AnnaHruskova/Hruskova_Portable_Audio_Player_with_USB_Audio_Interface/README.md

Prostudujte principy digitálního zpracování a reprodukce zvukových signálů v embedded systémech se zaměřením na běžné formáty digitálního audia, komprimované formáty, audio D/A převodníky a jejich rozhraní. Analyzujte možnosti realizace přenosného audio zařízení na platformě STM32 a navrhněte systémovou architekturu umožňující přehrávání zvukových souborů z paměťové karty a po připojení k počítači provoz zařízení jako USB zvukové karty a velkokapacitního úložiště. Zvolte vhodný mikrokontrolér, D/A převodník, paměťové médium, výstupní audio část, displej a systém napájení. Navrhněte elektrické a mechanické řešení zařízení, zpracujte schéma a desku plošných spojů zahrnující potřebné audio, USB, ovládací a napájecí obvody včetně bateriového napájení a nabíjení a připravte výrobní podklady prototypu. Realizujte a oživte zařízení a implementujte programové vybavení pro přehrávání zvukových souborů z paměťové karty, zejména ve formátech WAV a MP3, včetně základního uživatelského rozhraní. Implementujte USB rozhraní umožňující provoz zařízení jako USB zvuková karta a současně přístup k paměťovému médiu jako velkokapacitní úložiště a vyřešte přepínání jednotlivých provozních režimů. Experimentálně ověřte funkčnost zařízení, kvalitu reprodukce, USB komunikaci a uživatelské ovládání. Změřte spotřebu, stanovte předpokládanou dobu provozu na baterii a zhodnoťte možnosti dalšího rozšíření.

V rámci semestrální práce zpracujte teoretický rozbor problematiky, navrhněte systémovou architekturu a zpracujte elektrický a mechanický návrh zařízení včetně schématu, desky plošných spojů a výrobních podkladů.
