AnnaHruskova/Hruskova_Portable_Audio_Player_with_USB_Audio_Interface/latex_sablona/sablona-prace.pdf

## TITULNÍ LIST

Namísto této stránky vložte titulní list (s logem) vygenerovaný v IS VUT.

## ZADÁNÍ

Namísto této stránky vložte stránku zadání FEKT vygenerovanou v IS VUT.

ABSTRAKT

Abstrakt práce v originálním jazyce

KLÍČOVÁ SLOVA

Klíčová slova v originálním jazyce

ABSTRACT
Překlad abstraktu (v angličtině, pokud je originálním jazykem čeština či slovenština; v češtině či slovenštině, pokud je originálním jazykem angličtina)

KEYWORDS
Překlad klíčových slov (v angličtině, pokud je originálním jazykem čeština či slovenština; v češtině či slovenštině, pokud je originálním jazykem angličtina)

Vysázeno pomocí balíčku thesis verze 4.13; https://latex.fekt.vut.cz/

HRUŠKOVÁ, Anna. Přenosný audio přehrávač s USB zvukovým rozhraním. Semestrální

práce. Brno: Vysoké učení technické v Brně, Fakulta elektrotechniky a komunikačních technologií, Ústav telekomunikací, 2026. Vedoucí práce: Ing. Ondřej Krajsa, Ph.D.

## Prohlášení autora o původnosti díla

Jméno a příjmení autora: | Anna Hrušková
VUT ID autora: | 270800
Typ práce: | Semestrální práce
Akademický rok: | 2026/27
Téma závěrečné práce: | Přenosný audio přehrávač s USB zvuko- vým rozhraním

Prohlašuji, že svou závěrečnou práci jsem vypracoval samostatně pod vedením vedoucí/ho závěrečné práce a s použitím odborné literatury a dalších informačních zdrojů, které jsou všechny citovány v práci a uvedeny v seznamu literatury na konci práce. V souvislosti s vytvořením závěrečné práce jsem neporušil zásady a doporučení VUT k využívání generativní umělé inteligence.

Jako autor uvedené závěrečné práce dále prohlašuji, že v souvislosti s vytvořením této závěrečné práce jsem neporušil autorská práva třetích osob, zejména jsem nezasáhl nedovoleným způsobem do cizích autorských práv osobnostních a/nebo majetkových a jsem si plně vědom následků porušení ustanovení S 11 a následujících autorského zákona č. 121/2000 Sb., o právu autorském, o právech souvisejících s právem autorským a o změně některých zákonů (autorský zákon), ve znění pozdějších předpisů, včetně možných trestněprávních důsledků vyplývajících z ustanovení části druhé, hlavy VI. díl 4 Trestního zákoníku č. 40/2009 Sb.

Brno | | | | podpis autora∗

∗Autor podepisuje pouze v tištěné verzi.

PODĚKOVÁNÍ

Rád bych poděkoval vedoucímu bakalářské/diplomové/disertační práce panu Ing. XXX YYY, Ph.D. za odborné vedení, konzultace, trpělivost a podnětné návrhy k práci.

## Obsah

Úvod | 23
1 Digitální zpracování a reprodukce zvuku v embedded systémech | 25
2 Řešení návrhu desky plošných spojů | 31
2.1.1 | Lineární nabíječ akumulátoru s řízením napájecí cesty | . . . . 31
3 Výsledky studentské práce | 39
Závěr | 41
Literatura | 43
Seznam symbolů a zkratek | 45
Seznam příloh | 47
A Obsah elektronické přílohy | 49

## Seznam obrázků

2.1 Typický nabíjecí cyklus Li-Ion baterie | 32
2.2 Typické zapojení PCM510x | 34

## Seznam tabulek

1.1 Struktura hlavičky RIFF souboru WAV | 27
1.2 Struktura bloku fmt pro PCM WAV | 28
1.3 Struktura bloku data | 28

## Seznam algoritmů

## Seznam výpisů

## Úvod

Přenosný Přehrávač Médií – Portable Media Player (PMP) či Digitální Audio Přehrávač – Digital Audio Player (DAP) jsou přenosná zařízení určená pro uložení a přehrávání médií, jako je audio, video apod. Jedná se o zařízení kapesní velikosti, napájeného akumulátorem. Rovněž zvukové karty jsou dnes povětšině prodávány samostatně jako drahá zařízení, ačkoliv jejich hlavním úkolem je převádět digitální signál na analogový.
Cílem semestrální práce je navrhnout a realizovat rozměrem malé, kapesní zařízení, jenž bude pomocí procesoru STM32U575VIT6Q schopno z SD karty přehrávat audio soubory uložené na microSD kartě, a zároveň bude po připojení jako externí zařízení k počítači schopno reprodukovat a směřovat audio signál z počítače do sluchátek uživatele.

23

## 1 Digitální zpracování a reprodukce zvuku v

## embedded systémech

## 1.1 A/D a D/A převodníky

Jakmile je docíleno převodu zvukové energie na energii elektrickou, dalším krokem může být konverze z analogové roviny do digitální. Pro opačný přechod se využívá Digitálně analogový převodník – Digital to analog coverter (DAC). Audio Codec je poté označení pro ADC a DAC hardwarové komponenty dostupné v jednom pouzdře. Při rekonstrukci signálu z digitální do analogové podoby je důležité, aby signál splňoval Nyquistovu-Shannonovu vzorkovací podmínku. Ta hovoří o tom, že nejvyšší obsažená frekvence v původním pásmově omezeném signálu vynásobená dvěma by měla být menší než vzorkovací frekvence, protože ve spektru navzorkovaného signálu se kromě původního spektra nacházejí i jeho kopie posunuté o celočíselné násobky vzorkovací frekvence. Lze vyjádřit vztahem

fs > 2fmax, | (1.1)

kde fs je vzorkovací frekvence a fmax je nejvyšší frekvence původního signálu. Při dodržení Nyquist-Shannonova teorému se kopie nepřekrývají, lze tak spektrum oddělit rekonstrukčním filtrem dolní propust a ze vzorků původní signál obnovit. Při nedodržení vzniká aliasing, jenž ani D/A převod ani rekonstrukční filtr nemohou odstranit [2, s. 96–99]. Filtry dolní propusti nejsou ideální a takřka žádné praktické využití nebude vzorkovat přesně na dvojnásobku, proto je jedna z často využívaných vzorkovacích frekvencí pro reprodukci hudby 44,1 kHz a ne 40 kHz [1].

## 1.2 Delta-sigma D/A převodníky

DAC převodníky lze rozdělit na dvě kategorie: ty pracující na Nyquistově vzorkovací frekvenci a převodníky s převzorkováním. Převodníky z první kategorie pracují s poměrem 1:1 vstupní ku výstupním vzorkům a každý vzorek je samostatně zpracován, bez ohledu na předchozí vzorky; jsou bezpamětné. Přivedením vstupního digitálního slova s bity b1 až bN vede tedy na výstup

Uout = Uref (︁
b12

−1 + b22

−2 + · · · + bN 2

−N ,

)︁
| (1.2)

kde Uref je referenční napětí nezávislé na předchozím slově. Pro tento typ převodníků může být vzorkovací frekvence fvz až na spodní hranici splnění Nyquistova kritéria. Technologický rozptyl parametrů (souběh, anglicky component matching, matching accuracy, vyjadřující jak přesně jsou si podobné součástky stejného typu a jmenovité

25 hodnoty) je v praxi omezen asi na cca 0,02 %. Tím pádem je ovlivněn i Efektivní počet bitů – Effective Number of Bits (ENOB) na přibližně 12, ale mnoho audio zařízení vyžadují až 18 či 20 bitů. Takové Nyquistovy převodníky vyžadují více času, jsou pro zpracování audio signálu příliš pomalé.
Převzorkovací převodníky jsou schopny dosáhnout až 20 ENOB při vyšších rychlostech, využívají vzorkovací frekvenci 8krát až 512krát vyšší než je Nyquistova frekvence a výstup generují na základě předchozích hodnot (obsahují paměťové prvky).

## 1.3 PCM

Nejjednodušší digitální reprezentací signálu je Pulzně kódová modulace – Pulse-code modulation (PCM); pro každou periodu vzorkování je okamžitá hodnota analogového signálu (amplituda) zakódována s příslušnou digitální úrovní. Parametry PCM jsou vzorkovací frekvence, například 44,1 kHz, používaná nejčastěji u CD, až po hodnoty 192 kHz, a rozlišení hodnot digitálních úrovní (bitové hloubky vzorku). Každé kvantování přináší do nového signálu kvantizační šum, nikdy nelze okamžité hodnoty analogového signálu interpolovat s dokonalo přesností, jde to pouze limitně. Při vstupním rozsahu o dané velikosti vede nižší bitová hloubka k větší kvantizační chybě.
Datový tok závisí i na počtu kanálů. Pokud je vzorkovacá frekvence 44,1 kHz a bitová hloubka je 16 bitů, na jeden kanál připadá 705,6 kbit/s. Stereofonní signál obsahuje kanály dva, proto daotvý tok jeho vzorků je 1411,2 kbit/s (tedy 176,4 kB/s) [1, s. 181].
Stereofonní zvukový záznam o vzorkovací frekvenci 44,1 kHz, bitové hloubce 16 bit o délce tří minut bude tedy vyžadovat velikost úložiště 31,752 MB, podle výpočtu

Velikost =

44100 · 16 · 2 · 180
8
= 31752000B = 31, 752MB | (1.3)

## 1.4 Formáty audio souborů

Jesliže jsou zvukové soubory již k dispozici, je potřeba zajistit jejich správné načtení a interpretaci. Existují nekomprimované a komprimované zvukové soubory. U nekomprimovaného PCM jsou uloženy hodnoty jednotlivých vzorků bez jakékoliv komprese. Při jejich zpracování a následném přehrávání je zapotřebí získat informace o jejich formátu, vyhledat zvuková data a následně je zpracovat podle zjištěných parametrů. Komprimované audio záznamy vyžadují navíc dekódování, kdy se z komprimované reprezentace dat získá posloupnost jednotlivých zvukových vzorků. Komprese může být bezztrátová nebo ztrátová.

26

### 1.4.1 Formát souboru WAV

Zvukový formát WAV běžně obsahuje nekomrpimované PCM, může obsahovat ale i
jiné způsoby kódování. Popis zvukového formátu používaný ve struktuře WAVEFORMATEX zahrnuje identifikaci kódování (wFormatTag), počet kanálů (nChannels), vzorkovací frekvenci jednotlivých kanálů (nSamplesPerSec), průměrný bajtový tok (nAvgBytesPerSec), blokové zarovnání (nBlockAlign) a počet bitů na vzorek (wBitsPerSample). Pro celočíselné PCM označuje kódování konstanta WAVE_FORMAT_PCM s hodnotou 0x0001; blokové zarovnání pak odpovídá velikosti vzorkovacího rámce [3].
Formát WAV (Waveform Audio File Format) je založen na kontejnerovém formátu RIFF (Resource Interchange File Format). Soubor ve formátu RIFF se skládá z jednotlivých bloků označovaných jako chunks. Každý blok je identifikován čtyřznakovým identifikátorem FOURCC (Four-Character Code).
V případě běžného nekomprimovaného PCM WAV souboru se struktura skládá z hlavičky RIFF a následných bloků fmt a data. Následující tabulky popisují základní variantu nekomprimovaného PCM WAV souboru s 16bajtovou datovou částí bloku fmt a bez dalších vložených bloků. Offsety jsou uváděny od začátku souboru. V této variantě začínají vlastní zvuková data na offsetu 44 B. Základní struktura hlavičky RIFF je uvedena v tabulce 1.1.

Tab. 1.1: Struktura hlavičky RIFF souboru WAV

Pole | Offset [B] Velikost [B] | Význam
ChunkID | 0 | 4 | ASCII řetězec RIFF
ChunkSize | 4 | 4 | Velikost souboru bez prvních 8 bajtů
Format | 8 | 4 | ASCII řetězec WAVE

Pole ChunkID obsahuje posloupnost znaků RIFF, odpovídající bajtům 52 49 46
46. Pole ChunkSize udává velikost zbývající části RIFF bloku, tedy v případě základního WAV souboru velikost celého souboru zmenšenou o 8 bajtů. Pole Format obsahuje identifikátor WAVE.
Za hlavičkou RIFF následuje blok fmt, popisující formát uložených zvukových dat. Jeho struktura pro nekomprimovaný PCM signál je uvedena v tabulce 1.2. Hodnota pole ByteRate je určena vztahem

ByteRate = SampleRate · NumChannels ·

BitsPerSample
8
. | (1.4)

Podobně lze velikost jednoho vzorkovacího rámce vyjádřit jako

BlockAlign = NumChannels ·

BitsPerSample
8
. | (1.5)

27

Tab. 1.2: Struktura bloku fmt pro PCM WAV

Pole | Offset [B] Velikost [B] Význam
Subchunk1ID | 12 | 4 | ASCII řetězec fmt
Subchunk1Size | 16 | 4 | Velikost datové části bloku; v popiso-
| | | vané základní variantě 16 B
AudioFormat | 20 | 2 | Formát zvukových dat; hodnota 1
| | | označuje PCM
NumChannels | 22 | 2 | Počet zvukových kanálů; 1 pro mono, 2
| | | pro stereo
SampleRate | 24 | 4 | Vzorkovací frekvence v Hz, například
| | | 48 000 Hz
ByteRate | 28 | 4 | Počet bajtů za sekundu
BlockAlign | 32 | 2 | Počet bajtů jednoho vzorkovacího
| | | rámce
BitsPerSample | 34 | 2 | Bitová hloubka jednoho vzorku

Vzorkovací rámec zde představuje vzorky všech kanálů náležející ke stejnému okamžiku vzorkování. Například u 16bitového stereofonního signálu má jeden rámec velikost 4 B.
Za blokem fmt se v základní podobě PCM WAV souboru nachází blok data, který obsahuje vlastní zvuková data.

Tab. 1.3: Struktura bloku data

Pole | Offset [B] Velikost [B] Význam
Subchunk2ID | 36 | 4 | ASCII řetězec data
Subchunk2Size | 40 | 4 | Počet bajtů zvukových dat
Data | 44 | proměnná | Jednotlivé vzorky zvukového signálu

Velikost datové části lze pro PCM signál vyjádřit jako

Subchunk2Size = Nsamples · NumChannels ·

| | | BitsPerSample
| | | 8
, | (1.6)

kde Nsamples představuje počet vzorků jednoho kanálu.
Vícebajtové číselné hodnoty jsou ve standardním WAV souboru ukládány v pořadí little-endian. Například 32bitová hodnota 0x12345678 je tedy v souboru uložena jako posloupnost bajtů 78 56 34 12. Čtyřznakové identifikátory, například RIFF, WAVE, fmt nebo data, jsou naproti tomu ukládány přímo jako posloupnost ASCII znaků[?].

28

Načítání WAV do STM32

https://www.phippselectronics.com/how-to-play-a-wav-file-on-stm32/

29

## 2 Řešení návrhu desky plošných spojů

## 2.1 Napájecí část

### 2.1.1 Lineární nabíječ akumulátoru s řízením napájecí cesty

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

ICHG =

KISET
R5

=

890AΩ
3160Ω
≈ 282mA. | (2.1)
- dva režimy napájení pomocí pinů EN2 (stáhnutý ke GND, vždy tedy logická 0) a pin EN1 řízený MCU STM32 a současně připojen na R2 = 100 kOhm k VBUS. Pokud je VBUS přítomný, ale je neaktivní řízení z MCU, výchozí stav je USB500, pokud EN2 = 0 (default) a EN1 = 1. POkud EN1 je stařen do logické nuly, nastaví se stav USB100. Vstupní limit je společný pro napájení přehrávače i nabíjení baterie. Po připojení USB se automaticky měnič zapne
- pin OUT: při dostatečném vstupním napájení je OUT regulovaný na cca 4,4V, baterie se mezitím nabíjí na 4,2V. síť ;"sys_power"neposkytuje stabilizovaných 3,3V, bez vstupního napětí je tato větev napájena z baterie přes vnitřní tranzistor. Napětí 3,3V vytváří až navazující měnič.
- konfigurace kondenzátorů kolem C4 na vstupu IN C2 na výstupu OUT, oba kapacitu 4,7uF. Kondenzátor C3 mezi BAT a GND má 10 uF.
- tepelné ztráty lineárního nabíjení jsou podle P = (Uin - Ubat) Icharge, při 5V pro Uin, 3,7V Ubat a Icharge 282 mA vychází P = 0,37 W. tepelná regulace může

31 snížit nabíjecí proud, podle datasheetu 9.3.5.8 je již zabudovaná v BQ24074, obvod sám sleduje svou vnitřní teplotu a reguluje nabíjecí proud. Hondota P = 0,37 W představuje pouze ztráty spojené s nabíjecím proudem,
- odvod tepla z BQ24074 zajištěn propojením zemní mědí (GND) a exponované tepelné plošky pouzdra, podle doporučení návrhu DPS.
- zapojení je připraveno pro sledování teplopty akumulátoruy pomocí NTC termistoru připojeného třetím vývodem J2 na vstup TS
- z datasheetu byl vzán tento průběh nabíjení baterie LiIon pro ilustraci


Obr. 2.1: Typický nabíjecí cyklus Li-Ion baterie

Zelená přerušovaná křivka v grafu 2.1 představuje napětí na svorkách baterie UBat, červená křivka pak představuje proud jdoucí do baterie IBat. Osa X představující časovou osu, je schematická, nelze určit jednotlivou délku, skutečné hodnoty jednotlivých fází by mohly být doplněny měřením audio zařízení. Jde pouze o principiální ilustrativní průběh, ne o skutečnou měřenou charakteristiku. VBat(reg) zde představuje regulované koncové nabíjecí napětí, pro návrh přenosného audio přehrávače jde o 4,2 V. VLow je práh přechodu z přednabíjení do hlavního nabíjení, hodnota pro návrh typicky 3,0V, s mezemi 2,9 V-3,1V. Io(chg) je nastavený proud nabíjecí fáze, nastavený podle schématu na 282 mA. IPrechg je proud přednabíjení, nastavený na 28 mA (0.1xIo) Iterm je proudový práh ukončení nabíjení, pro režim USB100 je to 9,3 mA, pro režim USB500. Pin ITERM je ponechán nezapojený, typický ukončovací proud činí proto přibližně 28,2 mA v režimu USB500 a 9,3 mA v režimu USB100.

32

Precharge

Jestliže má baterie před zahájením nabíjení napětí nižší než Vlowv, nabíječ nejprve použije malý proud IPrechg, proto je červená křivka průběhu nabíjení zde konstantní na jedné nízké úrovni. Náboj dodávaný nabíječem BQ24074 postupně zvyšuje napětí baterie (zelená postupně rostoucí křivka). Tento proces je zapotřebí, jestliže se baterie nachází v silně vybitém stavu, dodávání proudu IPrechg nemusí tedy být při každém nabíjení. Pokud je prah Vlowv překročen, poté nabíječ může zvýšit proud, začíná pak hlavní nabíjecí fáze. Vlow řídí pouze přechod z přednabíjecí řásti do plně nabíjecí (do fáze nabíjení konstantním proudem).

Fast Charge CC

CC = constant current, nabíječ udržuje nabíjecí proud přibližně na hodnotě Io(chg), napětí na baterii postupně roste. Proud nastavuje rezistor R5 ze schématu zapojení, podle rovnice (2.1). Jakmile je dosaženo napětí na betrii 4,2V, přejde se na další část nabíjení.

CV Taper, nabíjení konstantním napětím

CV = constant voltage, nabíječ v této fázi udržuje napětí baterie okolo Vbat(reg) (vodorovná zelená křivka). Velikost dodávaného proudu klesá. Taper = postupné snižování proudu. Proud nemusí klesat lineárně, závisí na velikosti samotné baterie (kapacitě a vlastnostech akumulátoru), teplotě nebo i na stavu opotřebení akumulátoru. Nabíječ dále sleduje dosažení ITerm, poté může být nabíjení ukončeno.

done, ukončení nabíjení

Při této fázi nabíječ přestane dodávat proud do baterie,na grafu se jedná o pokles z Iterm na 0. Pin CHG je typu open drain, tedy výstup s otevřeným odtokem tranzistoru MOSFET. ve stavu vysoké impedance přestává stahovat signál k zemi, rezisotr R8 ze schématu přitáhne CHG_status k 3,3V. Tento stav nastává i při nepřítomném vstupním napětí VBUS z UBSC. (po odpojení usbc neprobíhá nabíjení, výstup CHG přejde do stavu vysoké impedance, pokud přehrávač dále beží z baterie, R8 přitáhne chg_status na 3,3V). Výstup CHG současně ovládá LED D2 napájenou z VBUS přes rezistor R36 = 1,5 kOhm. Úroveň je stejná při dokončeném nabíjení i při odpojení

usb-c, proto je důležité i sledovat CHG_PGOOD signalizující přítomost platného vstupního napájení. (Vysoká úroveň CHG_STATUS sama nepotvrzuje úplné nabití. Stav je nutné vyhodnocovat spolu se signálem CHG_PGOOD, který při platném vstupním napájení přechází do logické nuly.“))

33

## 2.2 TPS63070

## 2.3 Audio řetězec

### 2.3.1 D/A převodník PCM5102A

typické zapojení podle datasheetu


Obr. 2.2: Typické zapojení PCM510x

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

34

- C26 - nízká parazitní indukčnost, odvádí ryché proudové špičky - doporučeno TI
- C27 - dobrý na pomalejší změny odběru proudu - doporučeno TI
- C28 (100 nF, potlačuje rychlé rušení vznikající při spínání nábojové pumpy) a C29 (10 uF, stabilizuje 3,3 V napájení) - protože pin CPVDD odebírá proud v pulzech, pulzy mohou vytvoři rušení - hodnoty převzaté z doporučení Texas Instruments.
- C30 a C 31 - stejně jako u C26 a C27.
- C32 - filtrace a stabilizace interního LDO (interního napěťového regulátoru, vytářející cca 1,8 V z 3,3 V pro )
- C33 - filtrace vf

Výstupní analogový filtr RC

- kondenzátory C24, C25 filtrují vf složky pro každý kanál do země -> filtr dolní propust - aby filtr neovlivnil amplitudu/fázi slyšitelných vyšších tónů, volí se mezní frekvence 7 krát až 10 krát vyšší než 20 kHz. Hlavně je zapotřebí vyfiltrovat frekvence v MHz - hodnoty rezistory C22 a C23 jsou natolik nízké, že neovlivní úbytek sigálu na vstupní impedanci běžného koncového zesilovače.
fc =

1
2πRC =

1
2π·470·2,2·10⁻⁹ ≈ 154kHz

Sluchátkový zesilovač TPA6111A2D

Zesílení analogového stereofonního signálu z D/A převodníku PCM5102A je docíleno pomocí integrovaného sluchátkového zesilovače TPA6111A2D od Texas Instruments. Obvod obsahuje dva nezávislé zesilovací kanály v invertujícím zapojení, umožňuje provoz při 3,3 V.
Zesílení jednotlivých kanálů je určeno poměrem zpětnovazebního rezistoru RF a vstupního rezistoru RI , platí vztah Av = −

RF
RI

, kde pro RF i RI jsou zvoleny hodnoty 20 kohm, tedy Av = −

20komℎ
20koℎm = −1. Napěťové zesílení se tedy rovná jedné, rovno zesílení 0 dB, nedochází k změně amplitudy. Záporné znaménko zde vyjadřuje fázovou inverzi o 180 stupňů. Zvolená konfigurace odpovídá doporučenému zapojení uvedené v technické dokumentaci dané součástky.
Ekvivalentní odpor působící na invertující vstup zesilovače je dán paralelní kombinací RF a RI , Req =

RF RI
RF +RI

= 10, kΩ, tato hodnota je v rámci doporučení výrobcem, tedy od 5 kOhm do 20 kOhm.
Při návrhu bylo zohledněno rozdílné napěťové rozmezí výstupních signálů D/A převodníku a sluchátkového zesilovače. Převodník PCM5102A při plném vybuzení

35 dosahuje výstupní úrovně 2,1 V RMS (5,94 V špička špička, mnohem více, než zesilovač dokáže reprodukovat bez zkreslení). Regulace hlasitosti bude proto řícena digitálním útlumem PCM vzorků v mikrokontroléru STM32. Maximální úroveň bude stanovena s ohledem na výstupní napěťový rozkmit zesilovače, s ohledem na impedanci připojených sluchátek. . .
Ostatní komponenty ve schématu okolo TPA6111A2D
Vstupní vazební kondenzátory C38 a C39 (1 µF), sériově zapojeny mezi výstupy D/A převodníku a vstupy zesilovače, oddělující stejnosměrné složky signálu. Společně se vstupními rezistory R24 a R26 vytváření RC filtr horní propusti, určující dolní mezní kmitočet přenosové charakteristiky = 8 Hz.

fc =

1
2πRICI

=

1
2π · 20 × 10³
- 1 × 10⁻⁶
≈ 7,96 Hz | (2.2)

Kondenzátor C34 o kapacitě 1 uF, ovlivňuje časový průběh náběhu interního předpětí, čímž omezuje vznik nechtěných impulzů při zapnutí zesilovače. Blokovací kondenzátory C37 (potlačující vysokofrekvenční rušení a rychlé napěťové přechody), C40, zlepšují stabilitu napájení a omezují nežádoucí vlivy napájecího rušení na výstupní audio signál.

XC =

1
2πfC | (2.3)

S rostoucí frekvencí klesá kapacitní reaktance, kondenzátor představuje pro vf složky nízkoimpedanční cestu ke GND.
Výstupní vazební kondenzátory C17, C18 polarizované elektrolytické, zabraňují průchodu stejnosměrné složky do připojených sluchátek. Zvolená kapacita 470 µF pro sluchátka o impedanci 32 Ohm odpovídá dolní mezní frekvenci 10,58 Hz, podle

fc =

1
2πRLCout

=

1
2π · 32 · 470 × 10⁻⁶
≈ 10,58 Hz | (2.4)

### 2.3.2 Periferie

SD karta
displej

### 2.3.3 Napájení

Lithium-polymerový akumulátor (Li-Po) - vybíjecí charakteristiky? Power Path

36

## 2.4 Realizace Hardware části práce

### 2.4.1 Schéma zapojení napíjecí části

### 2.4.2 Schéma zapojení analogové audio části

Výpočet součástek kolem čipu PCM5102A
Výpočet součástek kolem čipu TPA6111A2D
- zpětnovazební rezistory pro zisk
- výpočet dolního mezního kmitočtu vstupních a výstupních kondenzátorů

### 2.4.3 Návrh PCB desky

Rozmístění součástek po desce

37

## 3 Výsledky studentské práce

Praktická část a výsledky studentské práce vhodně rozdělené do částí.

## 3.1 Programové řešení

Lorem [?].

## 3.2 Výsledky měření

Fusce

39

## Závěr

Není automatické hlídání teploty akumulátoru, R11 nahrazen NTC...

41

## Literatura

[1] KATZ, David J. a GENTILE, Rick. Embedded Media Processing. Burlington, MA: Newnes (Elsevier), 2005. ISBN 978-0-7506-7912-1.
[2] SMÉKAL, Zdeněk a SKLENÁŘ, Jaroslav. 1D and 2D Analog, Discrete, and

Digital Signal Processing. Brno: VUTIUM, 2023. ISBN 978-80-214-6143-7.

[3] MICROSOFT. WAVEFORMATEX structure (mmeapi.h) [online]. Microsoft Learn. Aktualizováno 2021-04-02 [cit. 2026-11-08]. Dostupné z:

https://learn.microsoft.com/en-us/windows/win32/api/mmeapi/ns-mmeapi-waveformatex. (https://learn.microsoft.com/en-us/windows/win32/api/mmeapi/ns-mmeapi-waveformatex)

43

## Seznam symbolů a zkratek

Li-Po | Lithium-polymerový akumulátor
PMP | Přenosný Přehrávač Médií – Portable Media Player
DAP | Digitální Audio Přehrávač – Digital Audio Player
DAC | Digitálně analogový převodník – Digital to analog coverter
PCM | Pulzně kódová modulace – Pulse-code modulation
ENOB | Efektivní počet bitů – Effective Number of Bits
SNR | Odstup signálu od šumu – Signal-to-Noise Ratio

45

## Seznam příloh

A Obsah elektronické přílohy | 49

47

## A Obsah elektronické přílohy

Elektronická příloha je často nedílnou součástí semestrální nebo závěrečné práce. Vkládá se do informačního systému VUT v Brně ve vhodném formátu (ZIP, PDF . . . ). Nezapomeňte uvést, co čtenář v této příloze najde. Je vhodné okomentovat obsah každého adresáře, specifikovat, který soubor obsahuje důležitá nastavení, který soubor je určen ke spuštění, uvést nastavení kompilátoru atd. Také je dobře napsat, v jaké verzi software byl kód testován (např. Matlab 2018b). Pokud bylo cílem práce vytvořit hardwarové zařízení, musí elektronická příloha obsahovat veškeré podklady pro výrobu (např. soubory s návrhem DPS v Eagle).
Pokud je souborů hodně a jsou organizovány ve více složkách, je možné pro výpis adresářové struktury použít balíček dirtree. (https://www.ctan.org/pkg/dirtree)
/ | kořenový adresář přiloženého archivu
logo | loga školy a fakulty
BUT_abbreviation_color_PANTONE_EN.pdf
BUT_color_PANTONE_EN.pdf
FEEC_abbreviation_color_PANTONE_EN.pdf FEKT_zkratka_barevne_PANTONE_CZ.pdf UTKO_color_PANTONE_CZ.pdf
UTKO_color_PANTONE_EN.pdf
VUT_barevne_PANTONE_CZ.pdf
VUT_symbol_barevne_PANTONE_CZ.pdf VUT_zkratka_barevne_PANTONE_CZ.pdf
obrazky | ostatní obrázky
soucastky.png
spoje.png
ZlepseneWilsonovoZrcadloNPN.png
ZlepseneWilsonovoZrcadloPNP.png
pdf | pdf stránky generované informačním systémem
student-desky.pdf
student-titulka.pdf
student-zadani.pdf
text | zdrojové textové soubory
literatura.tex
prilohy.tex
reseni.tex
uvod.tex
vysledky.tex
zaver.tex
zkratky.tex
sablona-obhaj.tex | hlavní soubor pro sazbu prezentace k obhajobě
sablona-prace.tex | hlavní soubor pro sazbu kvalifikační práce
thesis.sty | balíček pro sazbu kvalifikačních prací

49
