AnnaHruskova/Hruskova_Portable_Audio_Player_with_USB_Audio_Interface/latex/bc_in_progress.pdf

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

1.4.1 TVS ochrana SD karty

ESD/TVS obvody vhodné pro 3,32bitová

- rychlá doba sepnutí - rychlé zachycení tranzient·
- SDMMC komunikace probíhá na vysokých kmito£tech CITACE (20 aº 50 MHz),

je pot°eba aby TVS IP m¥l velmi nízkou parazitní kapacitu, jinak by CLK signál m¥l

zaoblené hrany

- TPD6E05U06RVZR, kapacita 0,47pF
- USBLC6-4SC6, kapacita 0,97pF, ale je nutné pouºít dva, uº mají footprint v

KiCADU

### 1.5. PCM5102A

typické zapojení podle datasheetu

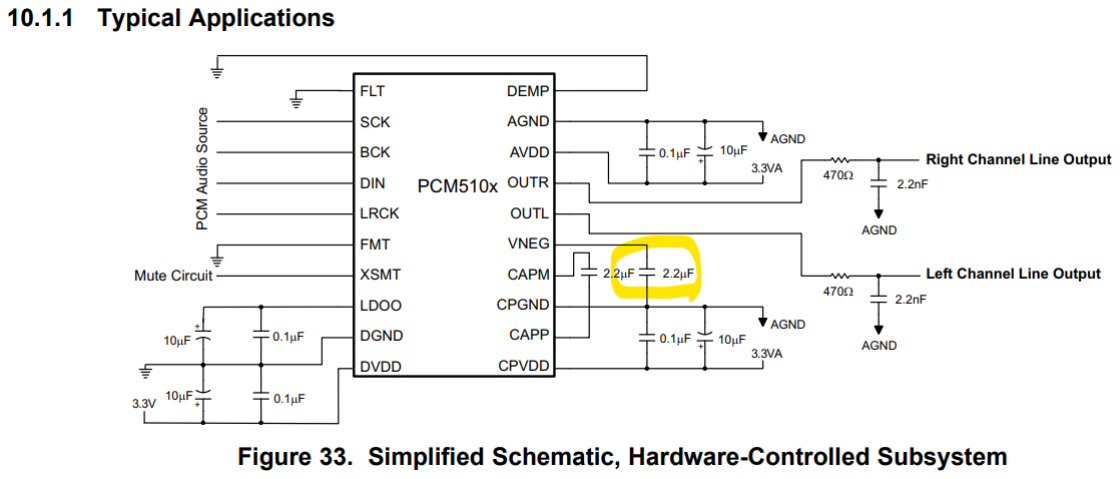
[picture p3: figure]

Obrázek 1: Typické zapojení PCM510x

Obsahuje integrovanou nábojovou pumpu - vytvá°í záporné napájecí nap¥tí p°estoºe

je £ip krmen 3,3 V. DAC má pak soust°ed¥ný výstup kolem 0V. Ale je zapot°ebí p°idat

dva kondenzátory mezi CAPP a CAPM piny (2 a 4, pouºívá se pro p°enos náboje), a

potom je²t¥ jeden mezi VNEG a CPGND piny (5 a , ltruje vztvo°ené záporné nap¥tí).

PIN 10 DEMP na GND, vypne se tam de-emphasis.

PIN 11 FLT na GND, takºe je pouºít normální FIR ltr.

PIN 12 SCK na GND, takºe je pouºít interní PLL bez externího MCLK

PIN 16 FMT na GND, jde o standardní I2S formát.

PIN 17 XSMT, p°ipojen na 3,3V.
- ip vyuºívá Direct Path, nepot°ebuje na audio výstupu odd¥lovací kondenzátory,

4

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

Pro zesílení st°ídavého nap¥tí platí

AV = −

RF

RIN

= −

10 kΩ
20 kΩ

= −0,5 V/V

fc,OUT =

1
2π · RL · COUT

fc,OUT =

1
2π · 32 Ω · 470 · 10⁻⁶ F

≈ 10,58 Hz

Podle doporu£ení TI by m¥l být efektivní odpor na invertujícím vsutpu být p°ibliºn¥

od 5K do 20K, p°i paralelním zapojneí 2 rezistor· o hodnot¥ 10K tedy

Re =

RfRi
Rf + Ri

=

10000 · 10000
10000 + 10000

= 5 kΩ

- C35 C36 blokují stejnosm¥rnou sloºku (nap¥tí kolem 1,65 V). Pouºít spí²e pola-

rizované kondenzátory.

- C34 potla£ení lupnutí p°i zapnutí

6

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
