AnnaHruskova/Hruskova_Portable_Audio_Player_with_USB_Audio_Interface/blok_schema.png

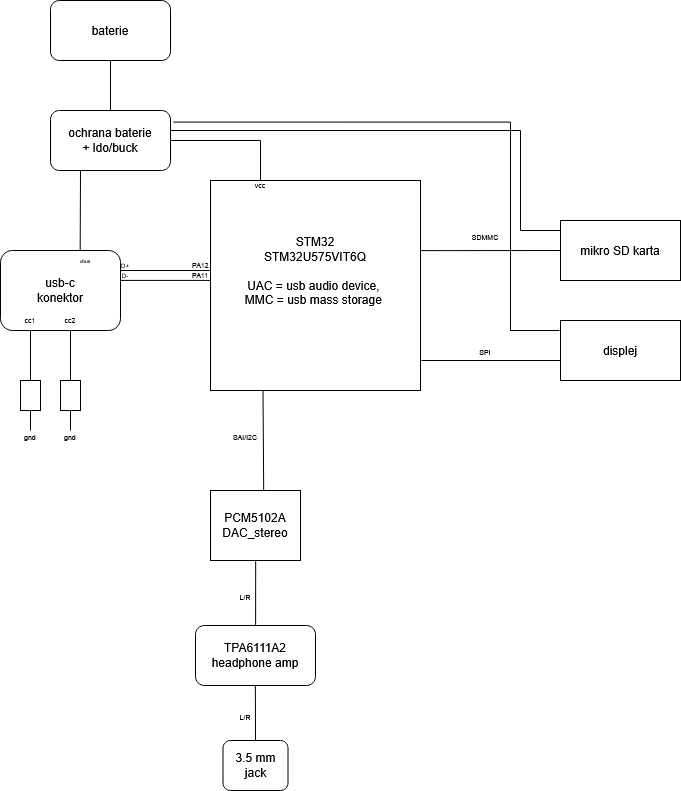
blok_schema.png
