AnnaHruskova/Hruskova_Portable_Audio_Player_with_USB_Audio_Interface/latex/LP5907_LDO_kondenzatory.png

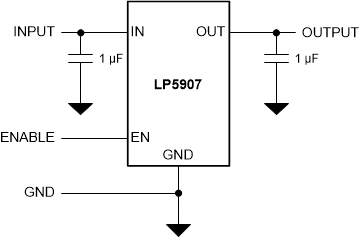
latex/LP5907_LDO_kondenzatory.png
