AnnaHruskova/Hruskova_Portable_Audio_Player_with_USB_Audio_Interface/latex/photos/battery_protection_circuit.png

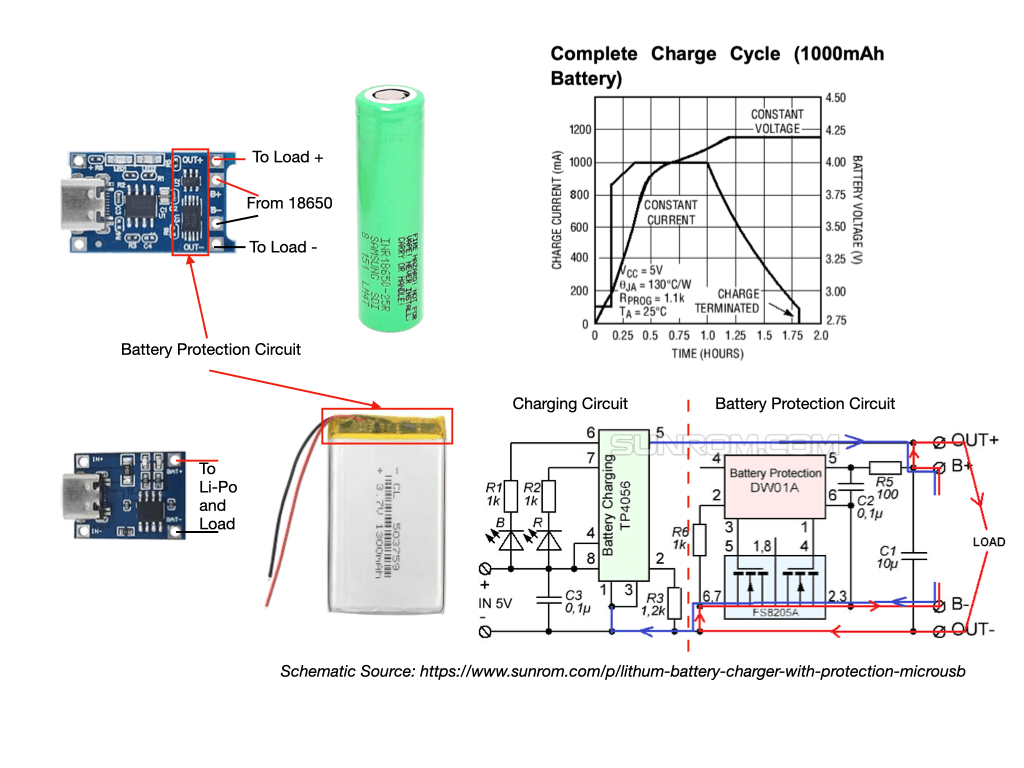
latex/photos/battery_protection_circuit.png
