AnnaHruskova/Hruskova_Portable_Audio_Player_with_USB_Audio_Interface/latex/photos/design-review-power-circuitry-for-lipo-powered-board-v0-ilq4whvbs4sa1.webp

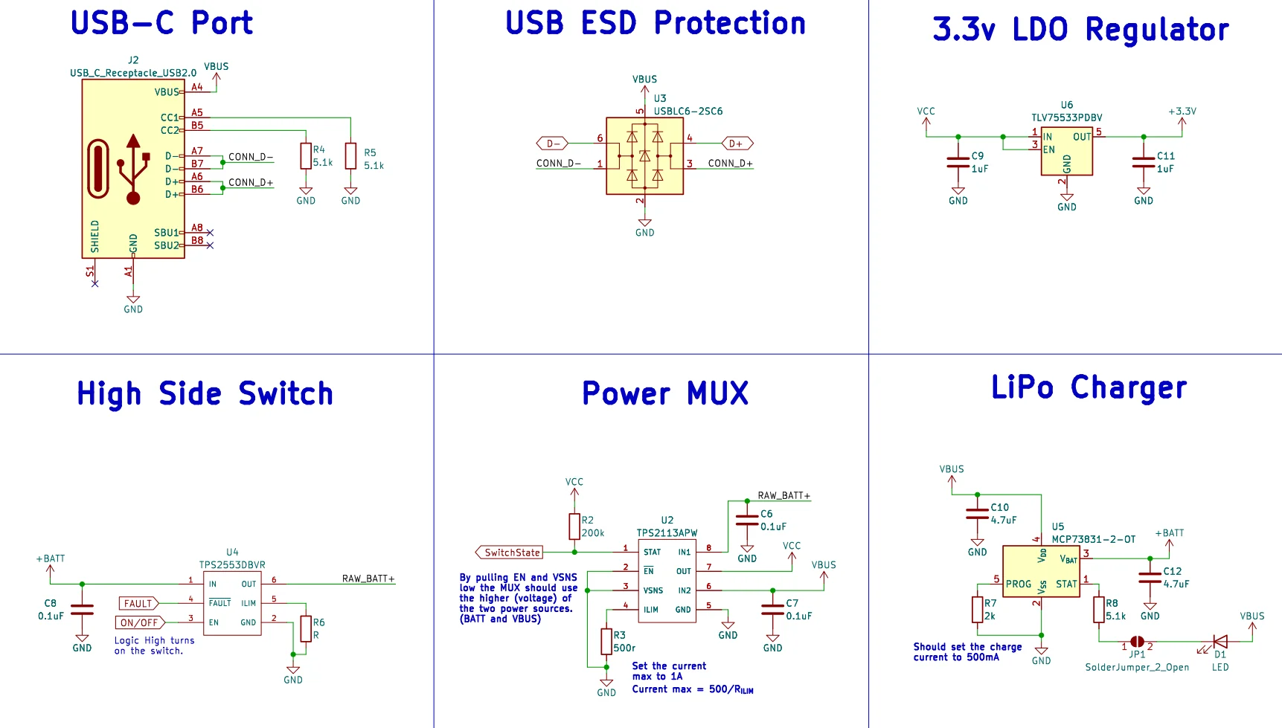
latex/photos/design-review-power-circuitry-for-lipo-powered-board-v0-ilq4whvbs4sa1.webp
