AnnaHruskova/Hruskova_Portable_Audio_Player_with_USB_Audio_Interface/latex/photos/esd_optimised_layout.png

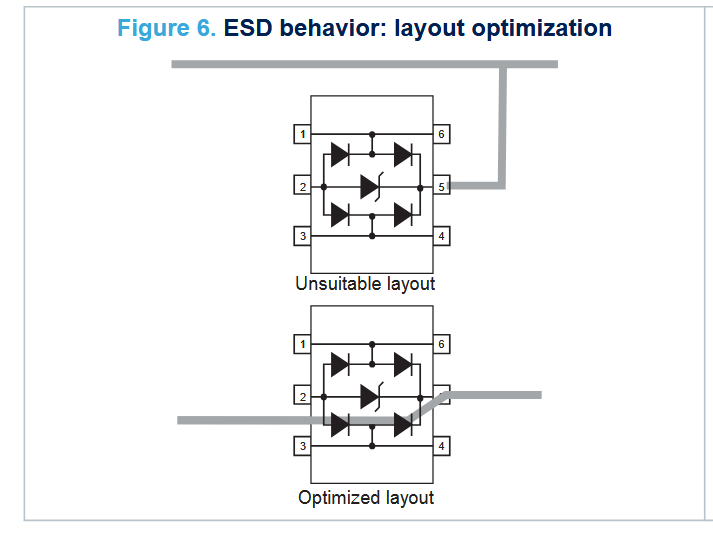
latex/photos/esd_optimised_layout.png
