AnnaHruskova/Hruskova_Portable_Audio_Player_with_USB_Audio_Interface/pcb_edit.png

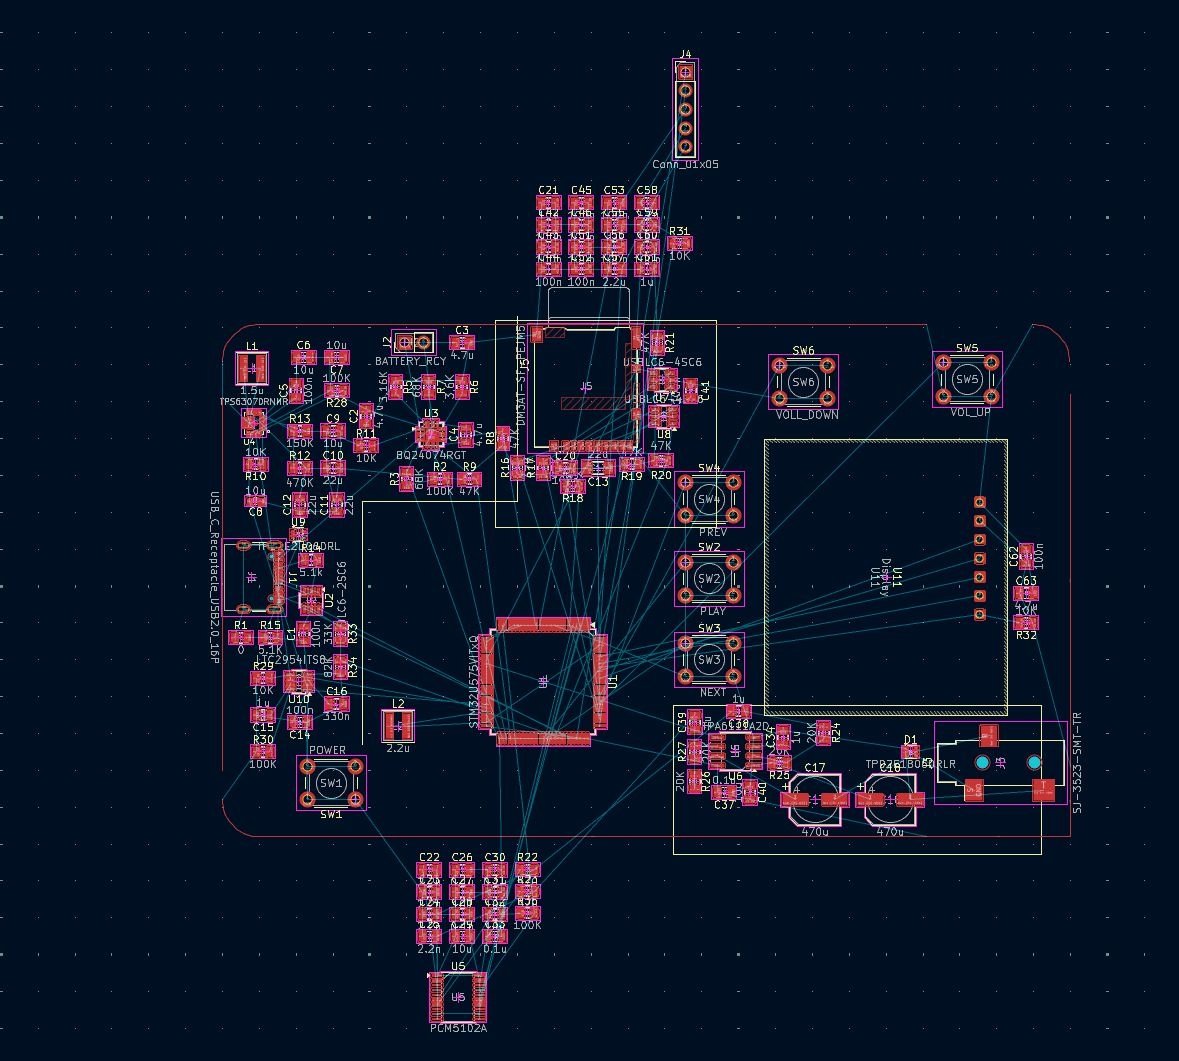
pcb_edit.png
