AnnaHruskova/Hruskova_Portable_Audio_Player_with_USB_Audio_Interface/components.xlsx

PCM5102A sheet
 |  | value | footprint | komponent | dostupnost JCSC | pozn
C22 | mezi CAPP, CAPM, nábojová pumpa | 2.2u | Capacitor_SMD:C_0805_2012Metric. | CL21B225KOFNNNE | 26K skladem | 2,2uF, 16 , X7R, +-10% | blízko pinům | https://product.samsungsem.com/mlcc/CL21B225KOFNNN.do
C23 | nábojová pumpa u VNEG | 2.2u | Capacitor_SMD:C_0805_2012Metric. | CL21B225KOFNNNE |  | stejny | blízko pinům | https://product.samsungsem.com/mlcc/CL21B225KOFNNN.do
C24 | L výstup RC filtr | 2,2 nF | Capacitor_SMD:C_0805_2012Metric. | Samsung CL21C222JBFNNNE |  | C0G/NP0 +- 5% --> níké zkreslení a stabilní fc
C25 | R výstup RC filtr | 2,2 nF | Capacitor_SMD:C_0805_2012Metric. | Samsung CL21C222JBFNNNE |  | stene jako C25
C26 | vf filtr, avdd | 0.1u | Capacitor_SMD:C_0805_2012Metric. | Yageo CC0805KRX7R9BB104 |  | 100n, 50V, X7R, | co nejblíže pinu AVDD, krátce do gnd
C27 | avdd zásobní c | 10u | Capacitor_SMD:C_1206_3216Metric | Murata GCJ31CR71C106KA15L |  | 16Vm X7R, 1206 - lepší rezerva vůči poklesu c | co nejblíže DAC
C28 | CPVDD - vf blok | 0,1u | Capacitor_SMD:C_0805_2012Metric. | Yageo CC0805KRX7R9BB104 |  | 100 nF, 50V, X7R
C29 | CPVDD - zásobní c | 10u | Capacitor_SMD:C_1206_3216Metric | Murata GCJ31CR71C106KA15L |  | 10 µF, 16 V, X7R, ±10 %, 1206.
C30 | DVDD - vf blok | 0,1u | Capacitor_SMD:C_0805_2012Metric. | Yageo CC0805KRX7R9BB104 |  | 100 nF, 50V, X7R | co nejblíže DAC
C31 | DVDD - zásobní c | 10u | Capacitor_SMD:C_1206_3216Metric | Murata GCJ31CR71C106KA15L |  | 10 µF, 16 V, X7R, ±10 %, 1206.
C32 | LDOO zásobní c | 10u | Capacitor_SMD:C_1206_3216Metric | Murata GCJ31CR71C106KA15L |  | 10 µF, 16 V, X7R, ±10 %, 1206. | ověřit C_eff při ~1,8V, požadavky LDO
C33 | LDOO - vf blok | 0,1u | Capacitor_SMD:C_0805_2012Metric. | Yageo CC0805KRX7R9BB104 |  | 100 nF, 50V, X7R | blízko LDOO
R22 | výstupní RC filtr | 470R | Resistor_SMD:R_0805_2012Metric | UNI-ROYAL 0805W8F4700T5E |  | 470 Ohm +-1%, 0805 výkonově stačí | S C24 tvoří LPF 1. řádu
R23 | výstupní RC filtr | 470R | Resistor_SMD:R_0805_2012Metric | UNI-ROYAL 0805W8F4700T5E |  | 470 Ohm +-1%, 0805 výkonově stačí | S C25 tvoří LPF 1. řádu
R35 |  | 100k | Resistor_SMD:R_0805_2012Metric | Yageo RC0805FR-07100KL |  | 100 kΩ, ±1 %, 0,125 W
U5 | D/A převodník | PCM5102A |  | TI PCM5102APWR |  | TSSOP-20, pitch 0,65mm, pouzdro APWR |  | https://www.ti.com/lit/gpn/PCM5102A
Headphone Amp sheet
 |  | value | footprint | komponent | dostupnost JCSC | pozn
C17 | polarizovaný, výstupní vazební R | 470u | Capacitor_SMD:CP_Elec_6.3x7.7 | Chemi-Con EMZR100ARA471MF80G |  | 470 µF, 10 V, ±20 %, hliníkový elektrolyt, Ø6,3 × 7,7 mm. ESR nejvýše 0,16 Ω při 100 kHz.
C18 | polarizovaný, výstupní vazební L | 470u | Capacitor_SMD:CP_Elec_6.3x7.7 | Chemi-Con EMZR100ARA471MF80G |  | 470 µF, 10 V, ±20 %, hliníkový elektrolyt, Ø6,3 × 7,7 mm. ESR nejvýše 0,16 Ω při 100 kHz.
C34 | bypass, stabilizace interního VDD/2 | 1u | Capacitor_SMD:C_0805_2012Metric. | Murata GRM21BR71C105KA01L |  |  | blízko pinu bypass
C37 | vcc pin U6, blokování napájení | 100n | Capacitor_SMD:C_0805_2012Metric | Murata GRM21BR71H104KA01L |  | 100 nF, 50 V, X7R, ±10 %, 0805. | C37 blízko pinu u U6
C38 | vstupní vazební kondenzátor | 2,2u | Capacitor_SMD:C_0805_2012Metric | Murata GRM21BR71C225KA12L
C39 | vstupní vazební | 2,2u | Capacitor_SMD:C_0805_2012Metric | Murata GRM21BR71C225KA12L
C40 | X5R | 10u | Capacitor_SMD:C_0805_2012Metric | Murata GRM21BR61C106KE15L |  | 10 µF, 16 V, X5R, ±10 %, 0805.
R24 |  | 20k | Resistor_SMD:R_0805_2012Metric | Yageo RT0805BRD0720KL |  | 20 kΩ, ±0,1 %, 0,125 W
R25 |  | 20k | Resistor_SMD:R_0805_2012Metric | Yageo RT0805BRD0720KL |  | 20 kΩ, ±0,1 %, 0,125 W
R26 |  | 20k | Resistor_SMD:R_0805_2012Metric | Yageo RT0805BRD0720KL |  | 20 kΩ, ±0,1 %, 0,125 W
R27 |  | 20k | Resistor_SMD:R_0805_2012Metric | Yageo RT0805BRD0720KL |  | 20 kΩ, ±0,1 %, 0,125 W
U6 | TPA6111A2DR, varianta SOIC-8, podpora napájení 3,3V |  | Package_SO:SOIC-8_3.9x4.9mm_P1.27mm
D1 | double channel ESD ochrana, obousměrná |  | Package_TO_SOT_SMD:SOT-563 | TI TPD2E1B06DRLR |  |  | blízko na zem, blízko na jack
J3 | 3,5mm stereo jack TRS |  | Connector_Audio:Jack_3.5mm_CUI_SJ-3523-SMT_Horizontal | Same Sky SJ-3523-SMT-TR
User interface sheet
 |  | value | footprint | komponent | dostupnost JCSC | pozn |  | datahseet, JCSC
C62 | omezuje rychlé napájecí špičky, filtrace vf rušení | 100n | Capacitor_SMD:C_0805_2012Metric | Murata GRM21BR71H104KA01L | j |  |  | https://www.lcsc.com/product-detail/C77082.html?s_z=n_q_Murata%2520GRM21BR71H104KA01L
C63 | omezení kolísání napájení při změnách odběru | 4,7u | Capacitor_SMD:C_0805_2012Metric | Murata GRM21BR71C475KE51L | j |  |  | https://www.lcsc.com/product-detail/C408144.html?s_z=n_q_Murata%2520GRM21BR71C475KE51L
R32 | drží signál CS neaktivní při rozběhu procesoru |  | Resistor_SMD:R_0805_2012Metric | Yageo RC0805FR-0710KL | j |  |  | https://www.lcsc.com/product-detail/C84376.html?s_z=n_q_Yageo%2520RC0805FR-0710KL
U11 | vlastní zakoupený |  |  |  | vlastní zakoupený
SW2 | Button_Switch_THT:SW_PUSH_6mm | tht |  | Omron B3F-1000 | j |  |  | https://www.lcsc.com/product-detail/C93157.html?s_z=n_q_Omron%2520B3F-1000
SW3 | Button_Switch_THT:SW_PUSH_6mm | tht |  | Omron B3F-1000 | j |  |  | https://www.lcsc.com/product-detail/C93157.html?s_z=n_q_Omron%2520B3F-1000
SW4 | Button_Switch_THT:SW_PUSH_6mm | tht |  | Omron B3F-1000 | j |  |  | https://www.lcsc.com/product-detail/C93157.html?s_z=n_q_Omron%2520B3F-1000
SW5 | Button_Switch_THT:SW_PUSH_6mm | tht |  | Omron B3F-1000 | j |  |  | https://www.lcsc.com/product-detail/C93157.html?s_z=n_q_Omron%2520B3F-1000
SW6 | Button_Switch_THT:SW_PUSH_6mm | tht |  | Omron B3F-1000 | j |  |  | https://www.lcsc.com/product-detail/C93157.html?s_z=n_q_Omron%2520B3F-1000
SD_card sheet
 |  | value | footprint | komponent | dostupnost JCSC | pozn |  | datasheet, web
C13 | zásoba pro napájení sd karty | 22u | Capacitor_SMD:C_1206_3216Metric | Samsung CL31A226KAHNNNE | j | 22 µF, 25 V, X5R, ±10 % |  | https://www.digikey.com/en/products/detail/samsung-electro-mechanics/CL31A226KAHNNNE/3888705
C20 | blokování napájení, blízko konektoru | 100n | Capacitor_SMD:C_0805_2012Metric | Yageo CC0805KRX7R9BB104 | j | 100 nF, 50 V, X7R, ±10 % |  | https://www.digikey.com/en/products/detail/yageo/CC0805KRX7R9BB104/302874
C41 | blokování napájecí větve ESD ochrany | 100n | Capacitor_SMD:C_0805_2012Metric | Yageo CC0805KRX7R9BB104 | j | 100 nF, 50 V, X7R, ±10 % |  | https://www.digikey.com/en/products/detail/yageo/CC0805KRX7R9BB104/302874
R16 | pull up datových, příkazových linek | 47k | Resistor_SMD:R_0805_2012Metric | Yageo RC0805FR-0747KL | j | 47 kΩ, ±1 %, 0,125 W |  | https://www.digikey.com/en/products/detail/yageo/RC0805FR-0747KL/727973
R17 | pull up datových, příkazových linek | 47k | Resistor_SMD:R_0805_2012Metric | Yageo RC0805FR-0747KL | j | 47 kΩ, ±1 %, 0,125 W |  | https://www.digikey.com/en/products/detail/yageo/RC0805FR-0747KL/727973
R18 | pull up datových, příkazových linek | 47k | Resistor_SMD:R_0805_2012Metric | Yageo RC0805FR-0747KL | j | 47 kΩ, ±1 %, 0,125 W |  | https://www.digikey.com/en/products/detail/yageo/RC0805FR-0747KL/727973
R19 | pull up datových, příkazových linek | 47k | Resistor_SMD:R_0805_2012Metric | Yageo RC0805FR-0747KL | j | 47 kΩ, ±1 %, 0,125 W |  | https://www.digikey.com/en/products/detail/yageo/RC0805FR-0747KL/727973
R20 | pull up datových, příkazových linek | 47k | Resistor_SMD:R_0805_2012Metric | Yageo RC0805FR-0747KL | j | 47 kΩ, ±1 %, 0,125 W |  | https://www.digikey.com/en/products/detail/yageo/RC0805FR-0747KL/727973
R21 | detekce vložené karty | 47k | Resistor_SMD:R_0805_2012Metric | Yageo RC0805FR-0747KL | j | 47 kΩ, ±1 %, 0,125 W |  | https://www.digikey.com/en/products/detail/yageo/RC0805FR-0747KL/727973
U7 | bez pinu 6, ESD ochrana | USBLC6-4SC6 | Package_TO_SOT_SMD:SOT-23-6 | STMicroelectronics USBLC6-4SC6 | j |  |  | https://www.digikey.com/en/products/detail/stmicroelectronics/USBLC6-4SC6/725216
U8 | všechny piny připojney, ESD ochrana | USBLC6-4SC6 | Package_TO_SOT_SMD:SOT-23-6 | STMicroelectronics USBLC6-4SC6 | j |  |  | https://www.digikey.com/en/products/detail/stmicroelectronics/USBLC6-4SC6/725216
J5 | push push slot pro sd kartu |  | Connector_Card:microSD_HC_Hirose_DM3AT-SF-PEJM5 | Hirose DM3AT-SF-PEJM5 | 20 ks :// |  |  | https://www.digikey.com/en/products/detail/hirose-electric-co-ltd/DM3AT-SF-PEJM5/2533565
MCU sheet
 |  | value | footprint | komponent | dostupnost JCSC | pozn |  | datasheet
C21 |  | 10u | Capacitor_SMD:C_1206_3216Metric | TDK C3216X7R1C106K160AC |  | 10 µF, 16 V, X7R, ±10 %
C42 |  | 100n | Capacitor_SMD:C_0805_2012Metric | Yageo CC0805KRX7R9BB104 |  | 100 nF, 50 V, X7R, ±10 %
C43 |  | 100n | Capacitor_SMD:C_0805_2012Metric | Yageo CC0805KRX7R9BB104 |  | 100 nF, 50 V, X7R, ±10 %
C44 |  | 100n | Capacitor_SMD:C_0805_2012Metric | Yageo CC0805KRX7R9BB104 |  | 100 nF, 50 V, X7R, ±10 %
C45 |  | 100n | Capacitor_SMD:C_0805_2012Metric | Yageo CC0805KRX7R9BB104 |  | 100 nF, 50 V, X7R, ±10 %
C46 |  | 100n | Capacitor_SMD:C_0805_2012Metric | Yageo CC0805KRX7R9BB104 |  | 100 nF, 50 V, X7R, ±10 %
C51 | VBAT | 100n | Capacitor_SMD:C_0805_2012Metric | Yageo CC0805KRX7R9BB104 |  | 100 nF, 50 V, X7R, ±10 %
C52 | na GND z VDDUSB | 100n | Capacitor_SMD:C_0805_2012Metric | Yageo CC0805KRX7R9BB104 |  | 100 nF, 50 V, X7R, ±10 %
C53 | J4 konektor, filtrace resetu, NRST-GND | 100n | Capacitor_SMD:C_0805_2012Metric | Yageo CC0805KRX7R9BB104 |  | 100 nF, 50 V, X7R, ±10 %
C55 | VDDA | 1u | Capacitor_SMD:C_0805_2012Metric | Samsung CL21B105KBFNNNE |  | 1 µF, 50 V, X7R, ±10 %
C56 | VDDA | 100n | Capacitor_SMD:C_0805_2012Metric | Yageo CC0805KRX7R9BB104 |  | 100 nF, 50 V, X7R, ±10 %
C57 | 20% požadavky stm32 | 2,2u | Capacitor_SMD:C_0805_2012Metric | TDK C2012X7R1C225K125AB |  | 2,2 µF ±20 %, jmenovité napětí alespoň 10 V, ESR < 20 mΩ při 3 MHz
C58 | 20% požadavky stm32 | 2,2u | Capacitor_SMD:C_0805_2012Metric | TDK C2012X7R1C225K125AB |  | 2,2 µF ±20 %, jmenovité napětí alespoň 10 V, ESR < 20 mΩ při 3 MHz
C59 |  | 10u | Capacitor_SMD:C_1206_3216Metric | TDK C3216X7R1C106K160AC |  | 10 µF ±20 %, jmenovité napětí alespoň 10 V, ESR < 10 mΩ při 3 MHz
C60 |  | 100n | Capacitor_SMD:C_0805_2012Metric | Yageo CC0805KRX7R9BB104 |  | 100 nF, 50 V, X7R, ±10 %
C61 |  | 1u | Capacitor_SMD:C_0805_2012Metric | Samsung CL21B105KBFNNNE |  | 1 µF, 50 V, X7R, ±10 %
R31 |  | 10k | Resistor_SMD:R_0805_2012Metric | Yageo RC0805FR-0710KL |  | 10 kΩ, ±1 %, 0805. Drží BOOT0 v logické nule
L2 | omezení rychlosti změny proudu, předepsáno výrobcem | 2,2uH | Inductor_SMD:L_Coilcraft_XxL4020 | Coilcraft XFL4020-222MEC |  | 2,2 µH ±20 %, saturační proud > 0,5 A, stejnosměrný odpor vinutí < 200 mΩ
power sheet
 |  | value | footprint | komponent | dostupnost JCSC | pozn |  | datasheet
C1 | blokace VBUS u USB ochrany | 100n | Capacitor_SMD:C_0805_2012Metric | Yageo CC0805KRX7R9BB104
C2 | výstyupní C na sys_power, omezení změn napětí při změnách odběru | 4,7u | Capacitor_SMD:C_0805_2012Metric | Samsung CL21B475KOFNNWE
C3 | blokace bater. Vývodu BAT | 4,7u | Capacitor_SMD:C_0805_2012Metric | Samsung CL21B475KOFNNWE
C4 | vstupní blok mezi VBUS a GND | 4,7u | Capacitor_SMD:C_0805_2012Metric | Samsung CL21B475KOFNNWE
C5 | podle požadavků | 100n | Capacitor_SMD:C_0603_1608Metric | TDK C1608X7R1H104K080AA
C6 | výstupní kapacita na sys_power | 10u | Capacitor_SMD:C_1206_3216Metric | Samsung CL10A106KP8NNNC
C7 | výstupní kapacita na sys_power | 10u | Capacitor_SMD:C_1206_3216Metric | Samsung CL10A106KP8NNNC
C8 | malý C | 10u | Capacitor_SMD:C_0603_1608Metric | Samsung CL10A106KP8NNNC
C9 | malý C | 10u | Capacitor_SMD:C_0603_1608Metric | Samsung CL10A106KP8NNNC
C10 | omezení zvlění a pokledy při proudových špičkách, výstupní C 3,3V | 22u | Capacitor_SMD:C_0603_1608Metric | Samsung CL10A226MP8NUNE
C11 | omezení zvlění a pokledy při proudových špičkách, výstupní C 3,3V | 22u | Capacitor_SMD:C_0603_1608Metric | Samsung CL10A226MP8NUNE
C12 | omezení zvlění a pokledy při proudových špičkách, výstupní C 3,3V | 22u | Capacitor_SMD:C_0603_1608Metric | Samsung CL10A226MP8NUNE
C14 | blokování napájení | 100n | Capacitor_SMD:C_0805_2012Metric | Yageo CC0805KRX7R9BB104
C15 | časování nuceného vypnutí při stlačení tlačítka | 1u | Capacitor_SMD:C_0805_2012Metric | Samsung CL21B105KBFNNNE
C16 | časování délky stisku pro zapnutí | 330n | Capacitor_SMD:C_0805_2012Metric | Samsung CL21B334KBFNNNE
R1 | možnost upravit stínění s GND | 0R | Resistor_SMD:R_0805_2012Metric | RC0805JR-070RL
R2 | pull down EN1, výběr základního režismu USB | 100K | Resistor_SMD:R_0805_2012Metric | RC0805FR-07100KL
R3 | Pull down CE, výchozí stav povoluje nabíjení | 68K | Resistor_SMD:R_0805_2012Metric | RC0805FR-0768KL
R5 | nastavení požadovaného 282 mA | 3,16K | Resistor_SMD:R_0805_2012Metric | RC0805FR-073K16L
R6 |  | 3,6K | Resistor_SMD:R_0805_2012Metric | RC0805FR-073K6L
R7 | nastavení časovače nabíjení | 68K | Resistor_SMD:R_0805_2012Metric | RC0805FR-0768KL
R8 |  | 47k | Resistor_SMD:R_0805_2012Metric | RC0805FR-0747KL
R9 |  | 47k | Resistor_SMD:R_0805_2012Metric | RC0805FR-0747KL
R10 |  | 10k | Resistor_SMD:R_0805_2012Metric | RC0805FR-0710KL
R11 |  | 10k | Resistor_SMD:R_0805_2012Metric | RC0805FR-0710KL
R12 |  | 470k | Resistor_SMD:R_0805_2012Metric | RC0805FR-07470KL
R13 |  | 150k | Resistor_SMD:R_0805_2012Metric | RC0805FR-07150KL
R14 |  | 5,1k | Resistor_SMD:R_0805_2012Metric | RC0805FR-075K1L
R15 |  | 5,1k | Resistor_SMD:R_0805_2012Metric | RC0805FR-075K1L
R28 |  | 100k | Resistor_SMD:R_0805_2012Metric | RC0805FR-07100KL
R29 |  | 10k | Resistor_SMD:R_0805_2012Metric | RC0805FR-0710KL
R30 | Pullup kill, drží systém zapnutý, dokud MCU nepřitáhne KILL k zemi | 100k | Resistor_SMD:R_0805_2012Metric | RC0805FR-07100KL
R33 | horní odpor pro detekci přítomnosti USB napájení | 33k | Resistor_SMD:R_0805_2012Metric | RC0805FR-0733KL
R34 | dolní odpor pro detekci USB napájení | 82k | Resistor_SMD:R_0805_2012Metric
L1 |  |  | Inductor_SMD:L_Coilcraft_XxL4020 | Coilcraft XFL4020-152MEC
J1 | USB-C, USB 2.0 |  | Connector_USB:USB_C_Receptacle_GCT_USB4105-xx-A_16P_TopMnt_Horizontal | GCT USB4105-GF-A
J2 | bat konektor |  | Connector_PinHeader_2.54mm:PinHeader_1x02_P2.54mm_Vertical
SW1 |  |  | Button_Switch_THT:SW_PUSH_6mm | Omron B3F-1000
U2 | ESD ochrana D+ D- |  | Package_TO_SOT_SMD:SOT-23-6 | ST USBLC6-2SC6
U3 |  |  | Package_DFN_QFN:VQFN-16-1EP_3x3mm_P0.5mm_EP1.6x1.6mm | TI BQ24074RGTR
U4 |  |  | TPS6307RNMR:VREG_TPS63070RNMR | TI TPS63070RNMR
U9 | ESD ochrana CC1 CC2 |  | Package_TO_SOT_SMD:SOT-553 | TI TPD2E2U06DRLR
U10 |  |  | Package_TO_SOT_SMD:TSOT-23-8 | LTC2954ITS8-1#TRMPBF
