AnnaHruskova/Hruskova_Portable_Audio_Player_with_USB_Audio_Interface/latex/photos/TPA6111A2_operating_characteristics.png

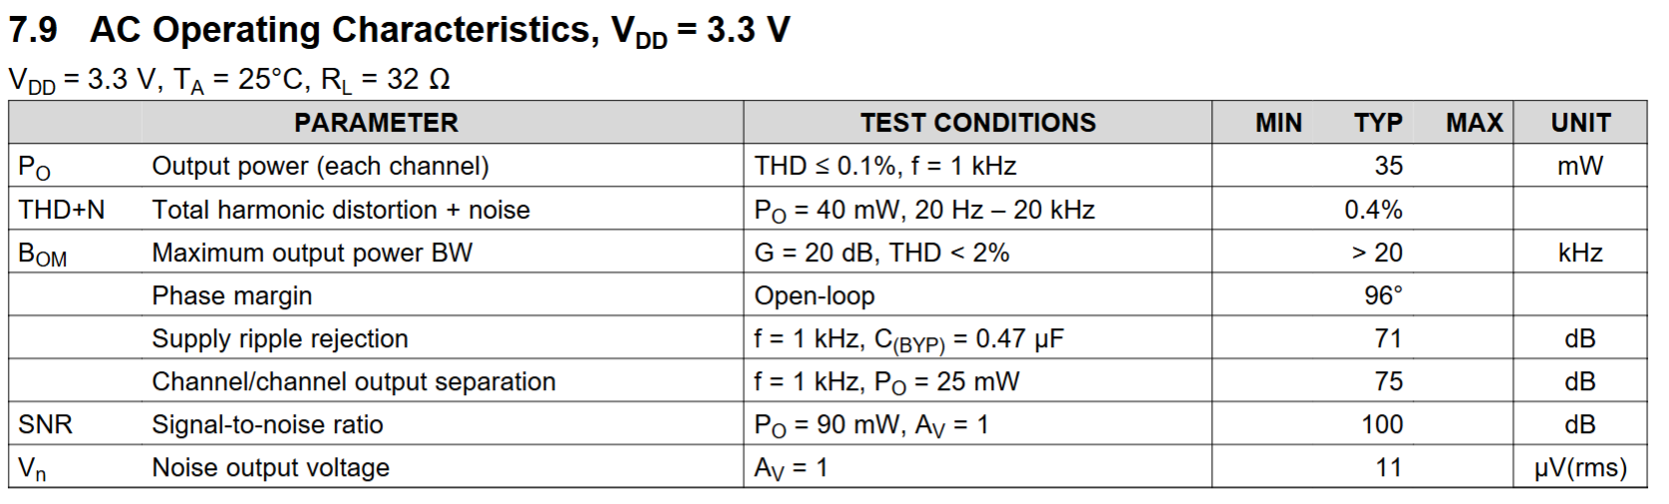
latex/photos/TPA6111A2_operating_characteristics.png
