AnnaHruskova/Hruskova_Portable_Audio_Player_with_USB_Audio_Interface/bc_prace.pdf

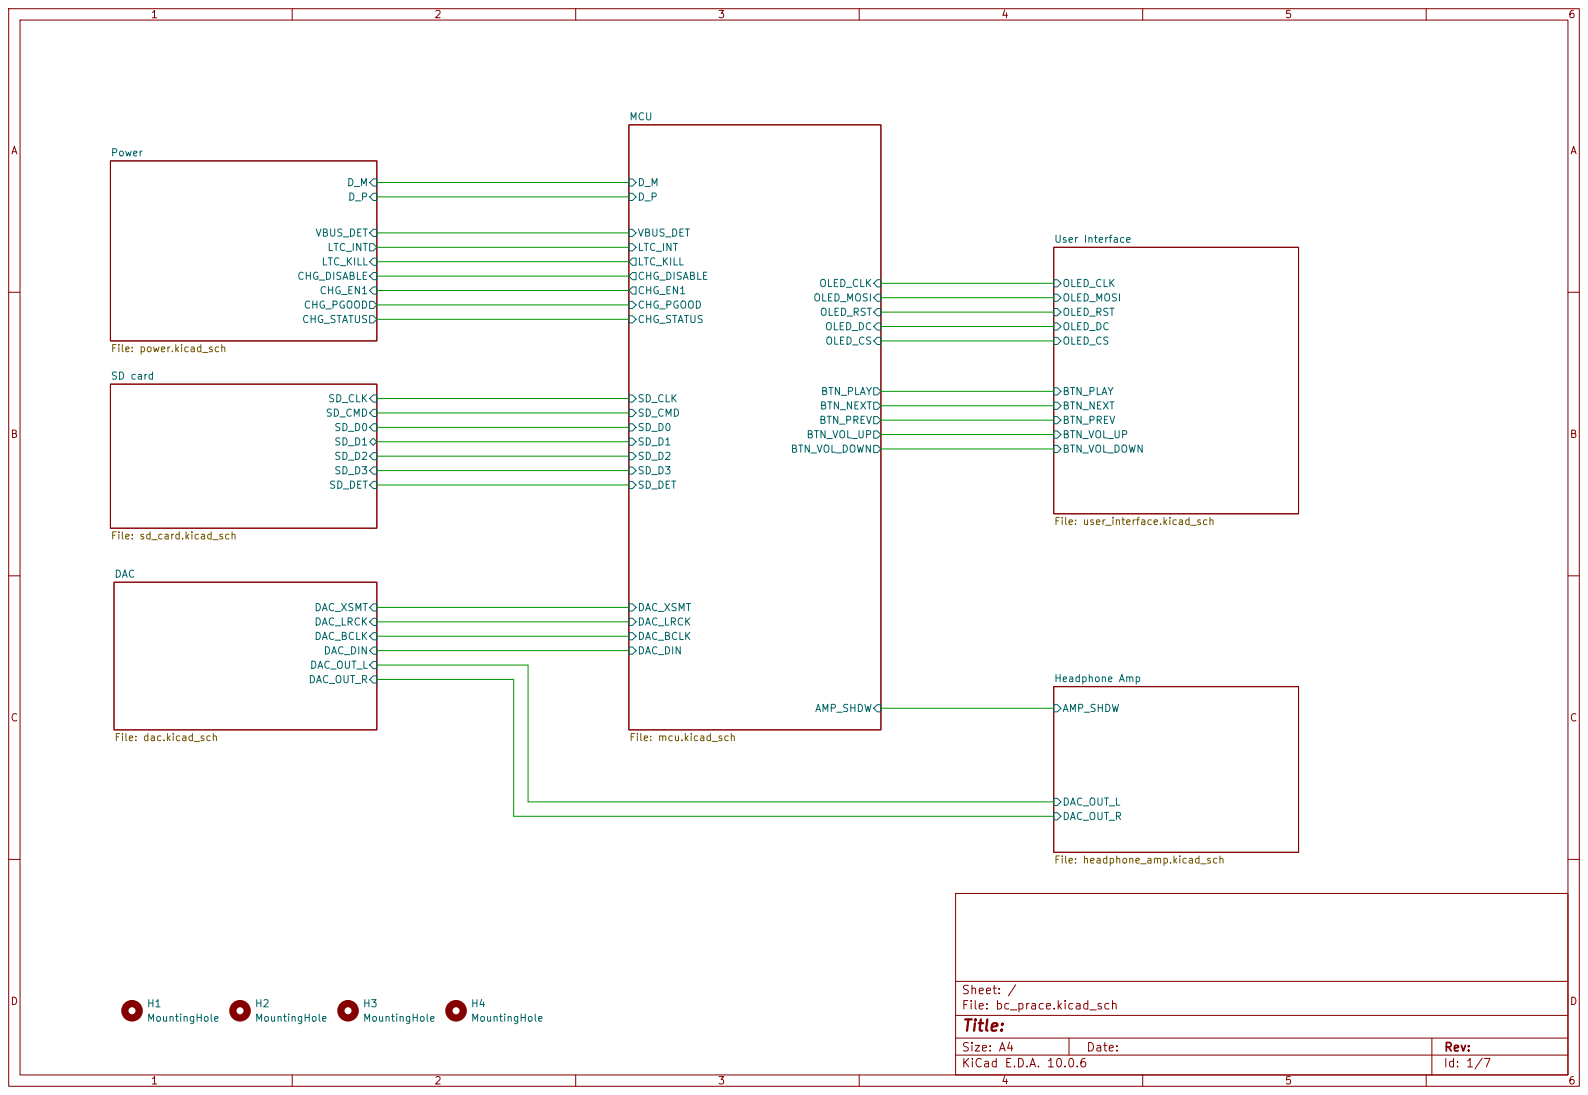
[picture p12: page 1]

Size: A4 | Rev:
KiCad E.D.A. 10.0.6 | Id: 1/7

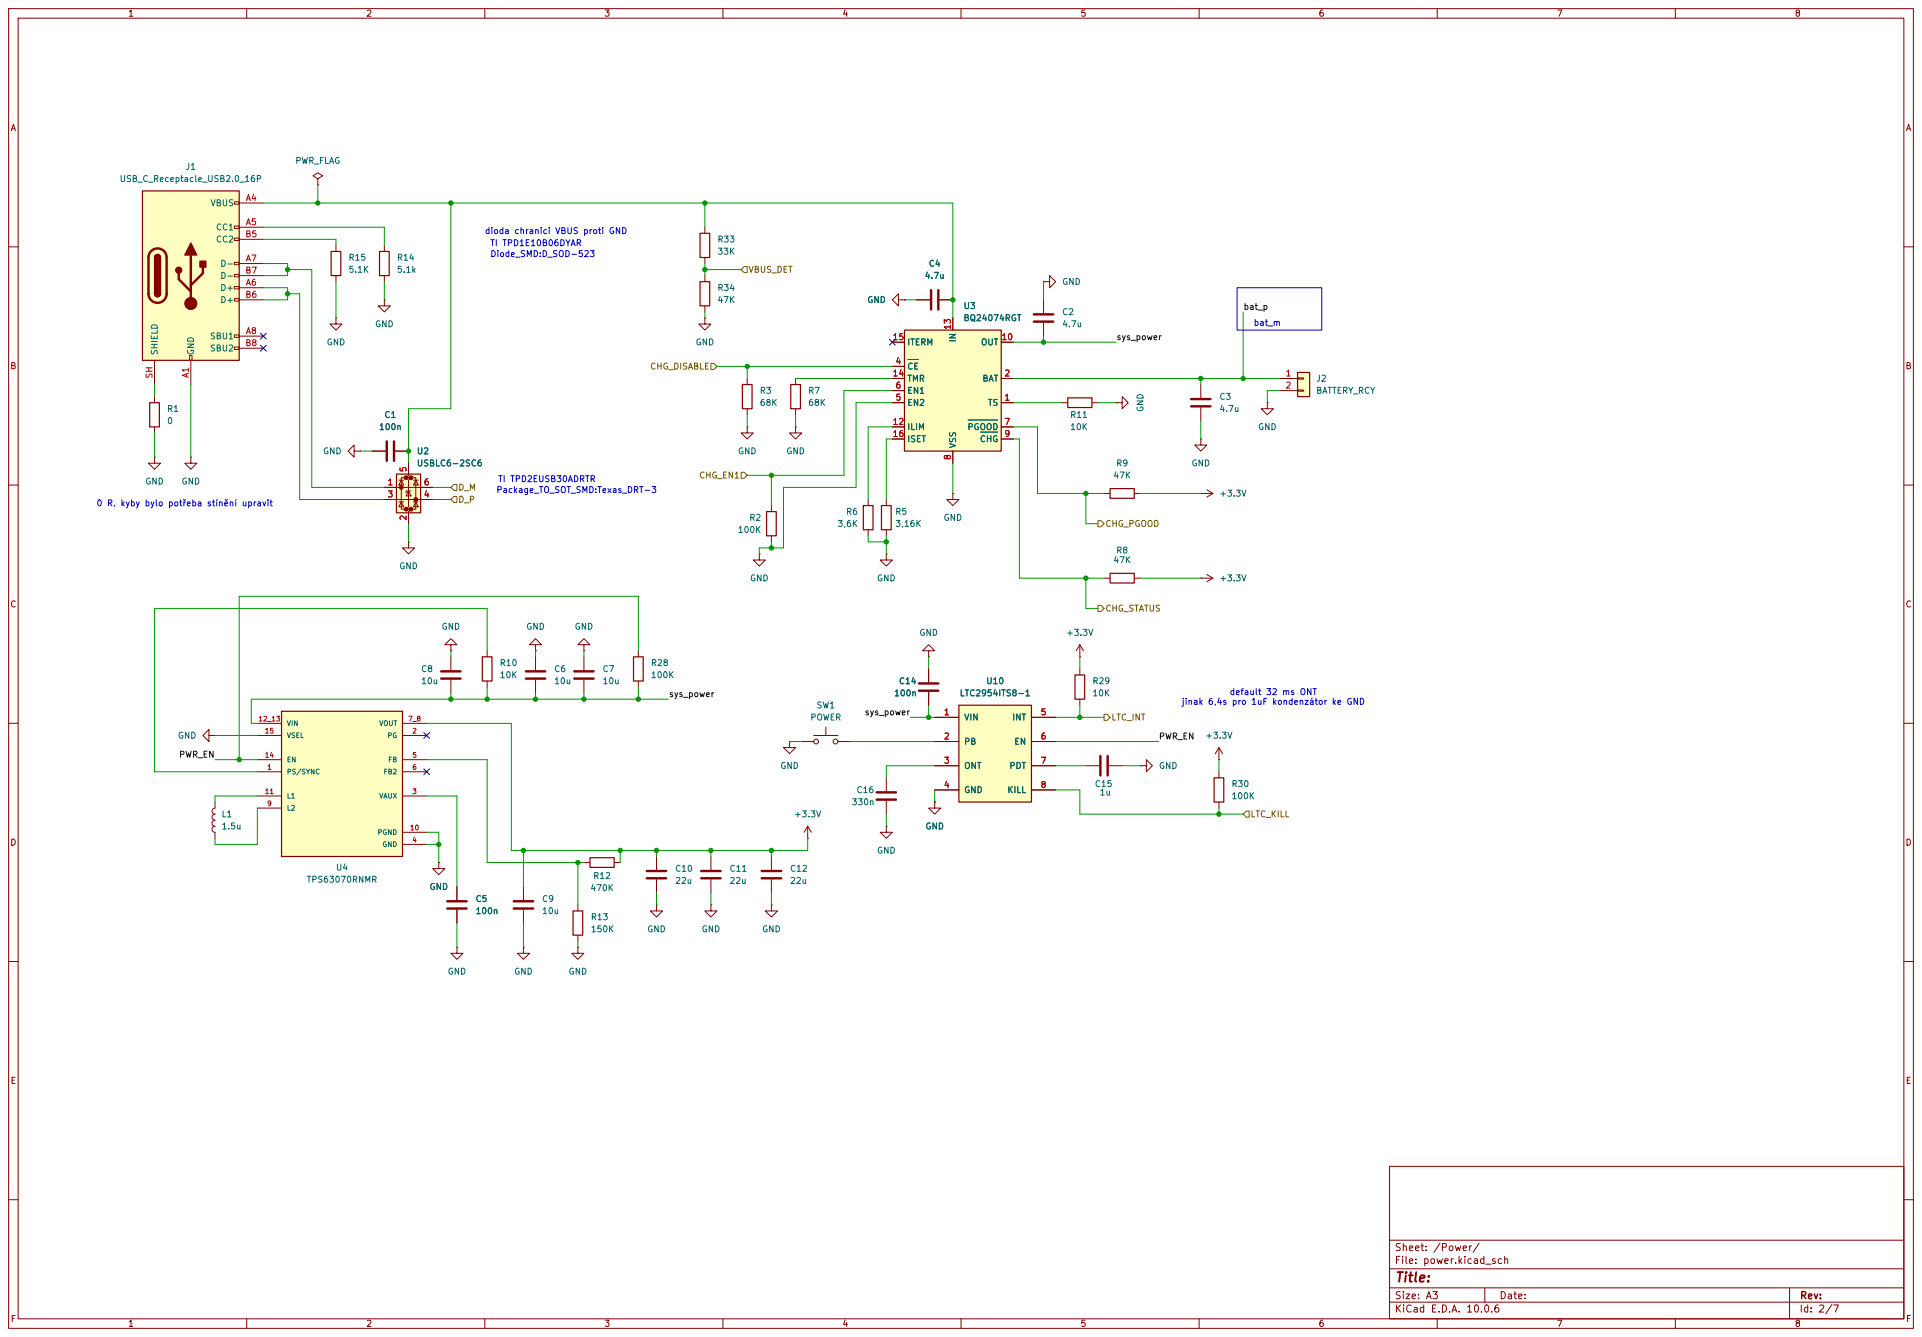
[picture p13: page 2]

dioda chranici VBUS proti GND
TI TPD1E10B06DYAR
ITERM 15

jinak 6,4s pro 1uF kondenzátor ke GND

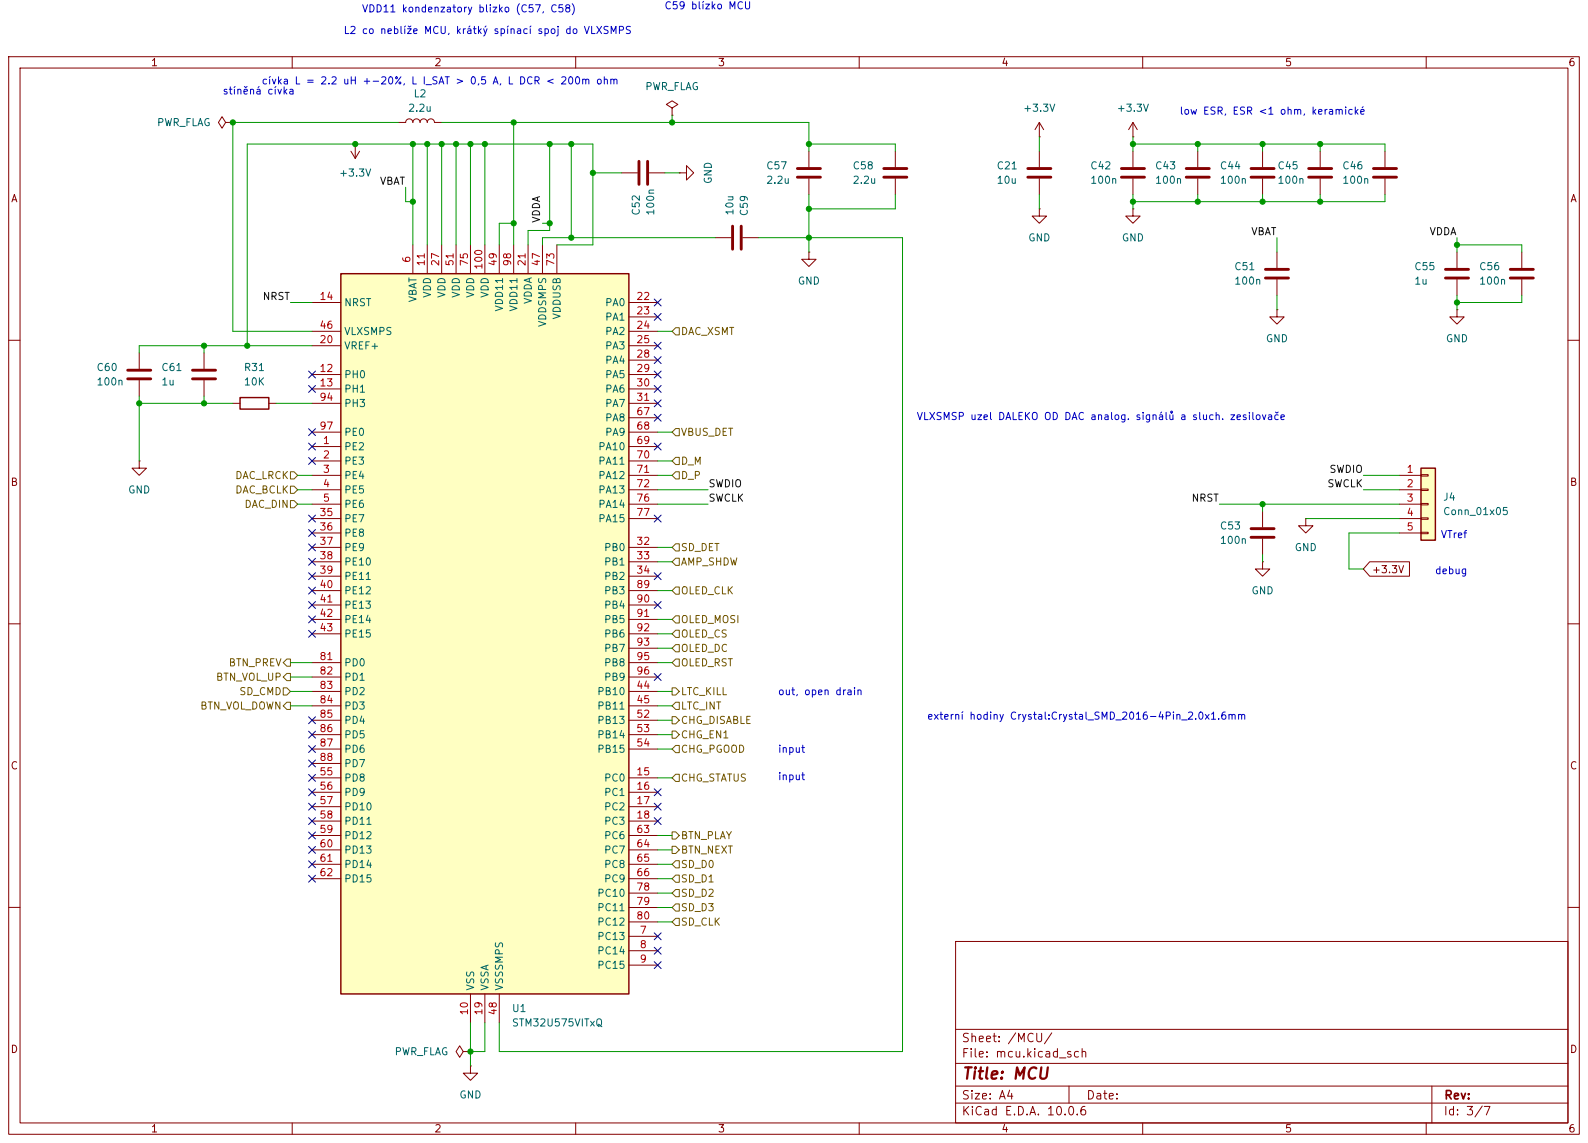
[picture p14: page 3]

stíněná cívka cívka L = 2.2 uH +-20%, L I_SAT > 0,5 A, L DCR < 200m ohm

low ESR, ESR <1 ohm, keramické
100n GND

VLXSMSP uzel DALEKO OD DAC analog. signálů a sluch. zesilovače out, open drain

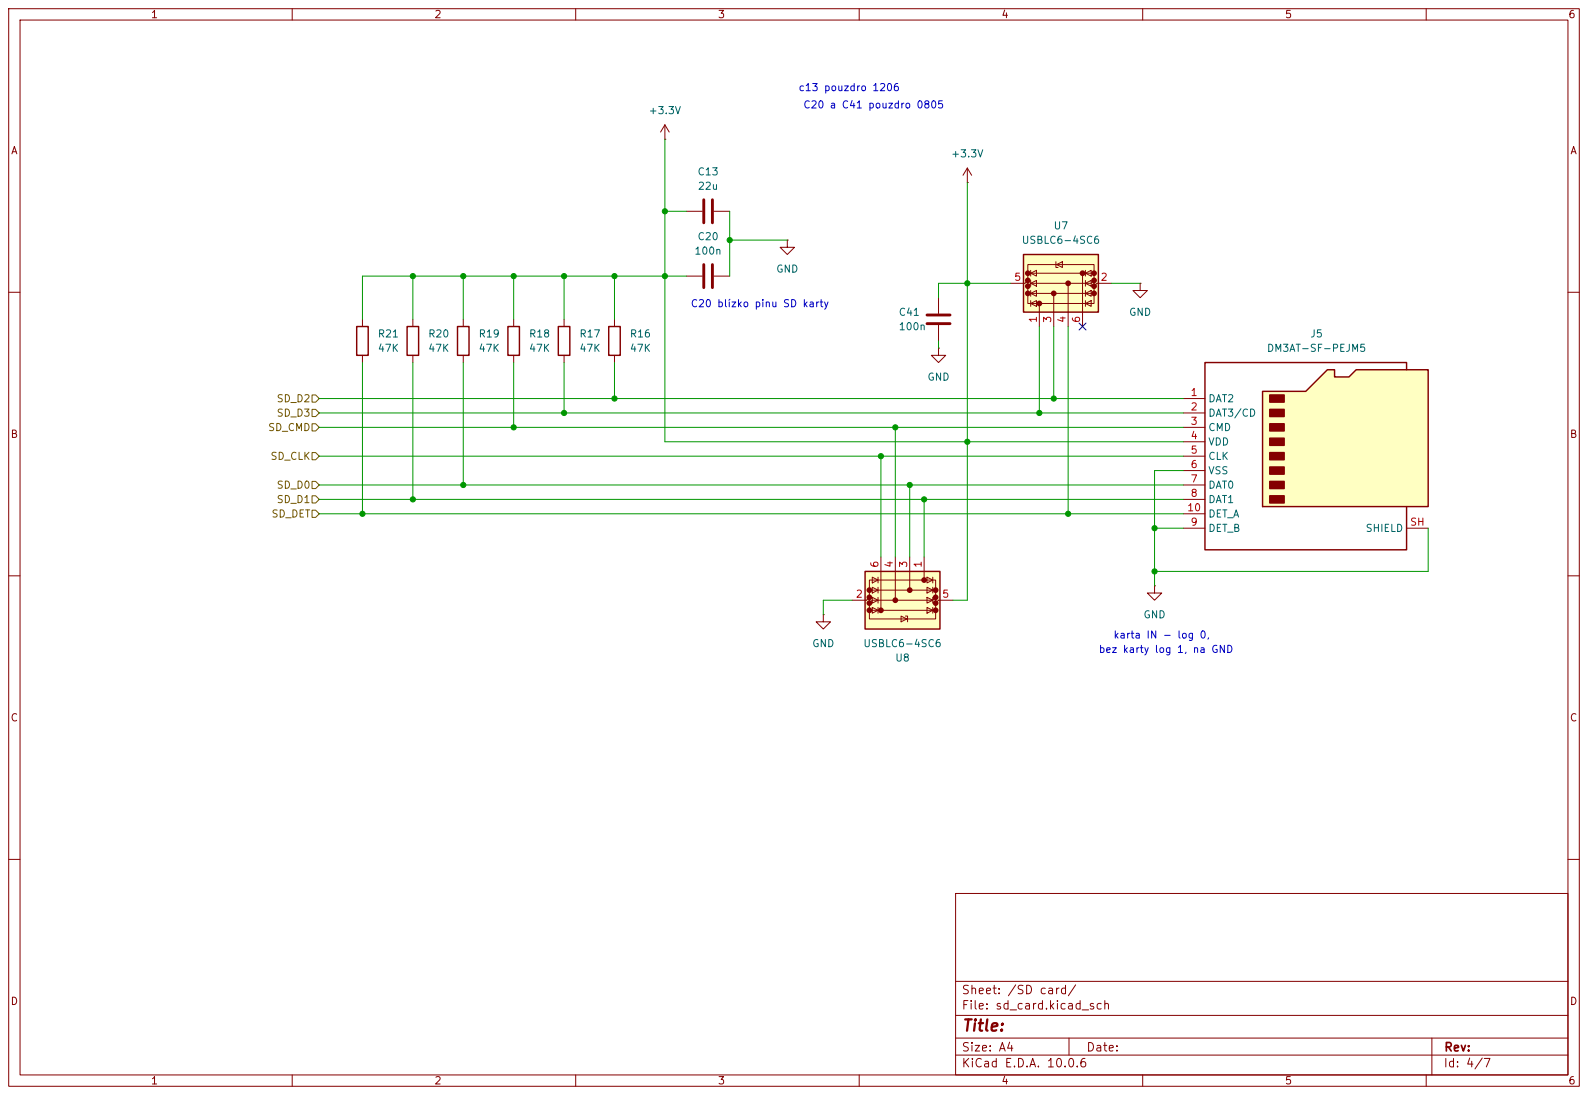
[picture p15: page 4]

karta IN - log 0, C20 blízko pinu SD karty C20 a C41 pouzdro 0805

bez karty log 1, na GND

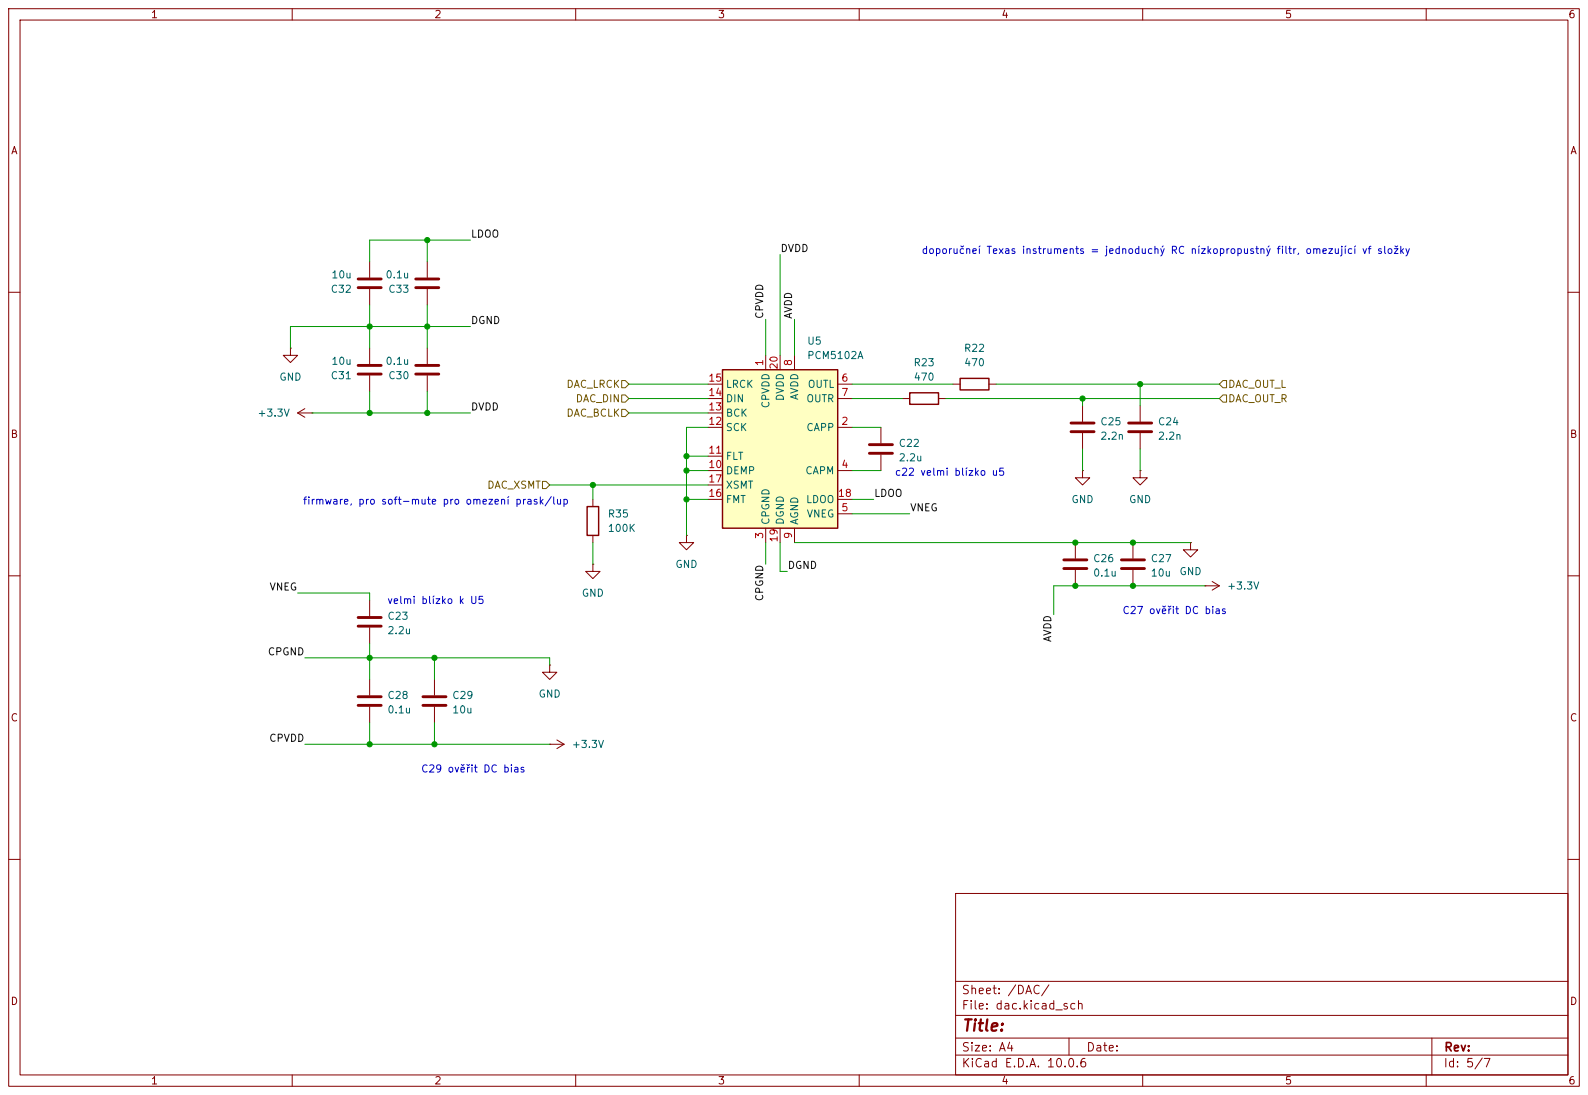
[picture p16: page 5]

doporučneí Texas instruments = jednoduchý RC nízkopropustný filtr, omezující vf složky c22 velmi blízko u5

SCK 12 BCK 13 DIN 14 LRCK 15

firmware, pro soft-mute pro omezení prask/lup

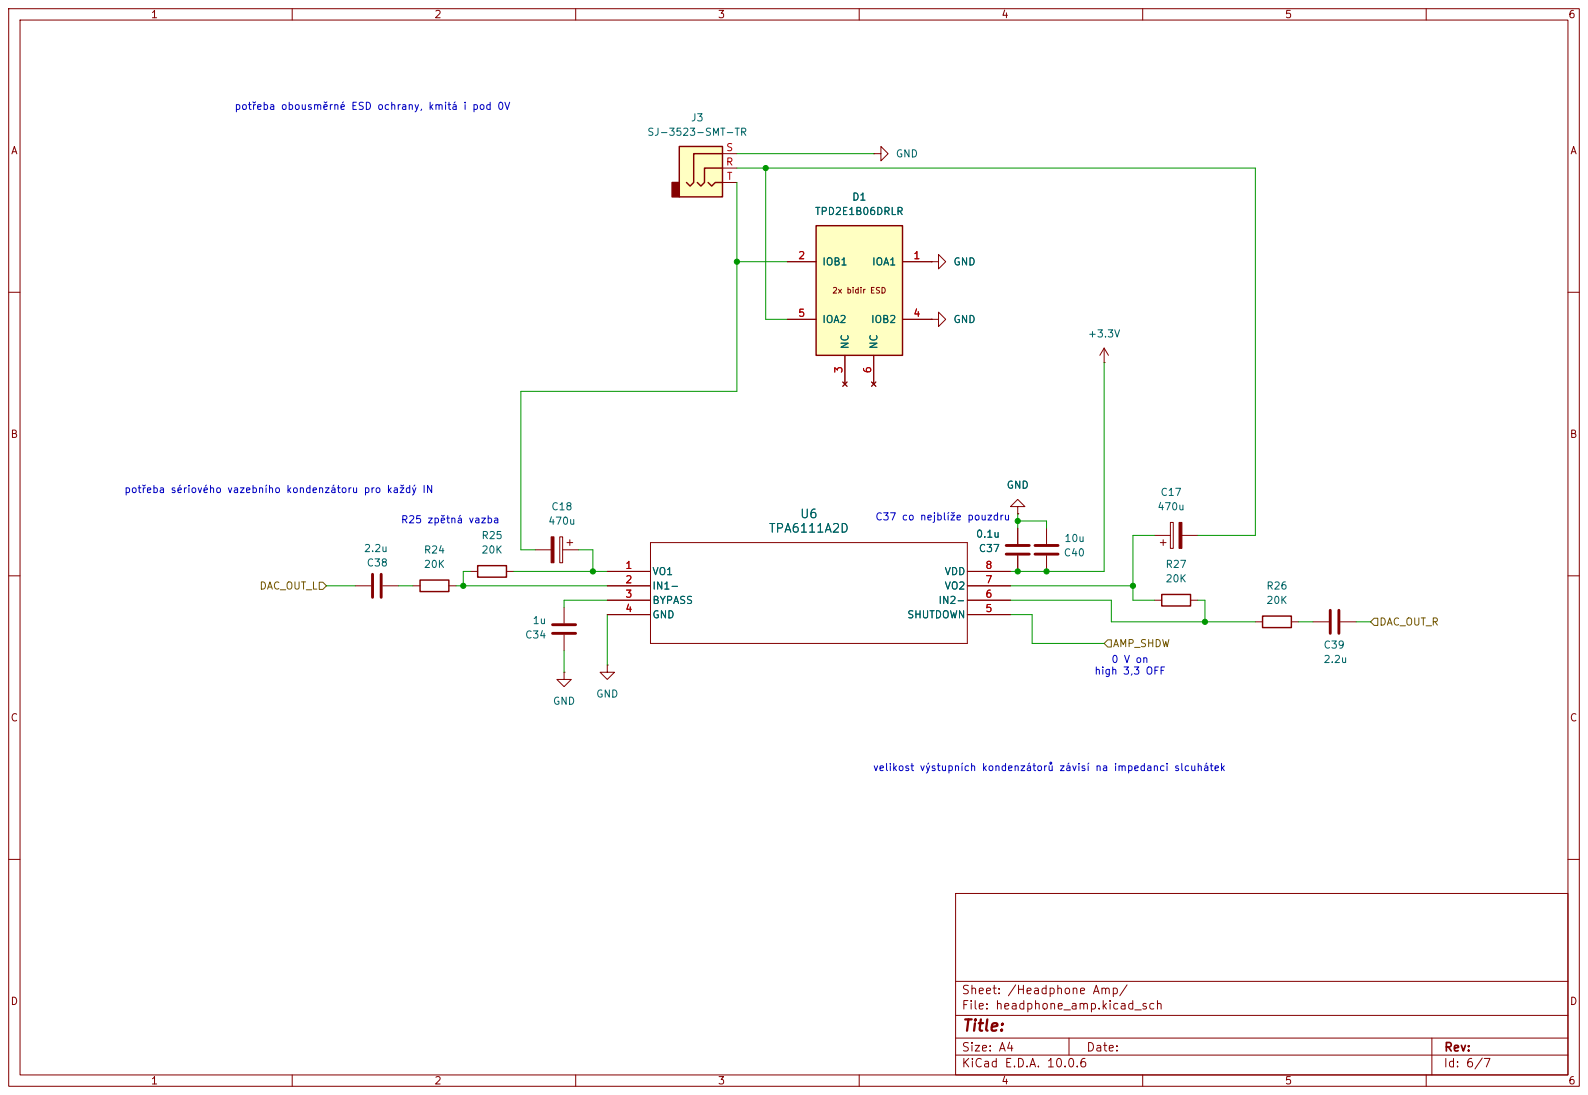
[picture p17: page 6]

potřeba sériového vazebního kondenzátoru pro každý IN

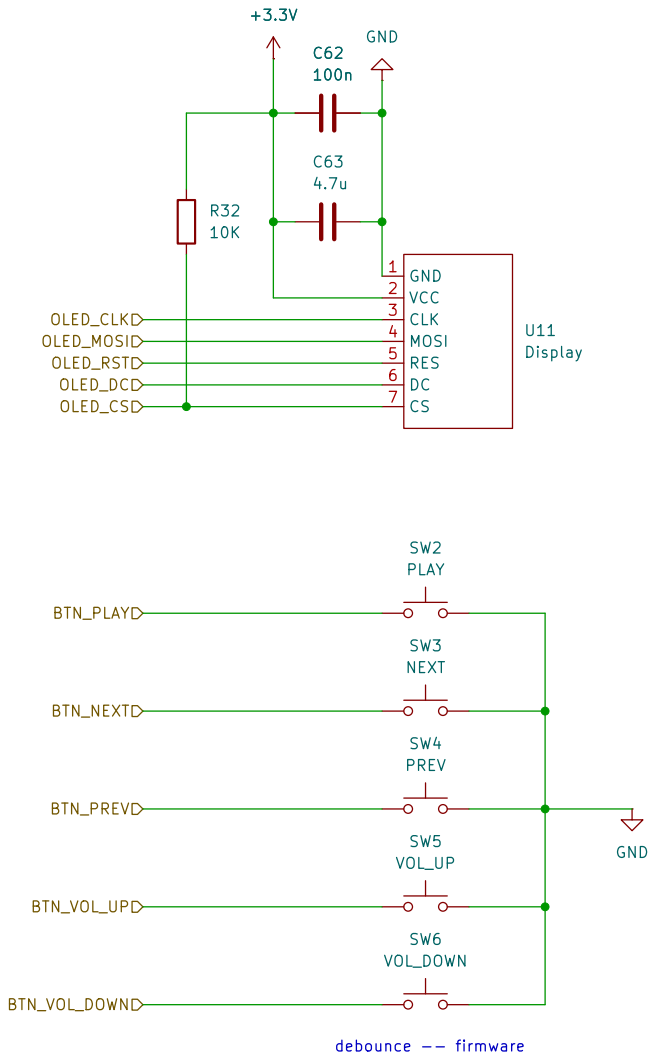
[picture p18: page 7]
