AnnaHruskova/Hruskova_Portable_Audio_Player_with_USB_Audio_Interface/plot.pdf

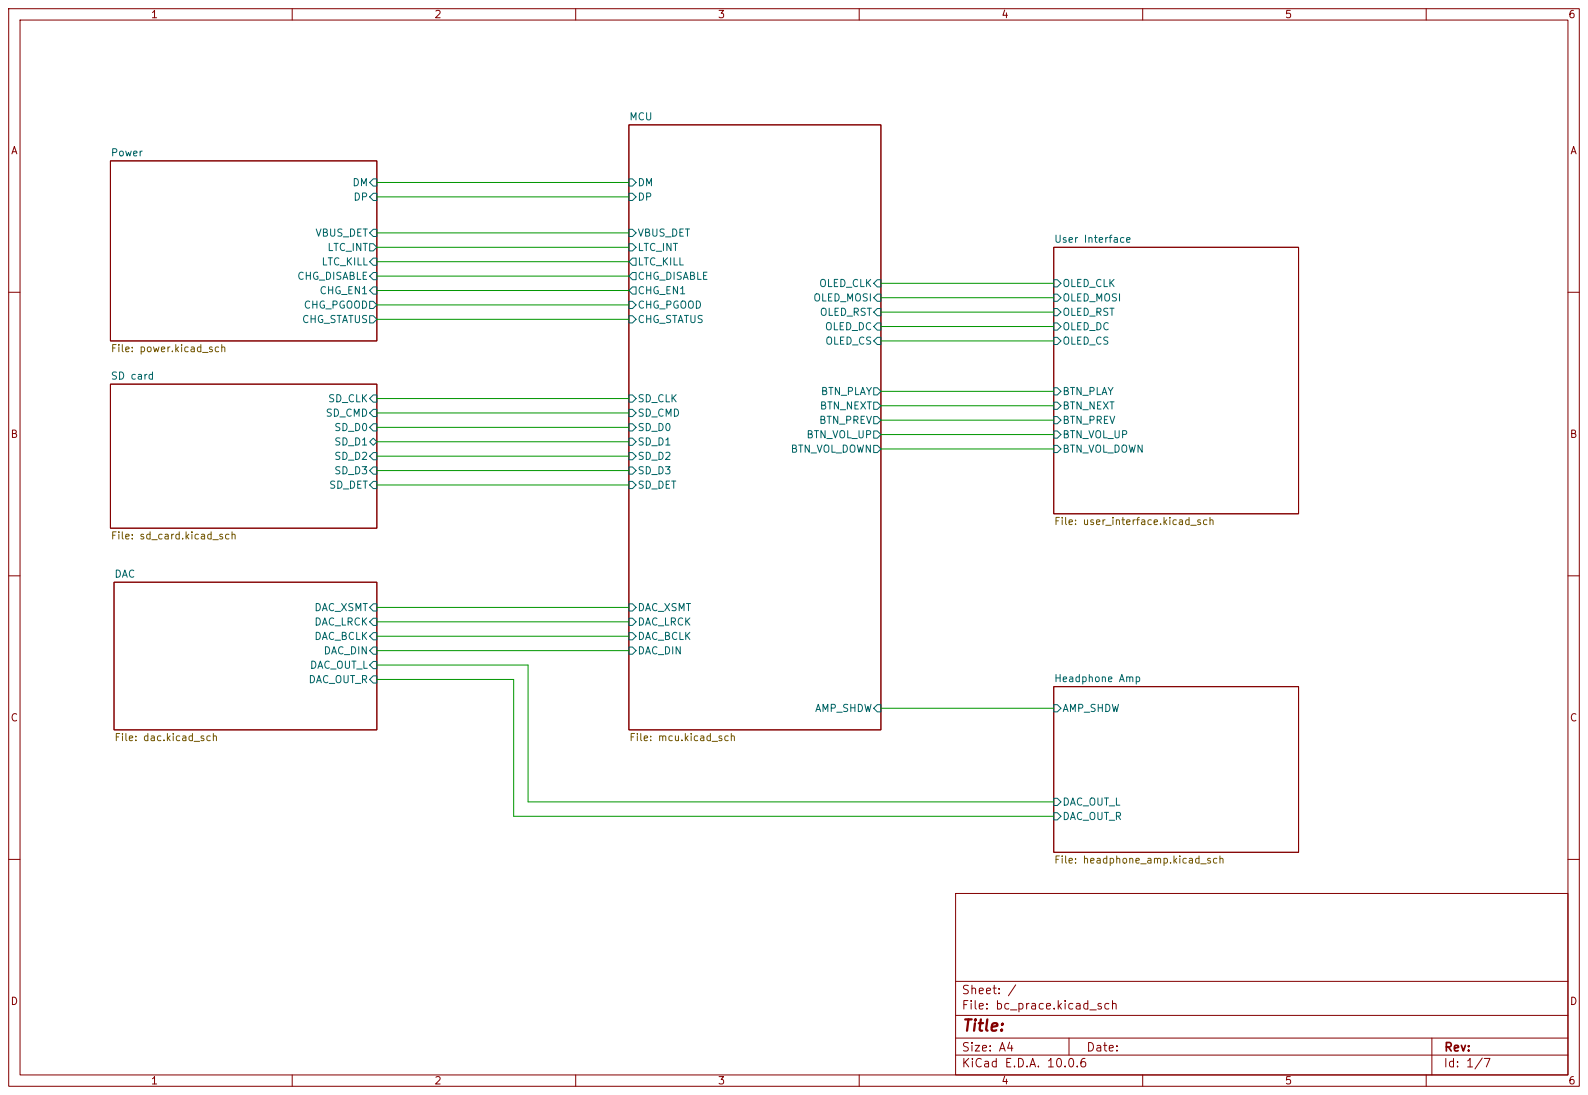
[picture p19: page 1]

Size: A4 | Rev:
KiCad E.D.A. 10.0.6 | Id: 1/7

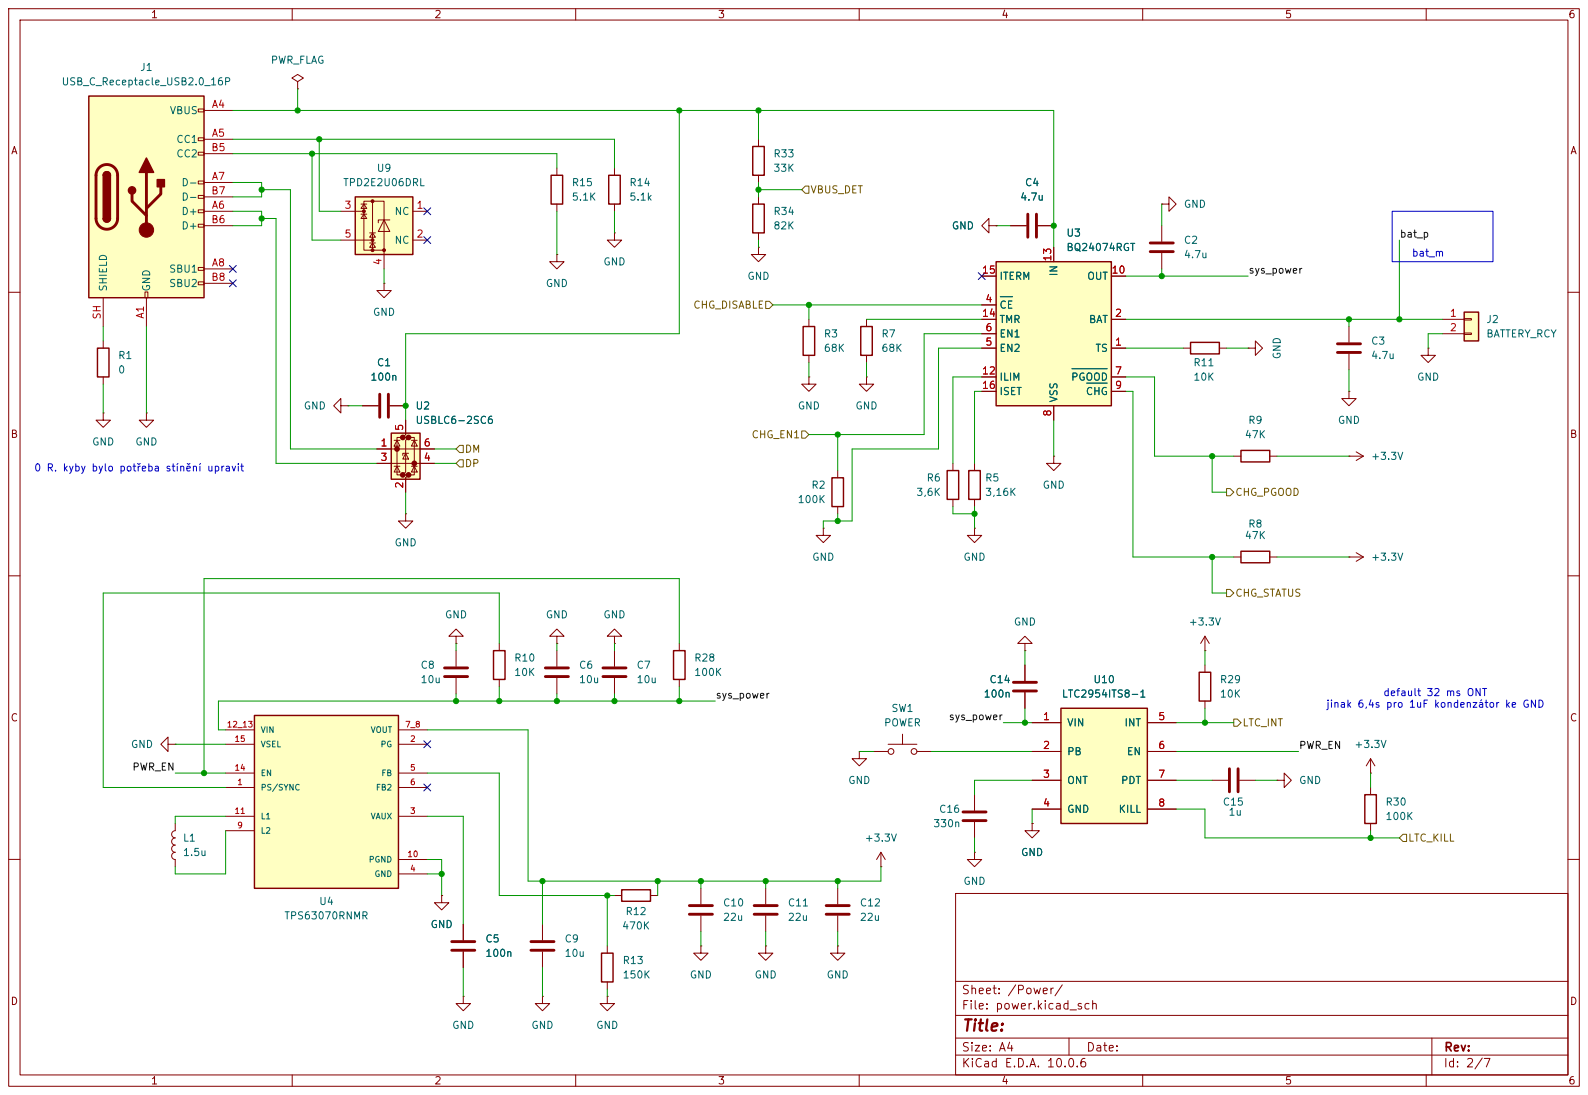
[picture p20: page 2]

jinak 6,4s pro 1uF kondenzátor ke GND

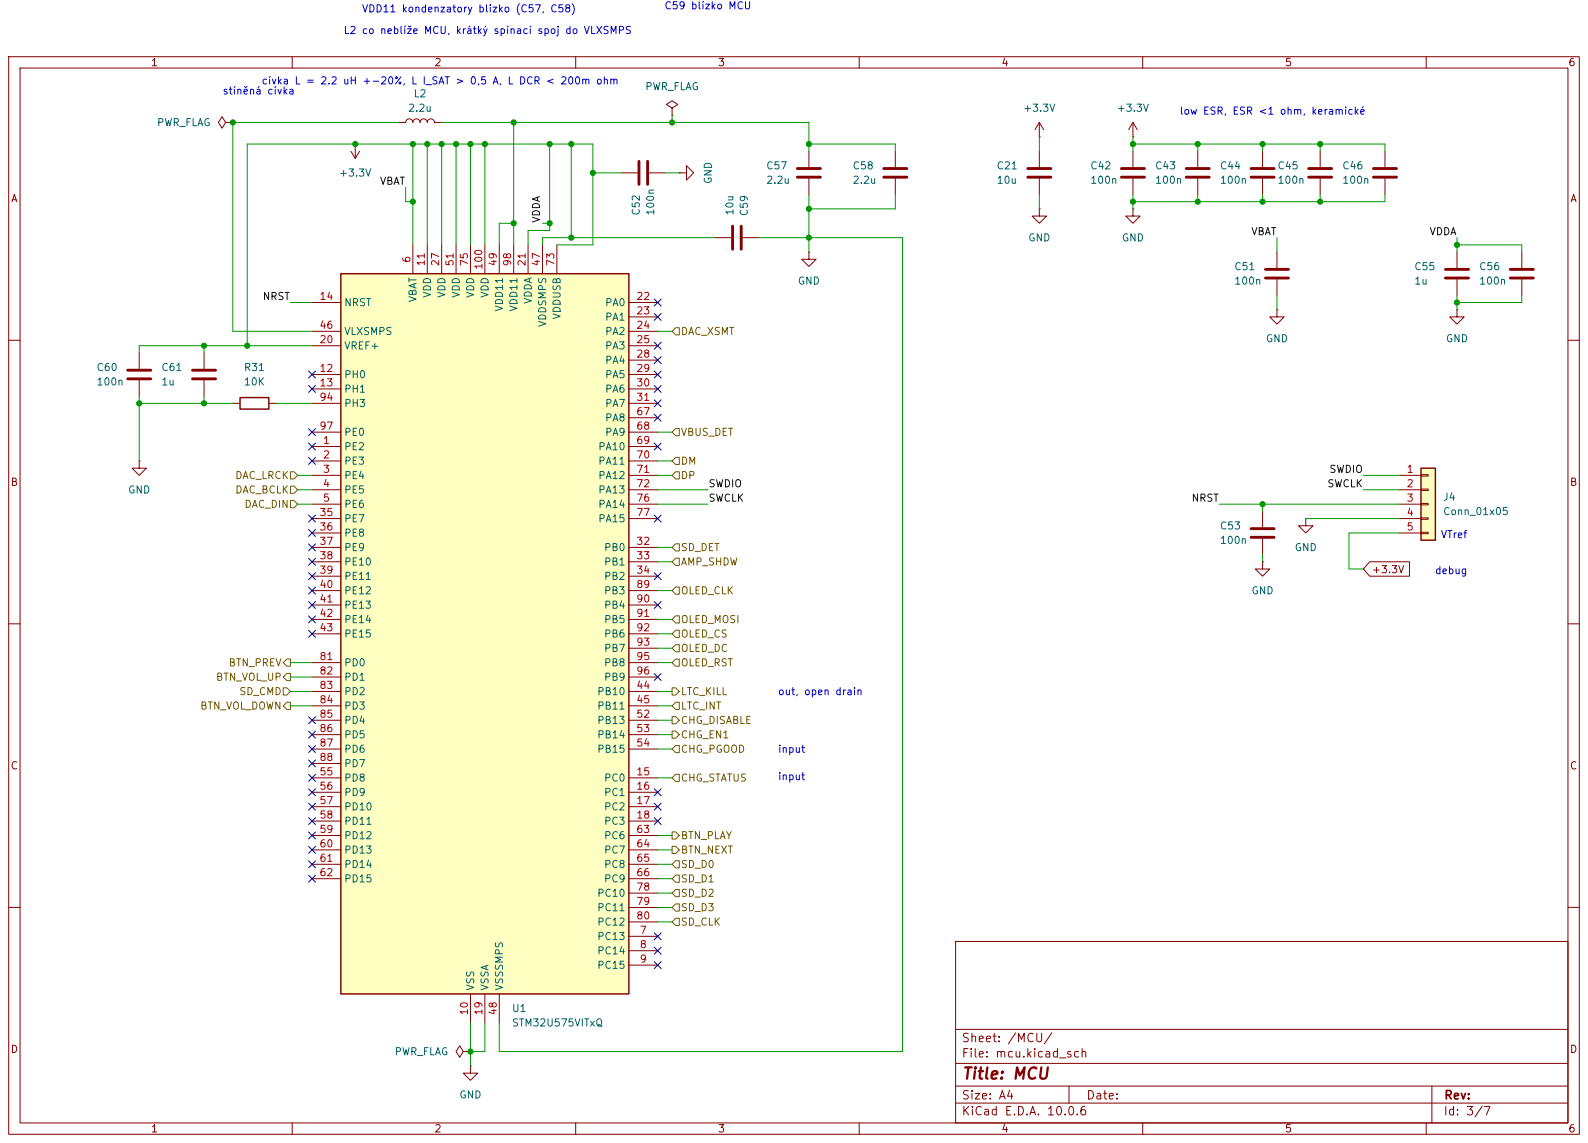
[picture p21: page 3]

L2 co neblíže MCU, krátký spínací spoj do VLXSMPS

cívka L = 2.2 uH +-20%, L I_SAT > 0,5 A, L DCR < 200m ohm

low ESR, ESR <1 ohm, keramické


karta IN - log 0, C20 blízko pinu SD karty C20 a C41 pouzdro 0805

bez karty log 1, na GND

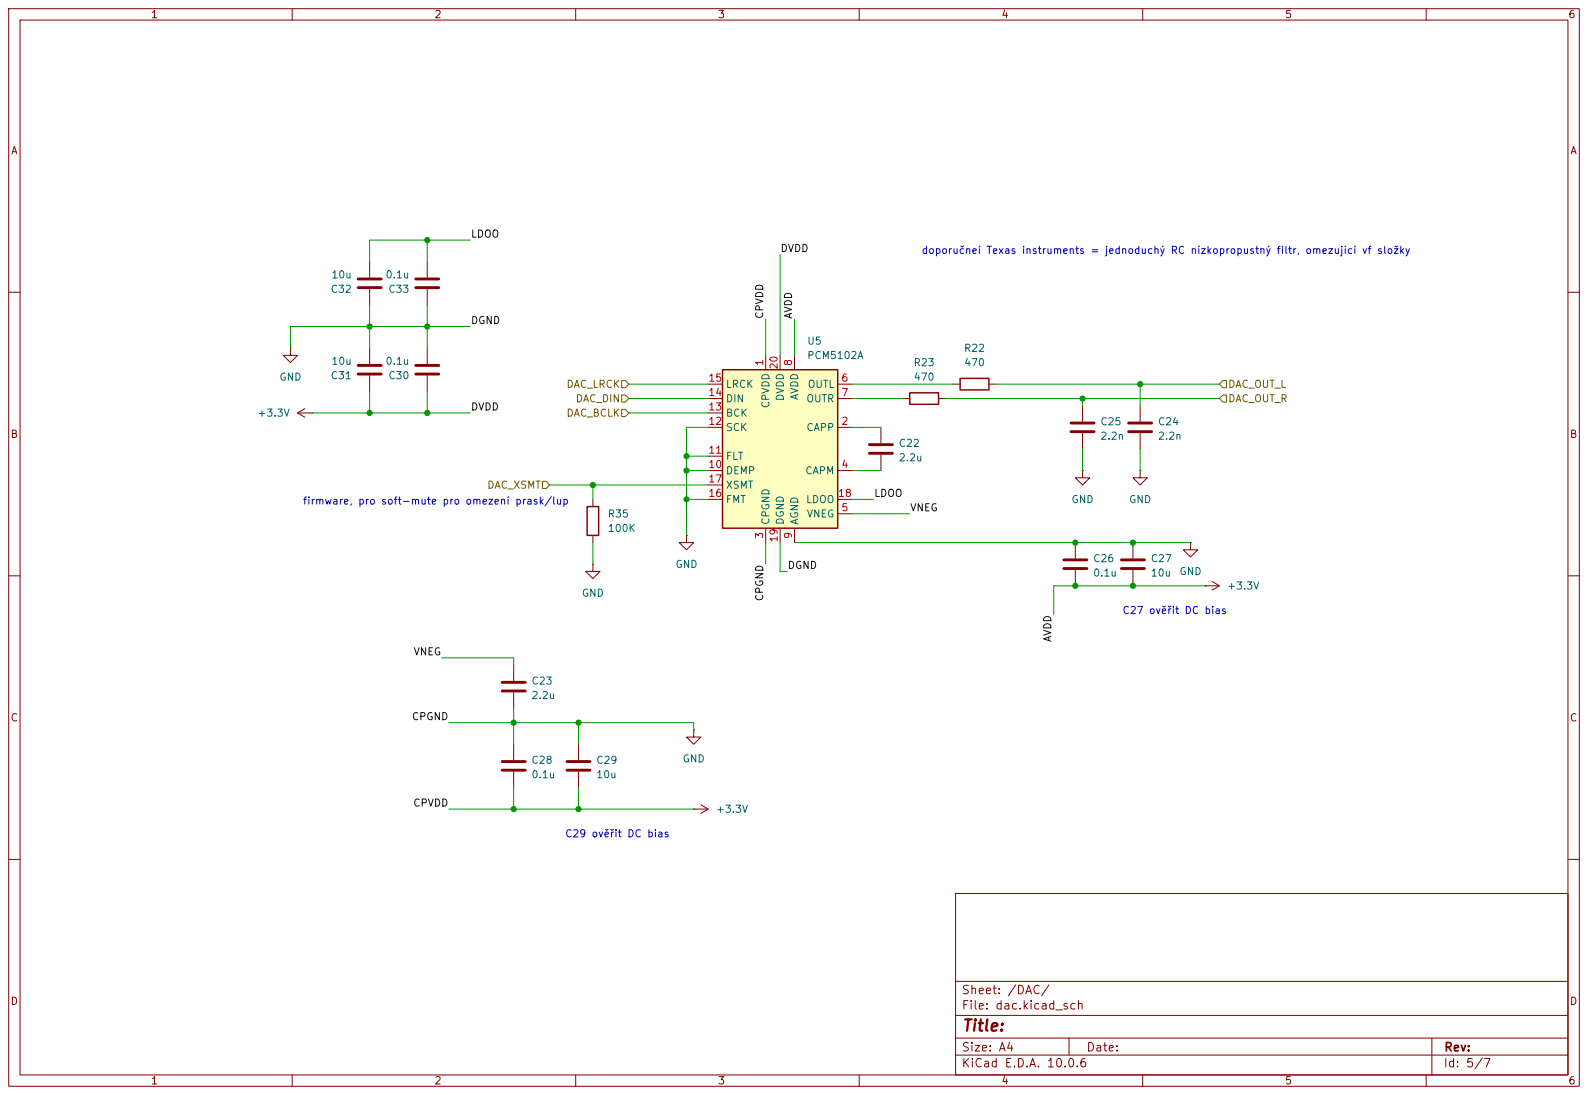
[picture p22: page 5]

doporučneí Texas instruments = jednoduchý RC nízkopropustný filtr, omezující vf složky C29 ověřit DC bias

SCK 12 BCK 13 DIN 14 LRCK 15

firmware, pro soft-mute pro omezení prask/lup

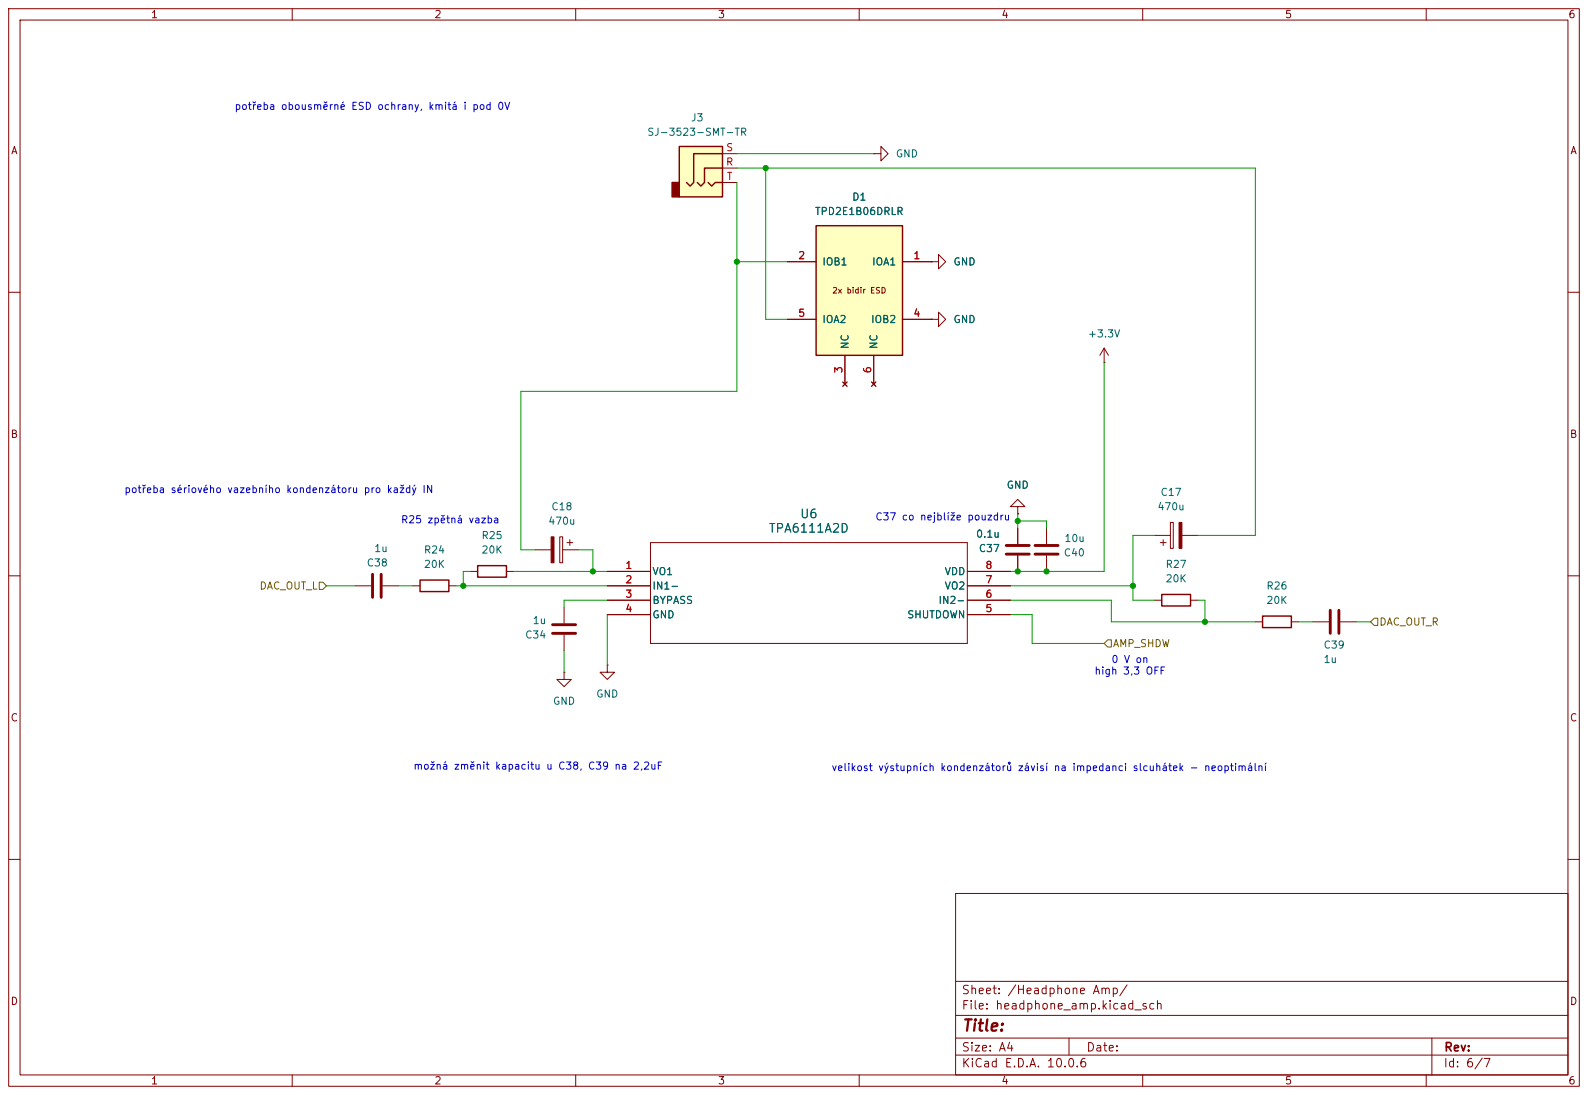
[picture p23: page 6]

velikost výstupních kondenzátorů závisí na impedanci slcuhátek - neoptimální

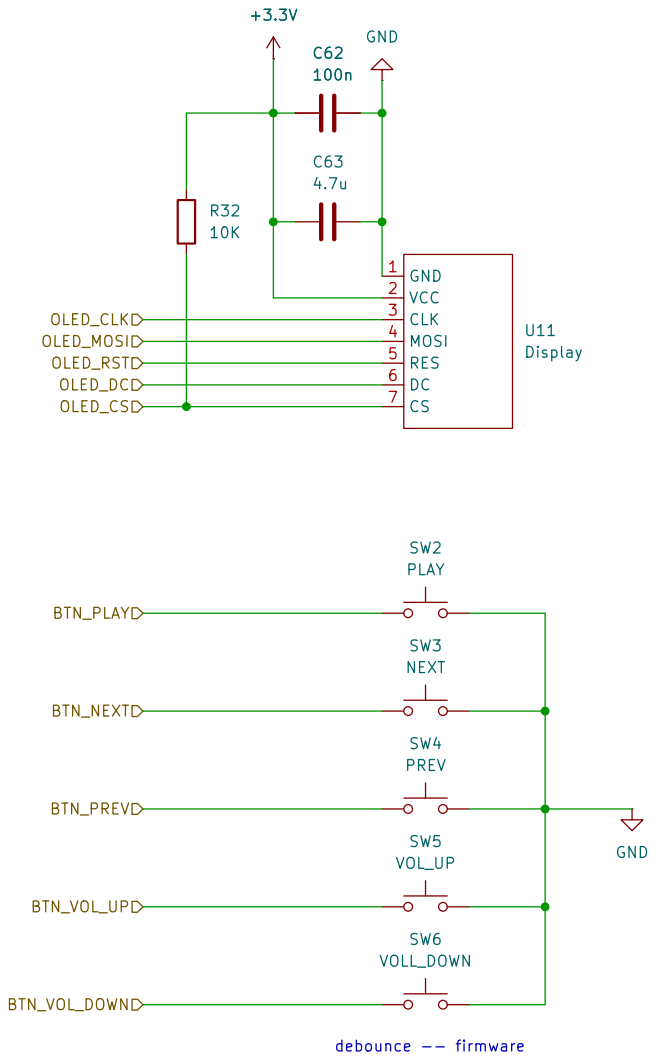
[picture p24: page 7]
