AnnaHruskova/Hruskova_Portable_Audio_Player_with_USB_Audio_Interface/bc_prace-DAC.pdf

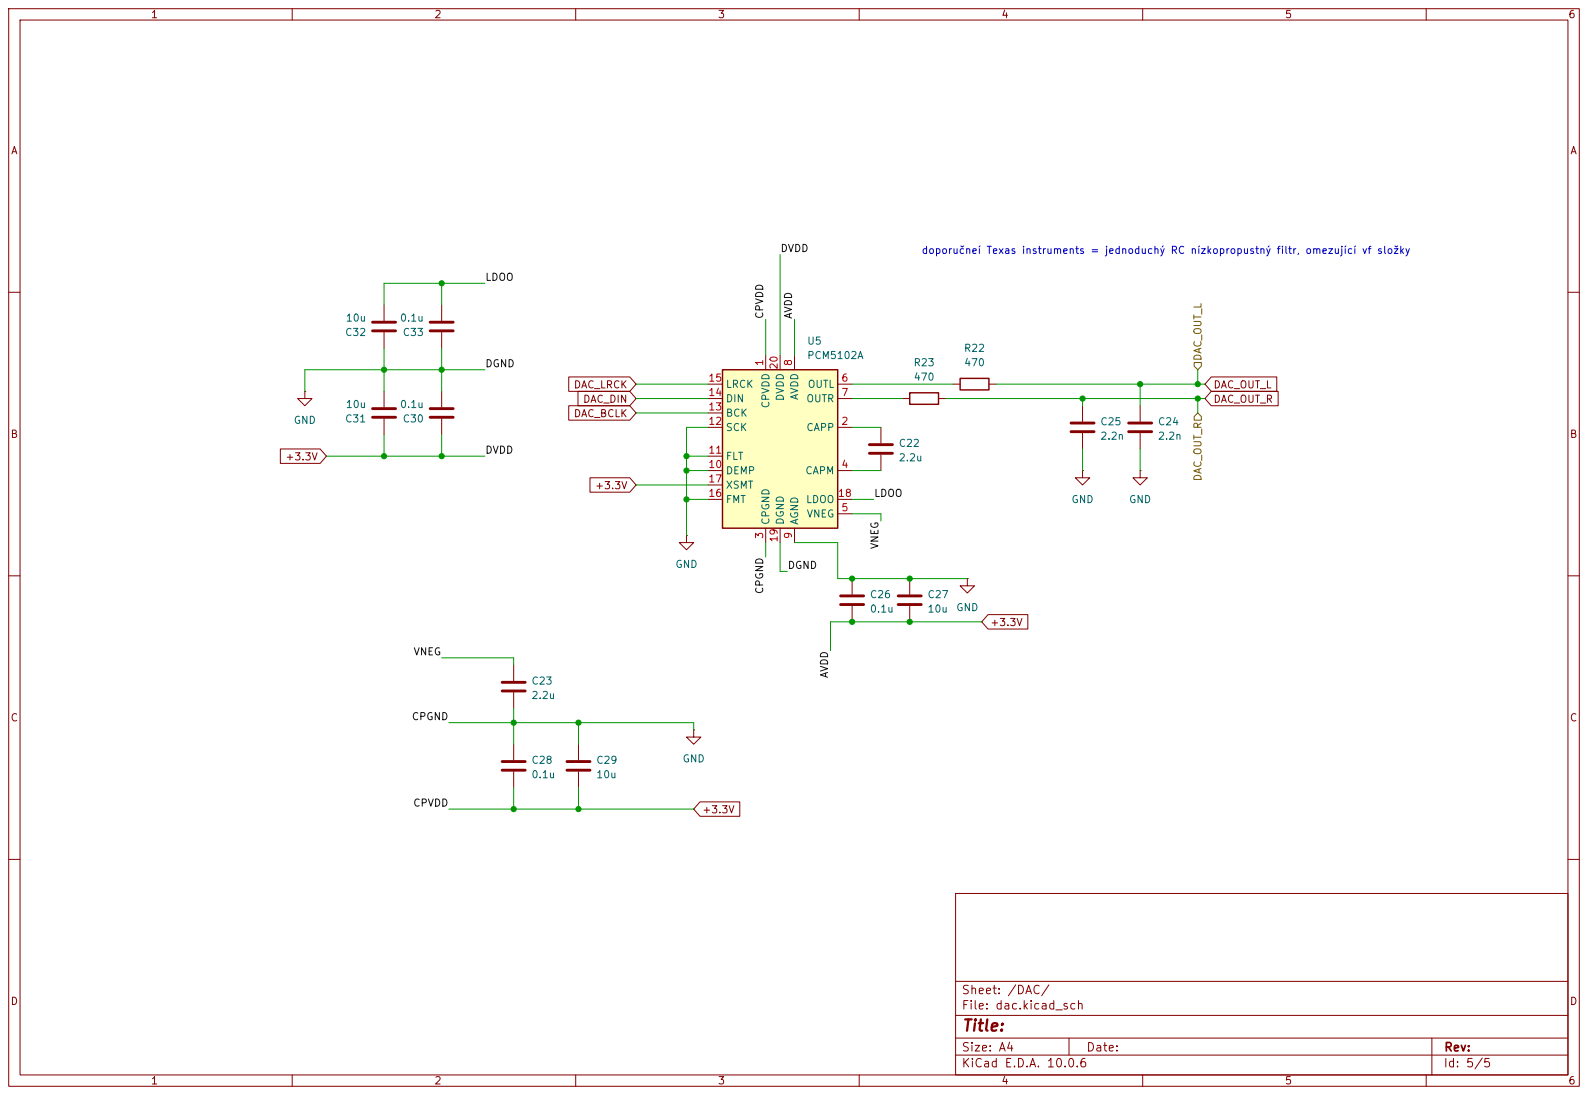
[picture p25: page 1]

doporučneí Texas instruments = jednoduchý RC nízkopropustný filtr, omezující vf složky

SCK 12 BCK 13 DIN 14 LRCK 15

Size: A4 | Rev:
KiCad E.D.A. 10.0.6 | Id: 5/5
