AnnaHruskova/Hruskova_Portable_Audio_Player_with_USB_Audio_Interface/plot_aktualni.pdf

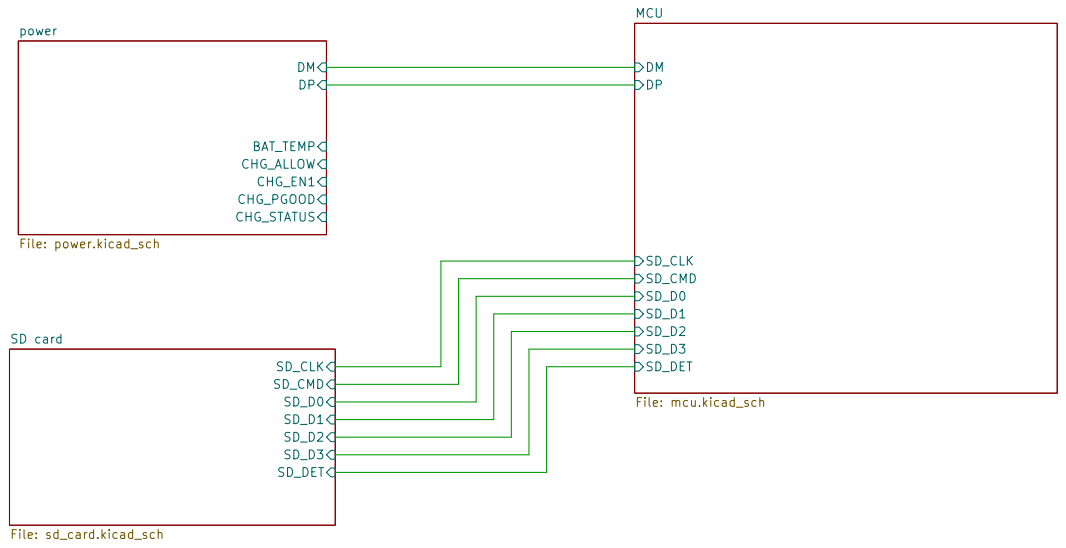
[picture p26: page 1]

Size: A4 | Rev:
KiCad E.D.A. 10.0.6 | Id: 1/4

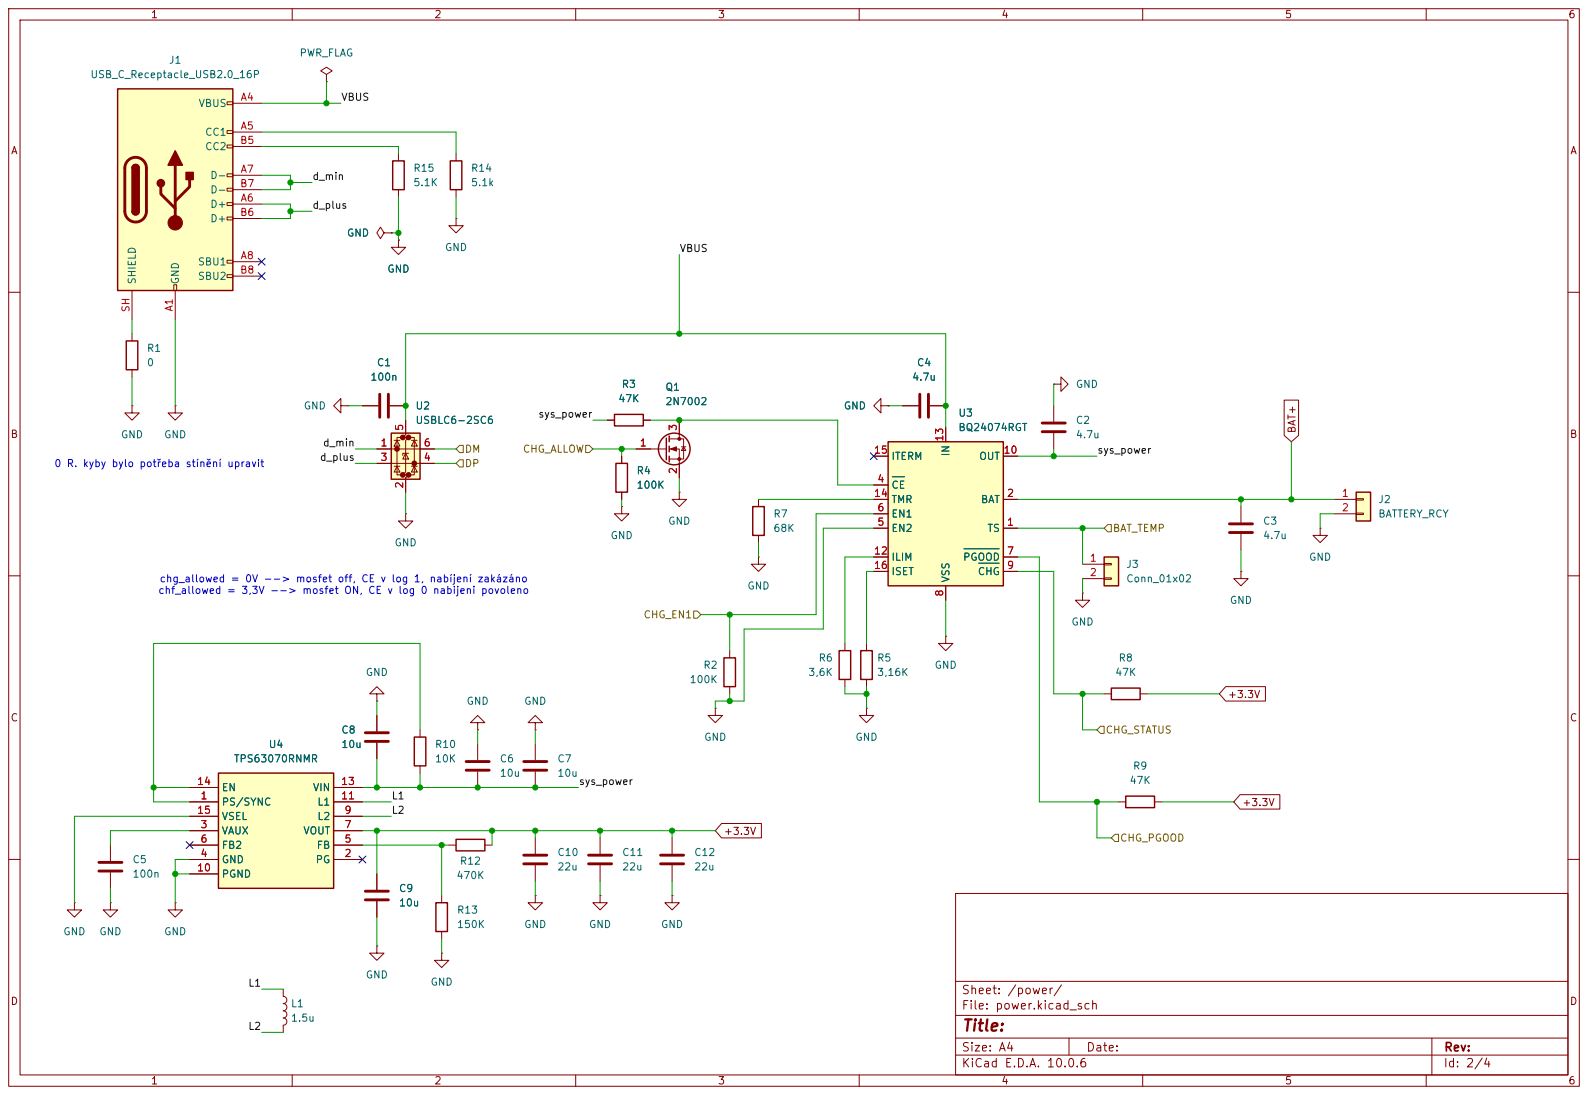
[picture p27: page 2]

chf_allowed = 3,3V --> mosfet ON, CE v log 0 nabijeni povoleno U2USBLC6-2SC6

0 R. kyby bylo potřeba stínění upravit

chg_allowed = 0V --> mosfet off, CE v log 1, nabíjení zakázáno

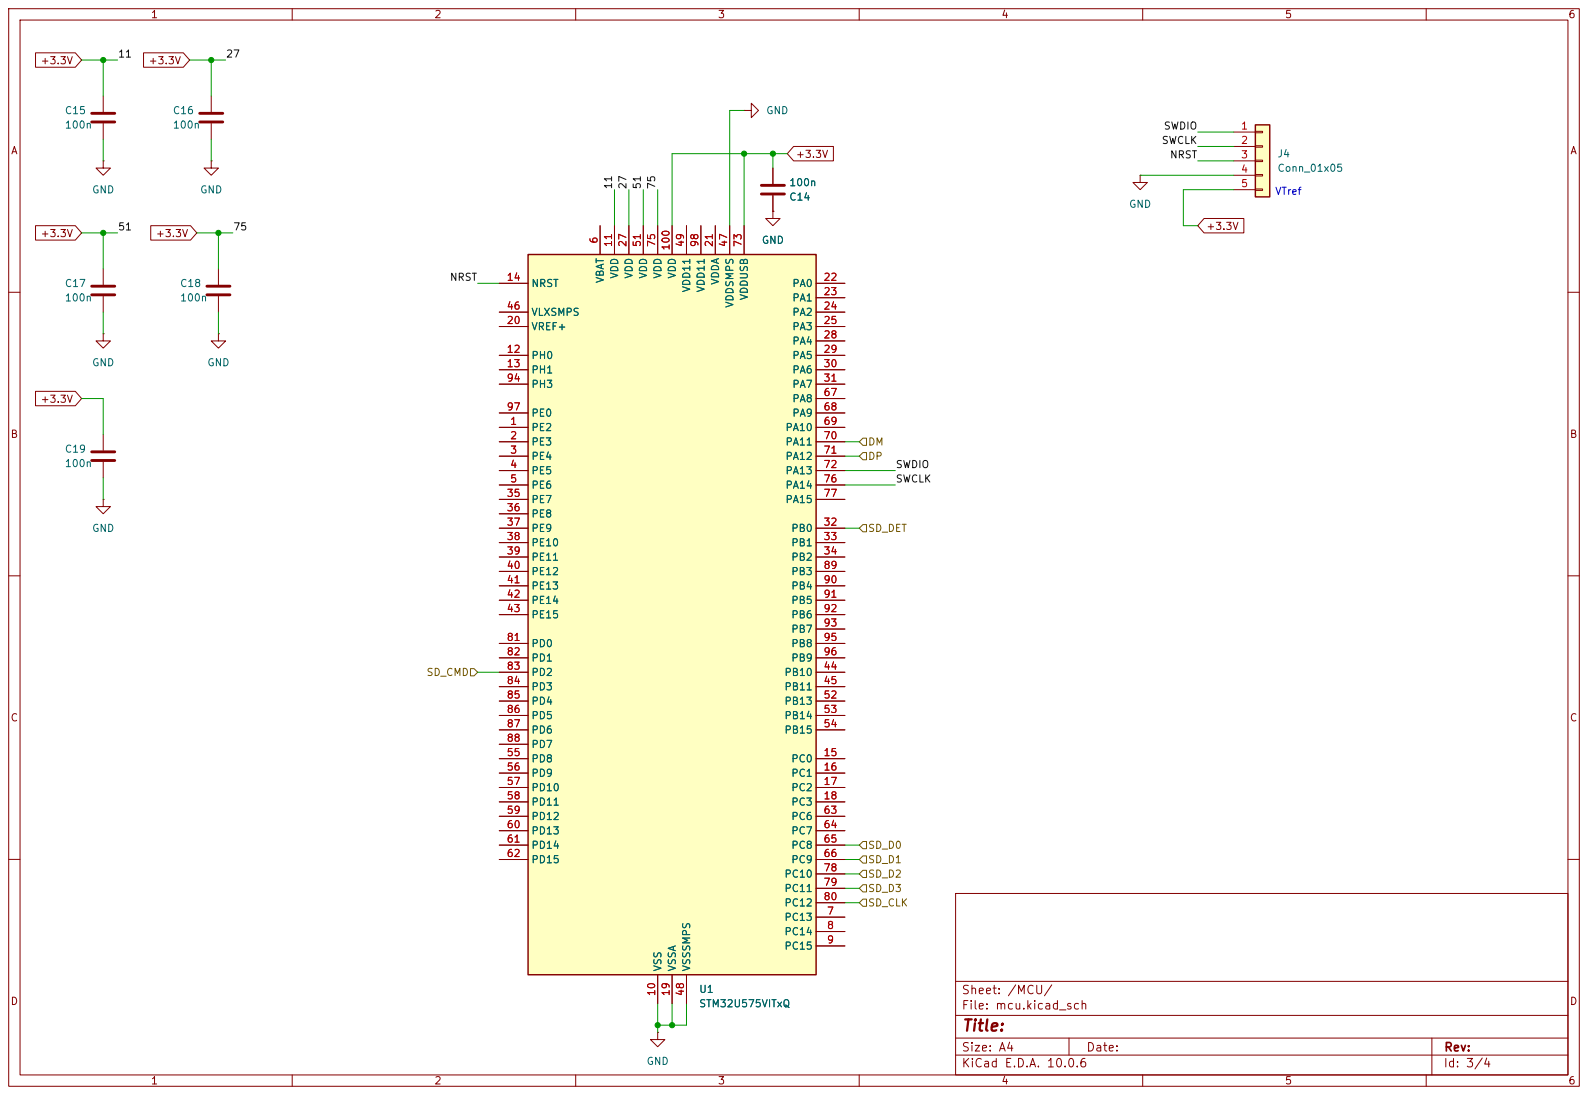
[picture p28: page 3]

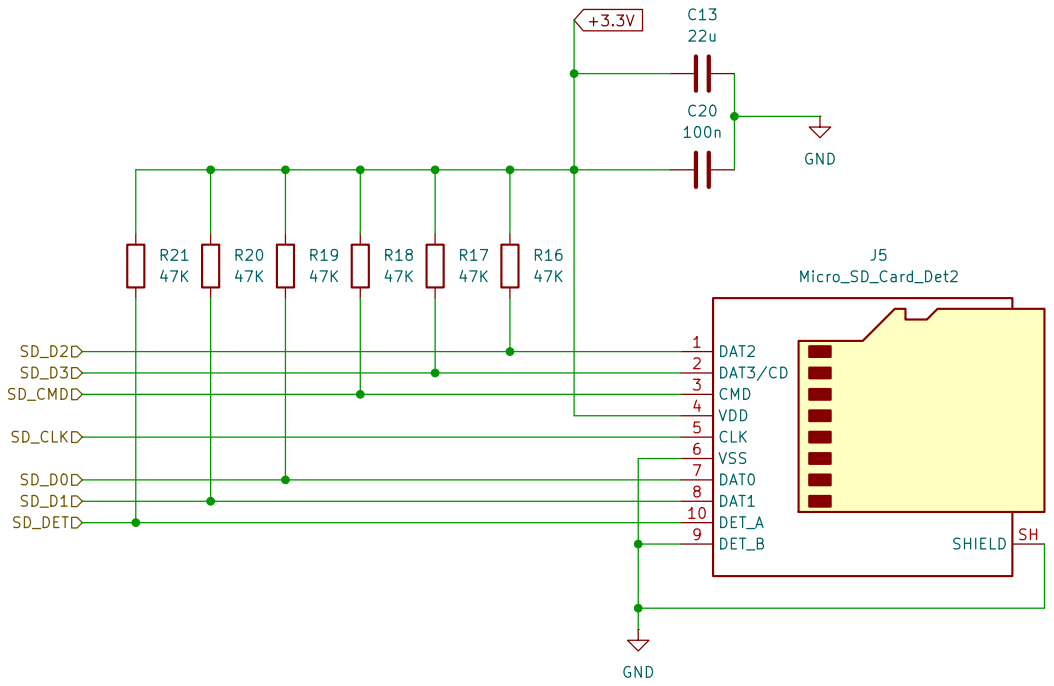
[picture p29: page 4]
