AnnaHruskova/Hruskova_Portable_Audio_Player_with_USB_Audio_Interface/Hardware/KiCAD/bc_prace-B_Mask.pdf

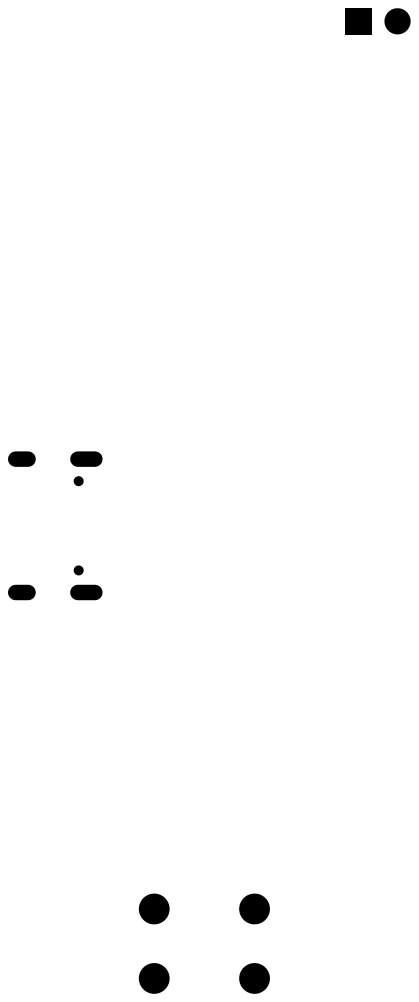
[picture p30: page 1]
