AnnaHruskova/Hruskova_Portable_Audio_Player_with_USB_Audio_Interface/Hardware/KiCAD/bc_prace-Back.pdf

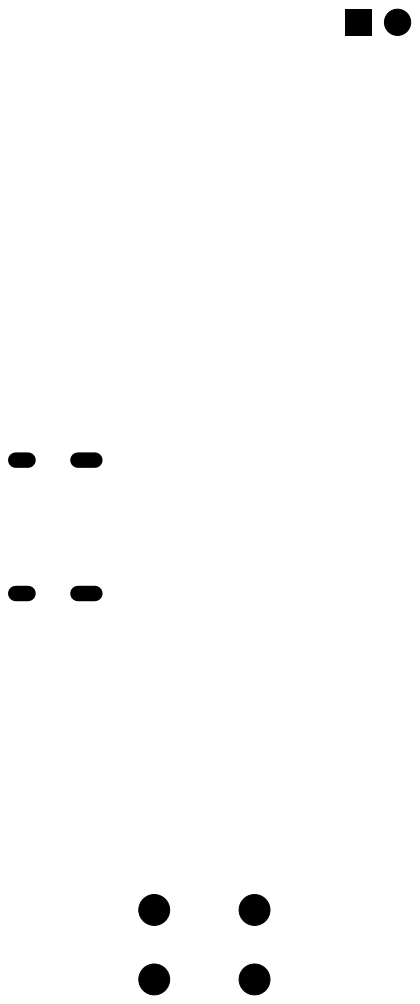
[picture p31: page 1]
