AnnaHruskova/Hruskova_Portable_Audio_Player_with_USB_Audio_Interface/Hardware/KiCAD/bc_prace-F_Silkscreen.pdf

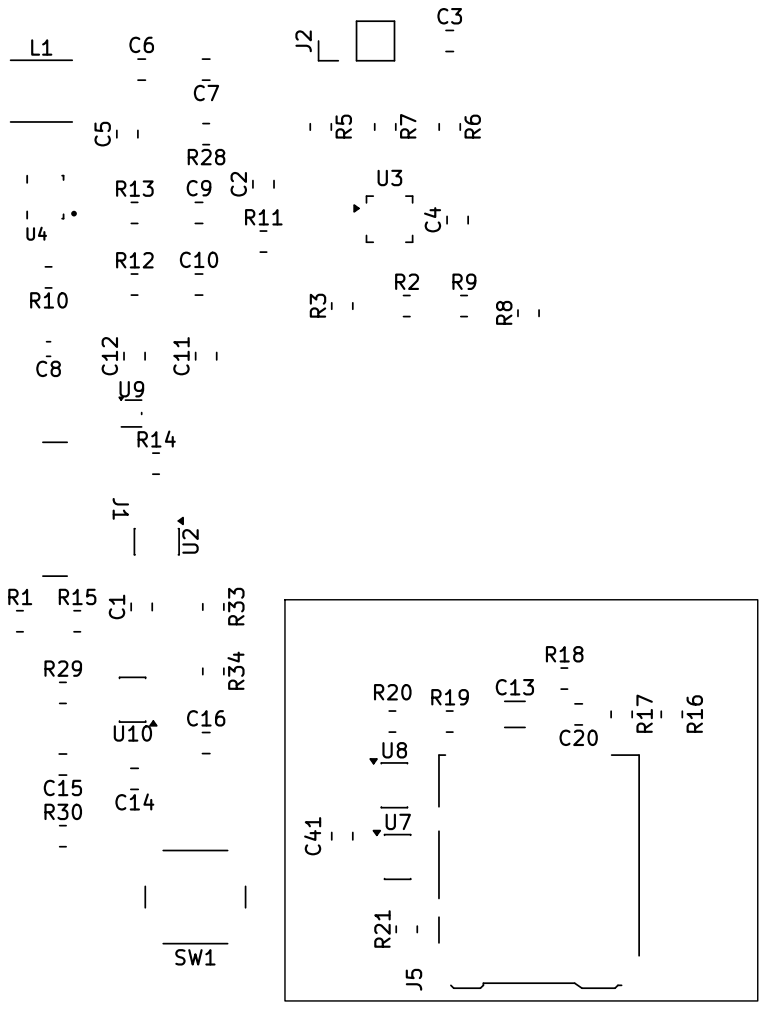
[picture p33: page 1]
