AnnaHruskova/Hruskova_Portable_Audio_Player_with_USB_Audio_Interface/Hardware/KiCAD/bc_prace-Front.pdf

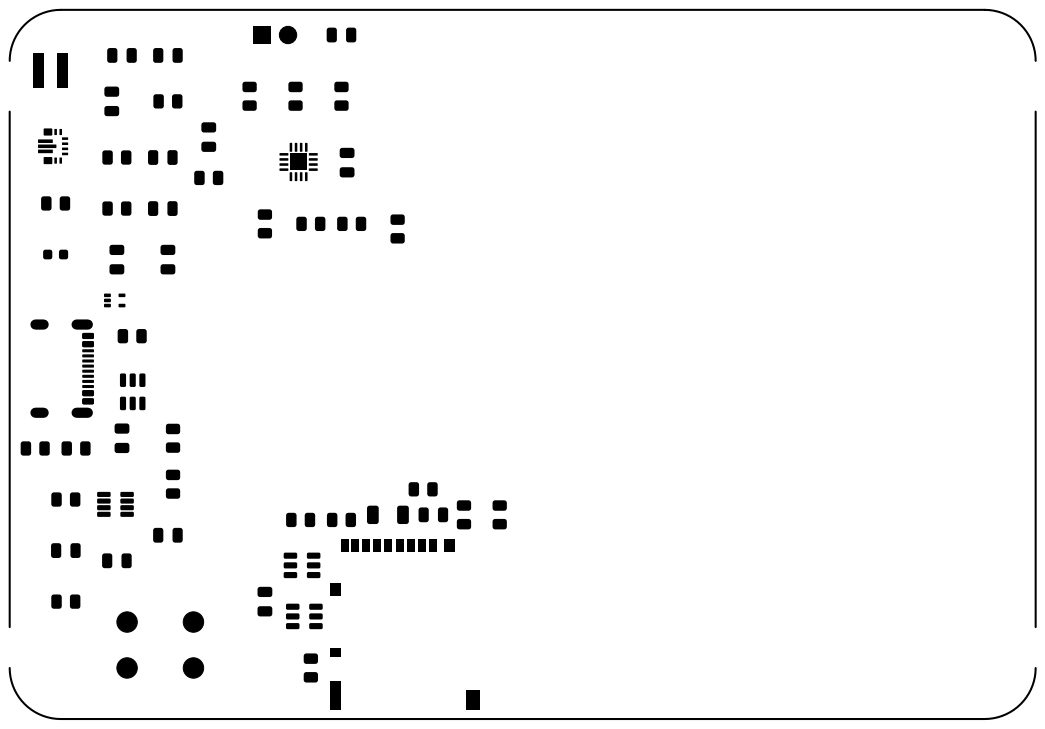
[picture p34: page 1]
