AnnaHruskova/Hruskova_Portable_Audio_Player_with_USB_Audio_Interface/Hardware/KiCAD/bc_prace/bc_prace-F_Cu.pdf

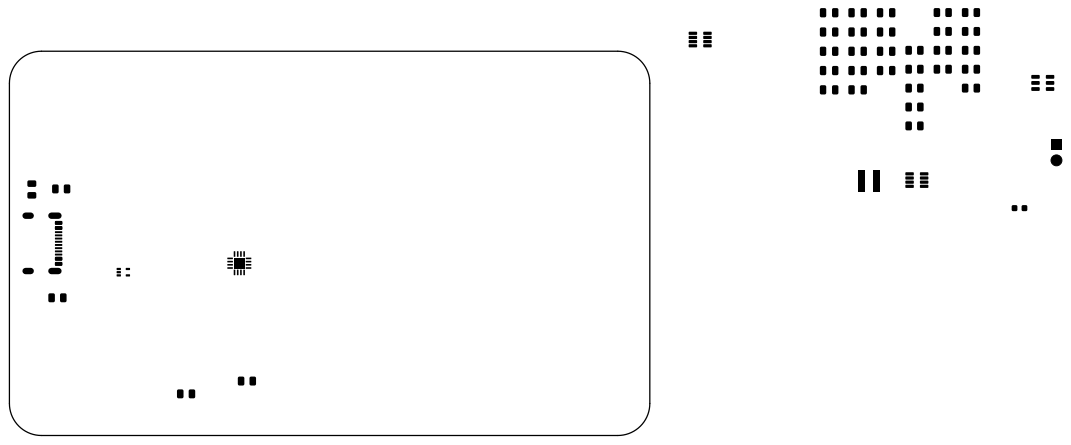
[picture p35: page 1]
