AnnaHruskova/Hruskova_Portable_Audio_Player_with_USB_Audio_Interface/Hardware/KiCAD/bc_prace/bc_prace-F_Mask.pdf

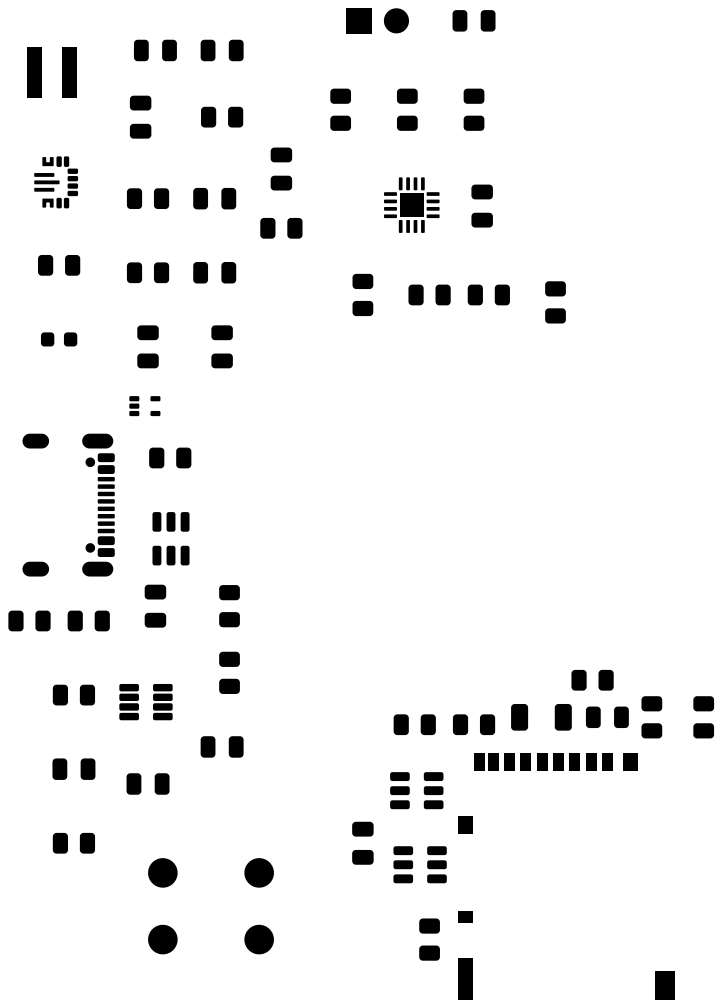
[picture p36: page 1]
