AnnaHruskova/Hruskova_Portable_Audio_Player_with_USB_Audio_Interface/plot (2).pdf

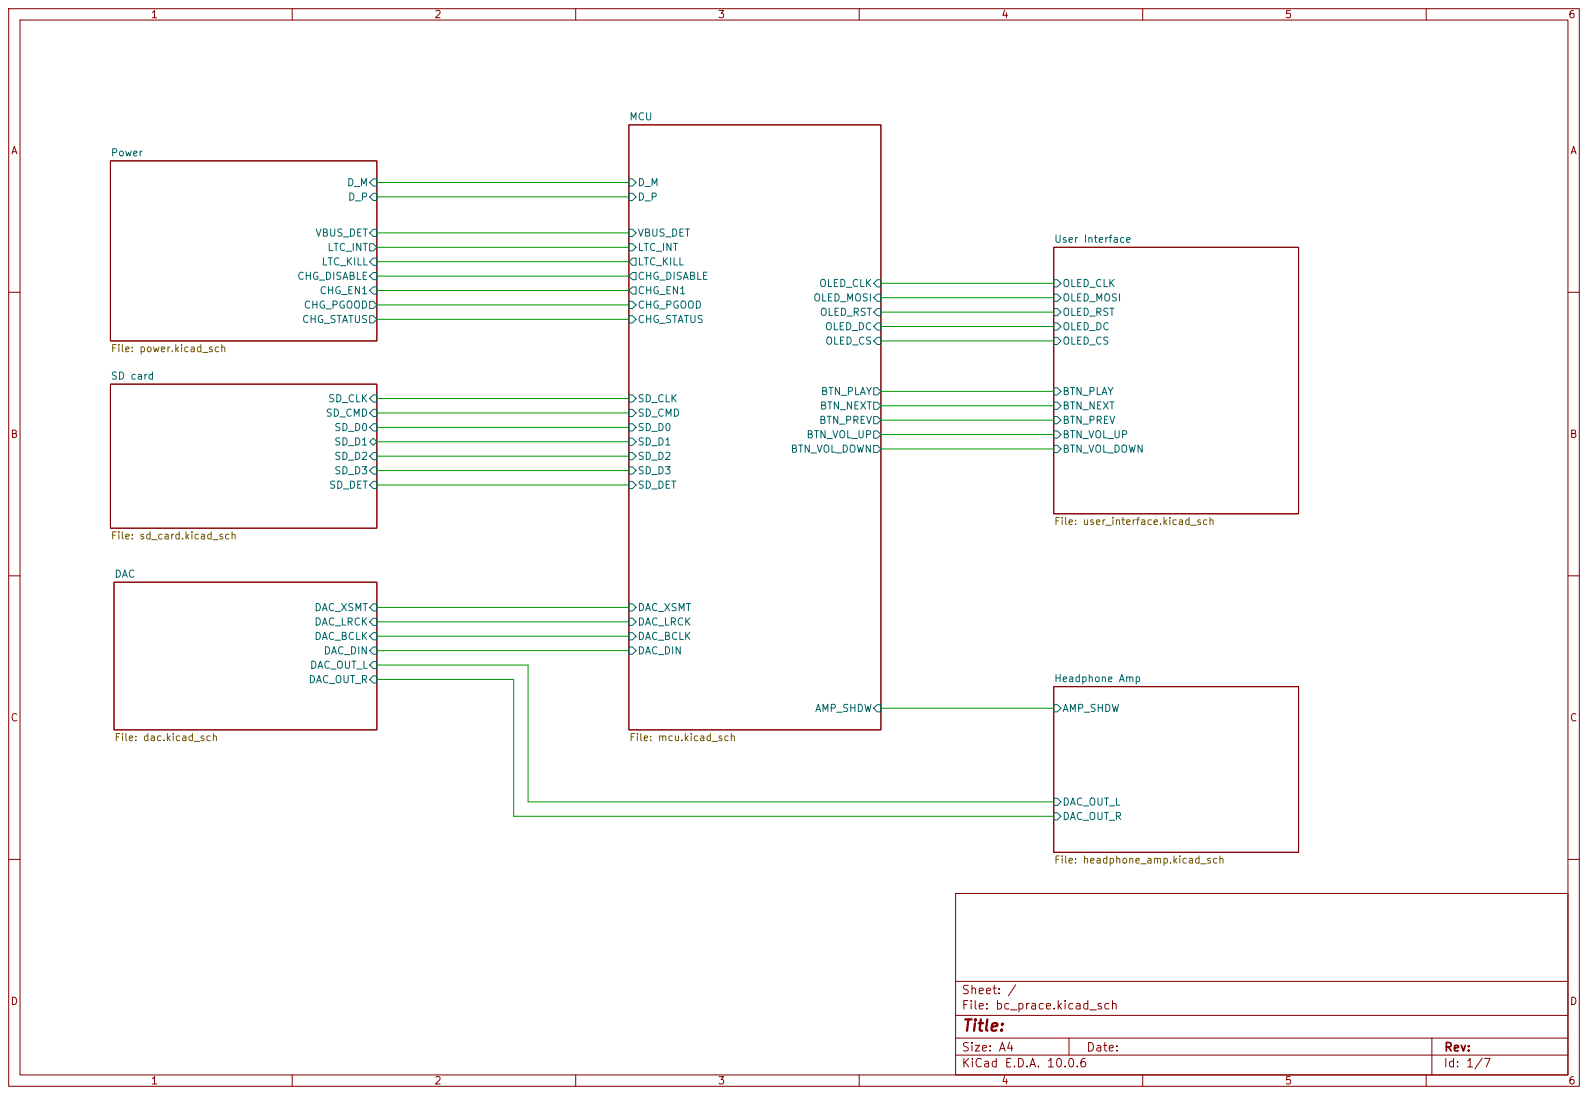
[picture p37: page 1]

Size: A4 | Rev:
KiCad E.D.A. 10.0.6 | Id: 1/7

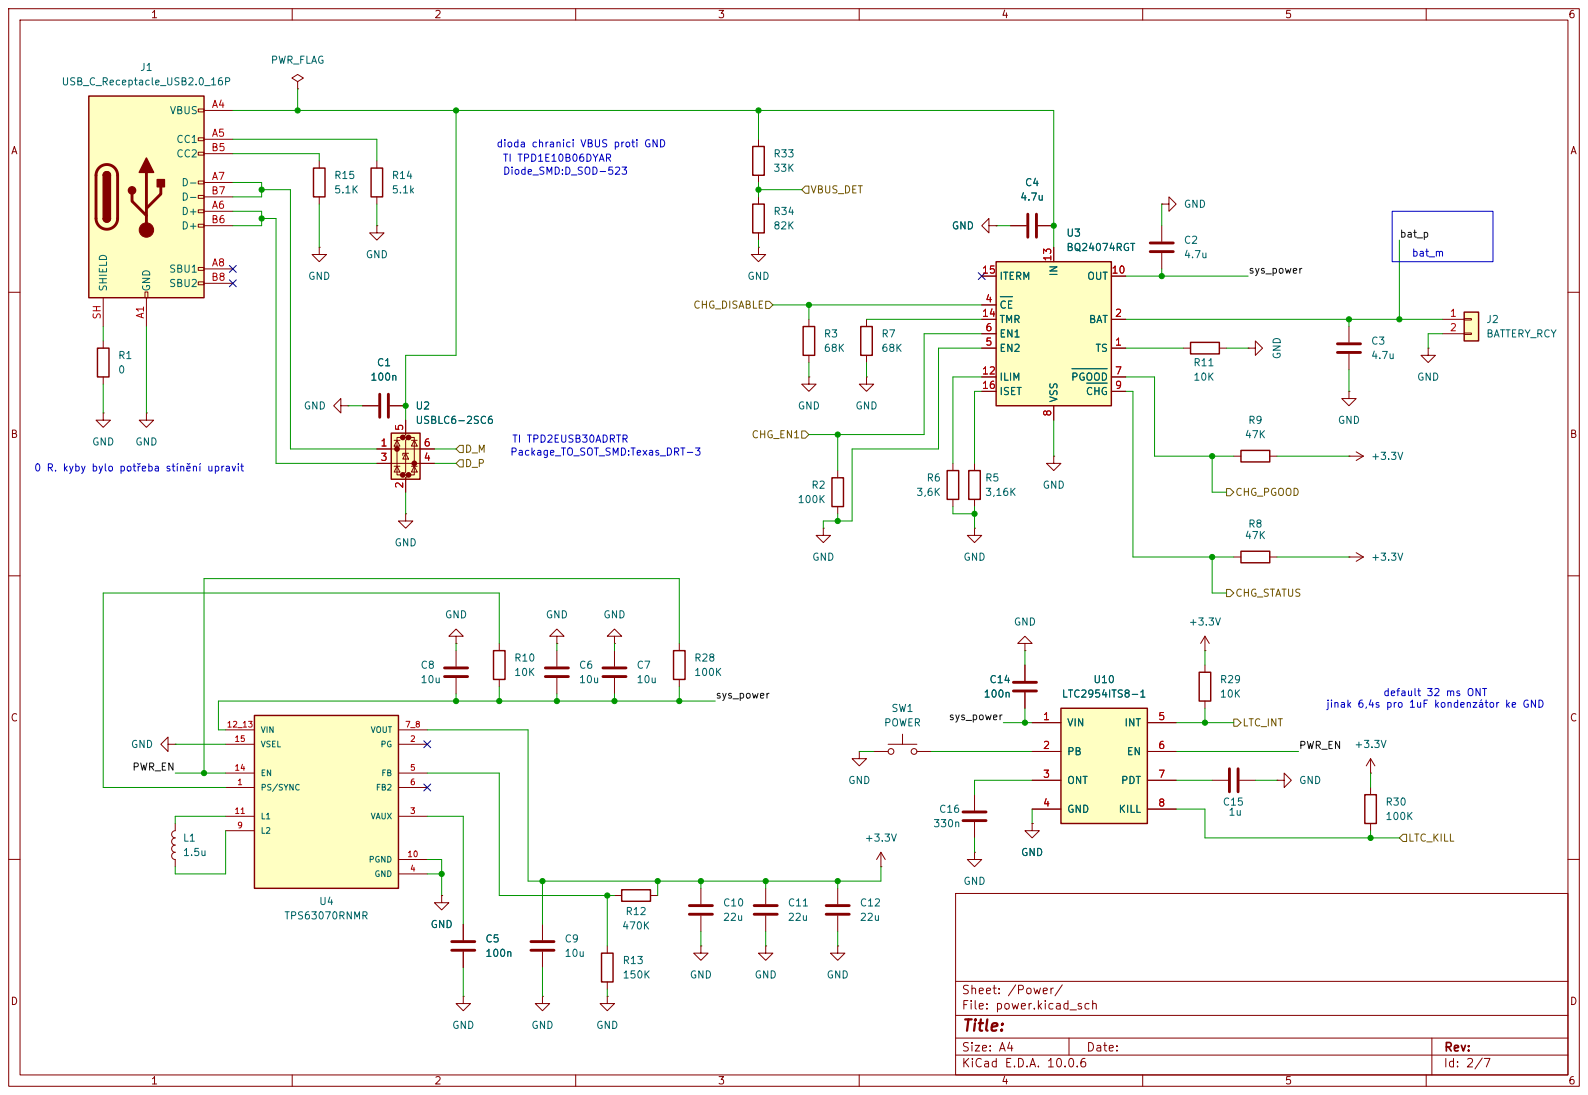
[picture p38: page 2]

dioda chranici VBUS proti GND
TI TPD1E10B06DYAR
Diode_SMD:D_SOD-523

jinak 6,4s pro 1uF kondenzátor ke GND

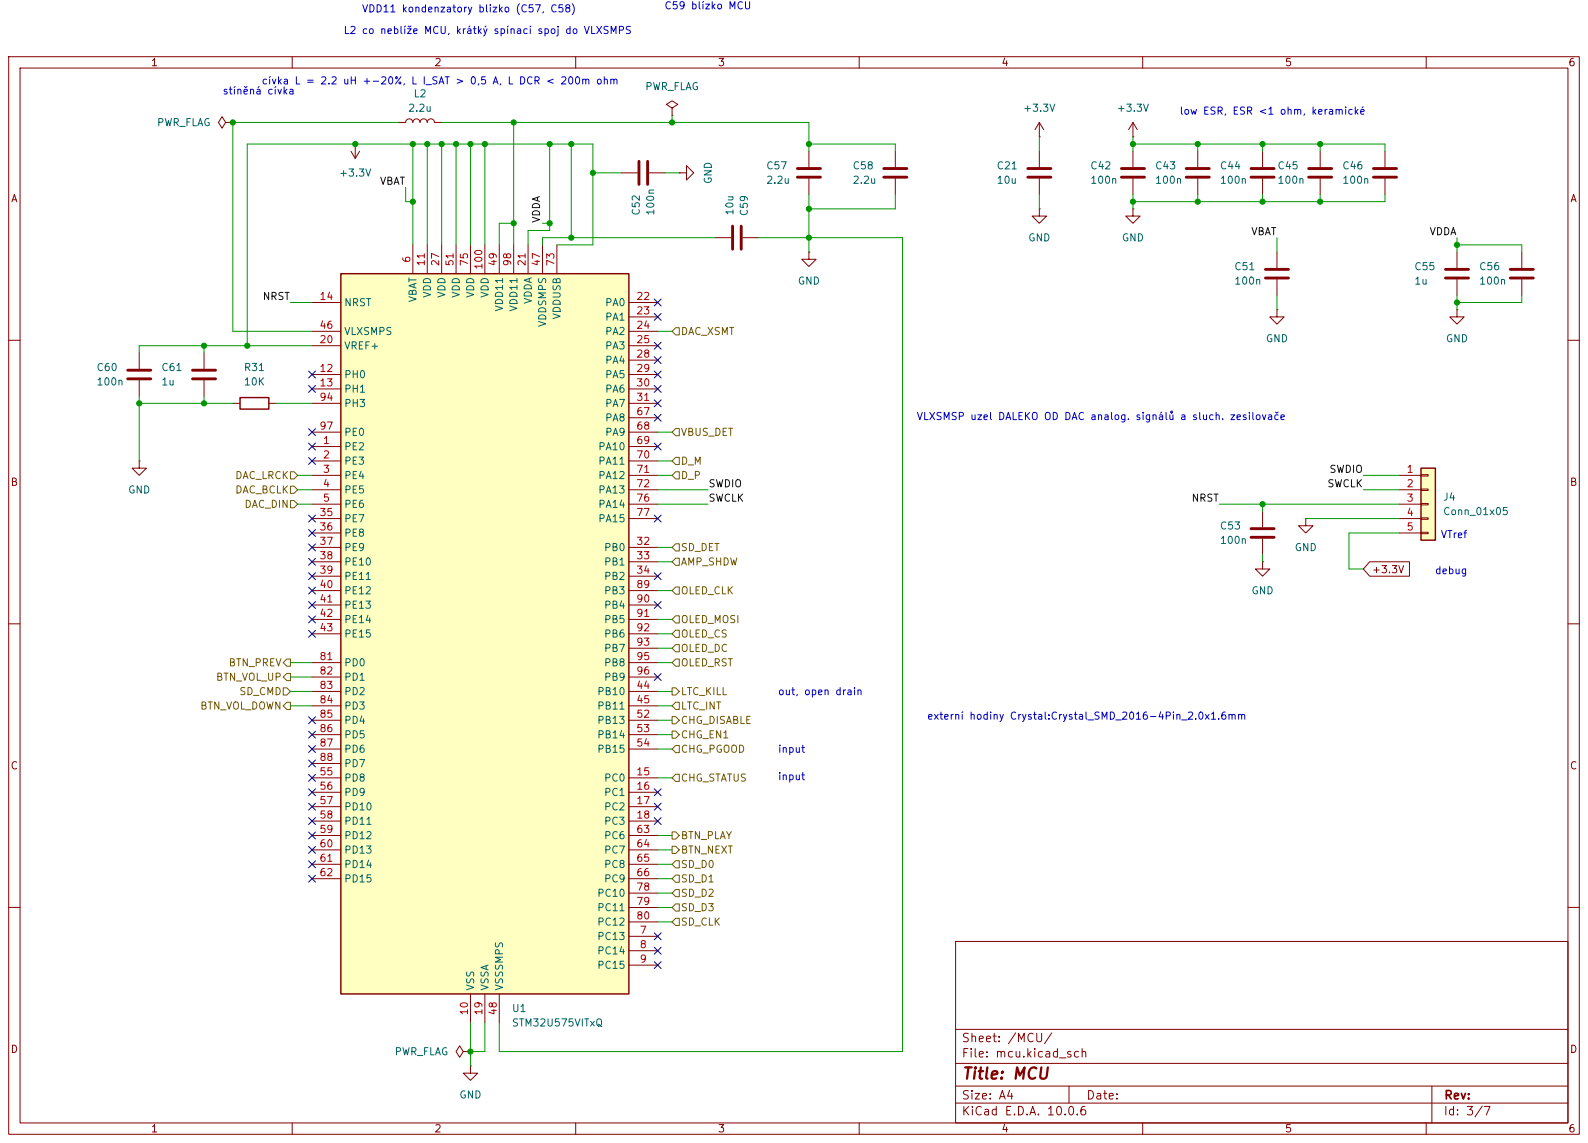
[picture p39: page 3]

VBAT cívka L = 2.2 uH +-20%, L I_SAT > 0,5 A, L DCR < 200m ohm stíněná cívka


karta IN - log 0, C20 blízko pinu SD karty C20 a C41 pouzdro 0805

bez karty log 1, na GND


doporučneí Texas instruments = jednoduchý RC nízkopropustný filtr, omezující vf složky C27 ověřit DC bias

SCK 12 BCK 13 DIN 14 LRCK 15

firmware, pro soft-mute pro omezení prask/lup

velmi blízko k U5 C29 ověřit DC bias


potřeba sériového vazebního kondenzátoru pro každý IN
