AnnaHruskova/Hruskova_Portable_Audio_Player_with_USB_Audio_Interface/Hardware/KiCAD/bc_prace.kicad_pcb

## KiCad design Hardware/KiCAD/bc_prace.kicad_pcb (2026-11-13)

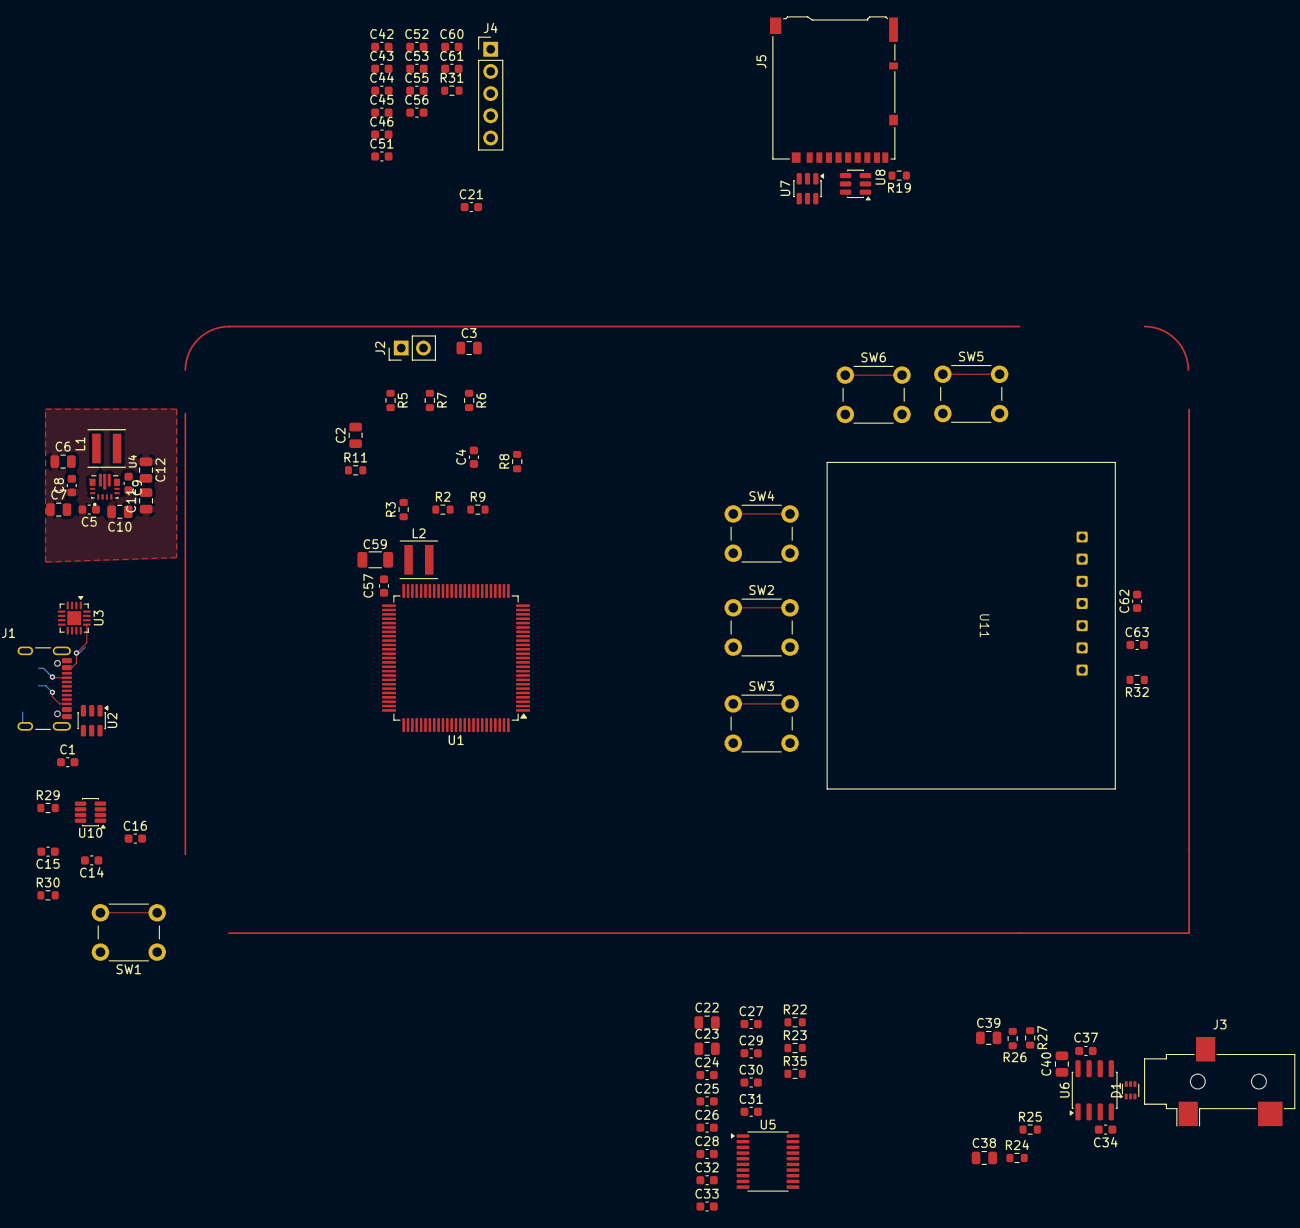
[picture p40: board bc_prace.kicad_pcb from above]

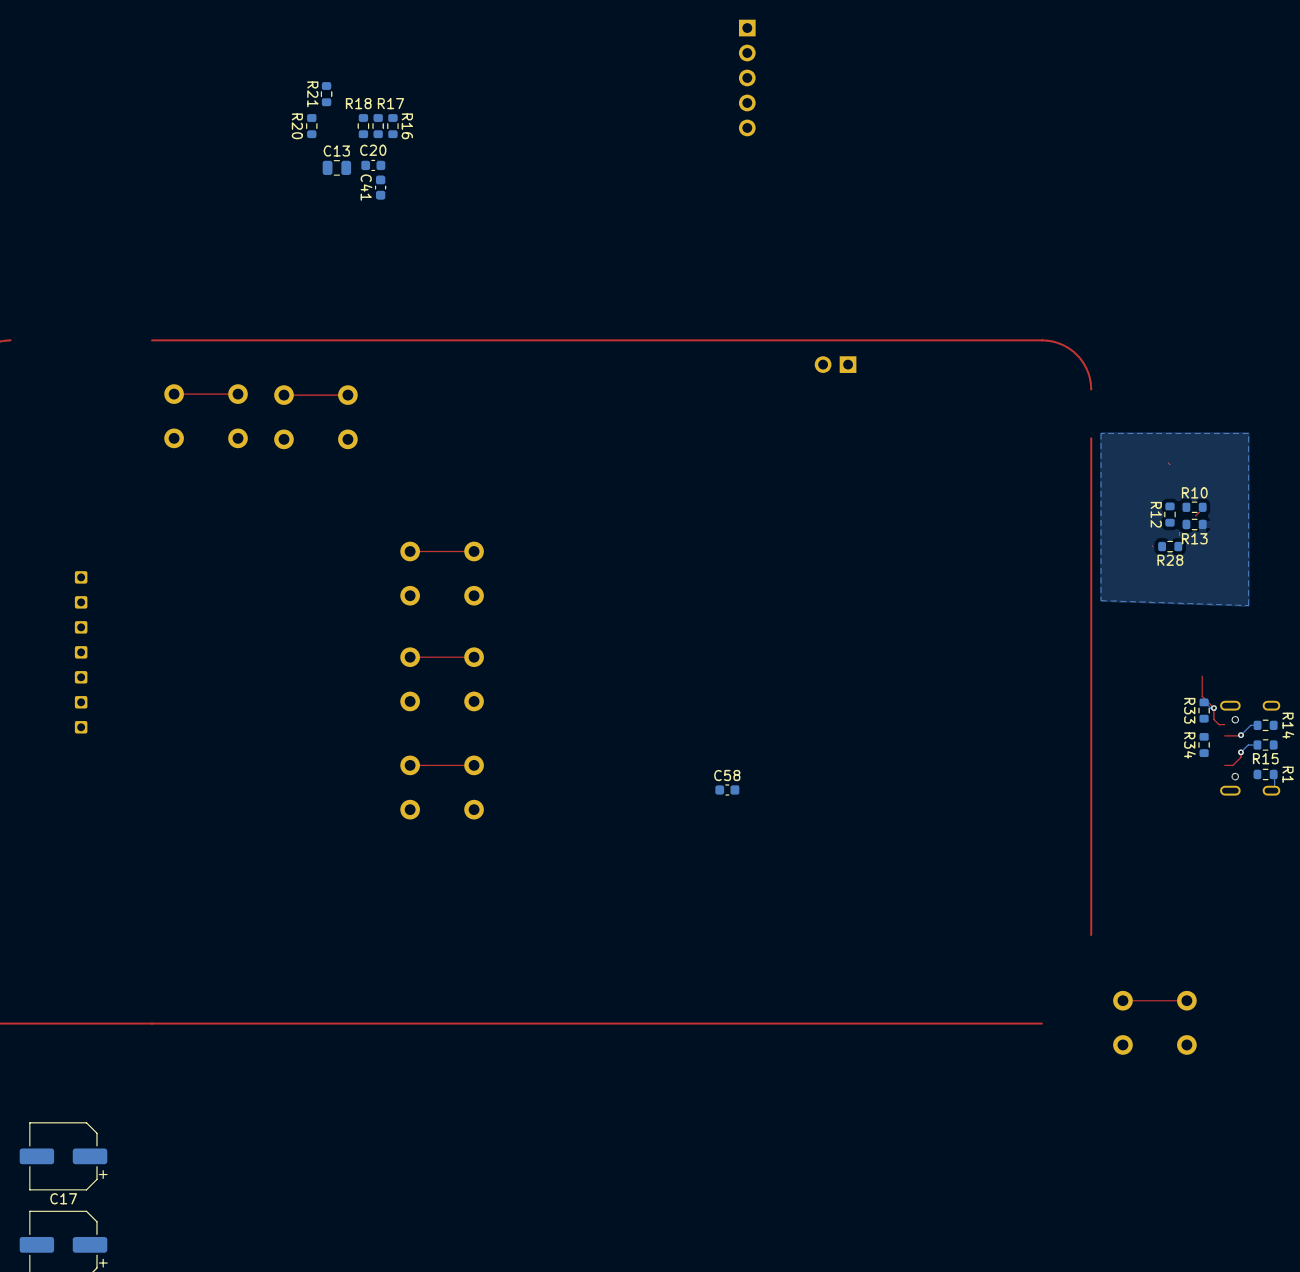
[picture p41: board bc_prace.kicad_pcb from below]

Board: 4 copper layers, 113 parts (20 on the bottom side), 77 nets.

Parts:
C1, C5, C14, C20, C41, C42, C43, C44, C45, C46, C51, C52, C53, C56, C60, C62: 100n; C_0603_1608Metric
C2, C3: 4.7u; C_0805_2012Metric
C4, C63: 4.7u; C_0603_1608Metric
C6, C7, C40: 10u; C_0805_2012Metric
C8, C9, C21, C27, C29, C31, C32: 10u; C_0603_1608Metric
C10, C11, C12, C13: 22u; C_0805_2012Metric
C15, C34, C55, C61: 1u; C_0603_1608Metric
C16: 330n; C_0603_1608Metric
C17, C18: 470u; CP_Elec_6.3x7.7
C22, C23, C38, C39: 2.2u; C_0805_2012Metric
C24, C25: 2.2n; C_0603_1608Metric
C26, C28, C30, C33, C37: 0.1u; C_0603_1608Metric
C57, C58: 2.2u; C_0603_1608Metric
C59: 10u; C_1206_3216Metric
D1: TPD2E1B06DRLR; SOT-563
J1: USB_C_Receptacle_USB2.0_16P; USB_C_Receptacle_GCT_USB4105-xx-A_16P_TopMnt_Horizontal
J2: BATTERY_RCY; PinHeader_1x02_P2.54mm_Vertical
J3: SJ-3523-SMT-TR; Jack_3.5mm_CUI_SJ-3523-SMT_Horizontal
J4: Conn_01x05; PinHeader_1x05_P2.54mm_Vertical
J5: DM3AT-SF-PEJM5; microSD_HC_Hirose_DM3AT-SF-PEJM5
L1: 1.5u; L_Coilcraft_XxL4020
L2: 2.2u; L_Coilcraft_XxL4020
R1: 0; R_0603_1608Metric
R2, R28, R30, R35: 100K; R_0603_1608Metric
R3, R7: 68K; R_0603_1608Metric
R5: 3,16K; R_0603_1608Metric
R6: 3,6K; R_0603_1608Metric
R8, R9, R16, R17, R18, R19, R20, R21: 47K; R_0603_1608Metric
R10, R11, R29, R31, R32: 10K; R_0603_1608Metric
R12: 470K; R_0603_1608Metric
R13: 150K; R_0603_1608Metric
R14: 5.1k; R_0603_1608Metric
R15: 5.1K; R_0603_1608Metric
R22, R23: 470; R_0603_1608Metric
R24, R25, R26, R27: 20K; R_0603_1608Metric
R33: 33K; R_0603_1608Metric
R34: 82K; R_0603_1608Metric
SW1: POWER; SW_PUSH_6mm
SW2: PLAY; SW_PUSH_6mm
SW3: NEXT; SW_PUSH_6mm
SW4: PREV; SW_PUSH_6mm
SW5: VOL_UP; SW_PUSH_6mm
SW6: VOLL_DOWN; SW_PUSH_6mm
U1: STM32U575VITxQ; LQFP-100_14x14mm_P0.5mm
U2: USBLC6-2SC6; SOT-23-6
U3: BQ24074RGT; VQFN-16-1EP_3x3mm_P0.5mm_EP1.6x1.6mm
U4: TPS63070RNMR; VREG_TPS63070RNMR
U5: PCM5102A; TSSOP-20_4.4x6.5mm_P0.65mm
U6: TPA6111A2D; SOIC-8_3.9x4.9mm_P1.27mm
U7, U8: USBLC6-4SC6; SOT-23-6
U10: LTC2954ITS8-1; TSOT-23-8
U11: Display; OLED_SPI_7pin_P2.54mm

Connections:
+3.3V: C9.2, C10.2, C11.2, C12.2, C13.2, C20.2, C21.2, C26.1, C27.1, C28.1, C29.1, C30.2, C31.2, C37.2, C40.2, C41.1, C42.2, C43.2, C44.2, C45.2, C46.2, C51.2, C52.2, C55.2, C56.2, C59.1, C60.2, C61.2, C62.1, C63.1, J4.5, J5.4 (VDD), R8.1, R9.1, R12.2, R16.1, R17.1, R18.1, R19.1, R20.1, R21.1, R29.1, R30.1, R32.1, U1.6 (VBAT), U1.11 (VDD), U1.20 (VREF+), U1.21 (VDDA), U1.27 (VDD), U1.47 (VDDSMPS), U1.51 (VDD), U1.73 (VDDUSB), U1.75 (VDD), U1.100 (VDD), U4.7_8 (VOUT), U5.1 (CPVDD), U5.8 (AVDD), U5.20 (DVDD), U6.8 (VDD), U7.5 (VBUS), U8.5 (VBUS), U11.2 (VCC)
/DAC/DAC_BCLK: U1.4 (PE5), U5.13 (BCK)
/DAC/DAC_DIN: U1.5 (PE6), U5.14 (DIN)
/DAC/DAC_LRCK: U1.3 (PE4), U5.15 (LRCK)
/DAC/DAC_OUT_L: C24.2, C38.2, R22.2
/DAC/DAC_OUT_R: C25.2, C39.2, R23.2
/DAC/DAC_XSMT: R35.2, U1.24 (PA2), U5.17 (XSMT)
/DAC/LDOO: C32.1, C33.1, U5.18 (LDOO)
/DAC/VNEG: C23.2, U5.5 (VNEG)
/Headphone Amp/AMP_SHDW: U1.33 (PB1), U6.5 (SHUTDOWN)
/MCU/BTN_NEXT: SW3.1, U1.64 (PC7)
/MCU/BTN_PLAY: SW2.1, U1.63 (PC6)
/MCU/BTN_PREV: SW4.1, U1.81 (PD0)
/MCU/BTN_VOL_DOWN: SW6.1, U1.84 (PD3)
/MCU/BTN_VOL_UP: SW5.1, U1.82 (PD1)
/MCU/CHG_DISABLE: R3.2, U1.52 (PB13), U3.4 (~CE)
/MCU/CHG_EN1: R2.2, U1.53 (PB14), U3.6 (EN1)
/MCU/CHG_PGOOD: R9.2, U1.54 (PB15), U3.7 (~PGOOD)
/MCU/CHG_STATUS: R8.2, U1.15 (PC0), U3.9 (~CHG)
/MCU/D_M: U1.70 (PA11), U2.6 (I/O1)
/MCU/D_P: U1.71 (PA12), U2.4 (I/O2)
/MCU/LTC_INT: R29.2, U1.45 (PB11), U10.5 (INT)
/MCU/LTC_KILL: R30.2, U1.44 (PB10), U10.8 (KILL)
/MCU/NRST: C53.2, J4.3, U1.14 (NRST)
/MCU/OLED_CLK: U1.89 (PB3), U11.3 (CLK)
/MCU/OLED_CS: R32.2, U1.92 (PB6), U11.7 (CS)
/MCU/OLED_DC: U1.93 (PB7), U11.6 (DC)
/MCU/OLED_MOSI: U1.91 (PB5), U11.4 (MOSI)
/MCU/OLED_RST: U1.95 (PB8), U11.5 (RES)
/MCU/SD_CLK: J5.5 (CLK), U1.80 (PC12), U8.6 (I/O4)
/MCU/SD_CMD: J5.3 (CMD), R18.2, U1.83 (PD2), U8.4 (I/O3)
/MCU/SD_D0: J5.7 (DAT0), R19.2, U1.65 (PC8), U8.3 (I/O2)
/MCU/SD_D1: J5.8 (DAT1), R20.2, U1.66 (PC9), U8.1 (I/O1)
/MCU/SD_D2: J5.1 (DAT2), R16.2, U1.78 (PC10), U7.3 (I/O2)
/MCU/SD_D3: J5.2 (DAT3/CD), R17.2, U1.79 (PC11), U7.1 (I/O1)
/MCU/SD_DET: J5.10 (DET_A), R21.2, U1.32 (PB0), U7.4 (I/O3)
/MCU/SWCLK: J4.2, U1.76 (PA14)
/MCU/SWDIO: J4.1, U1.72 (PA13)
/MCU/VBUS_DET: R33.2, R34.1, U1.68 (PA9)
/Power/PWR_EN: R28.1, U4.14 (EN), U10.6 (EN)
/Power/bat_p: C3.1, J2.1, U3.2 (BAT), U3.3 (BAT)
/Power/sys_power: C2.2, C6.2, C7.2, C8.2, C14.2, R10.2, R28.2, U3.10 (OUT), U3.11 (OUT), U4.12_13 (VIN), U10.1 (VIN)
GND: C1.1, C2.1, C3.2, C4.1, C5.2, C6.1, C7.1, C8.1, C9.1, C10.1, C11.1, C12.1, C13.1, C14.1, C15.2, C16.2, C20.1, C21.1, C23.1, C24.1, C25.1, C26.2, C27.2, C28.2, C29.2, C30.1, C31.1, C32.2, C33.2, C34.2, C37.1, C40.1, C41.2, C42.1, C43.1, C44.1, C45.1, C46.1, C51.1, C52.1, C53.1, C55.1, C56.1, C57.1, C58.1, C59.2, C60.1, C61.1, C62.2, C63.2, D1.1 (IOA1), D1.4 (IOB2), J1.A1 (GND), J1.A12 (GND), J1.B1 (GND), J1.B12 (GND), J2.2, J3.S, J4.4, J5.6 (VSS), J5.9 (DET_B), J5.SH (SHIELD), R1.2, R2.1, R3.1, R5.1, R6.1, R7.1, R11.1, R13.2, R14.2, R15.1, R31.2, R34.2, R35.1, SW1.1, SW2.2, SW3.2, SW4.2, SW5.2, SW6.2, U1.10 (VSS), U1.19 (VSSA), U1.26 (VSS), U1.48 (VSSSMPS), U1.50 (VSS), U1.74 (VSS), U1.99 (VSS), U2.2 (GND), U3.5 (EN2), U3.8 (VSS), U3.17 (VSS), U4.4 (GND), U4.10 (PGND), U4.15 (VSEL), U5.3 (CPGND), U5.9 (AGND), U5.10 (DEMP), U5.11 (FLT), U5.12 (SCK), U5.16 (FMT), U5.19 (DGND), U6.4 (GND), U7.2 (GND), U8.2 (GND), U10.4 (GND), U11.1 (GND)
unnamed: C38.1, R24.1
unnamed: C39.1, R26.1
unnamed: C57.2, C58.2, L2.2, U1.49 (VDD11), U1.98 (VDD11)
unnamed: C17.2, D1.5 (IOA2), J3.R
unnamed: C18.2, D1.2 (IOB1), J3.T
unnamed: J1.A5 (CC1), R14.1
unnamed: J1.B5 (CC2), R15.2
unnamed: J1.A6 (D+), J1.B6 (D+), U2.3 (I/O2)
unnamed: J1.A7 (D-), J1.B7 (D-), U2.1 (I/O1)
unnamed: J1.SH (SHIELD), R1.1
unnamed: R31.1, U1.94 (PH3)
unnamed: L2.1, U1.46 (VLXSMPS)
unnamed: C1.2, C4.2, J1.A4 (VBUS), J1.A9 (VBUS), J1.B4 (VBUS), J1.B9 (VBUS), R33.1, U2.5 (VBUS), U3.13 (IN)
unnamed: R6.2, U3.12 (ILIM)
unnamed: R5.2, U3.16 (ISET)
unnamed: R7.2, U3.14 (TMR)
unnamed: R11.2, U3.1 (TS)
unnamed: R12.1, R13.1, U4.5 (FB)
unnamed: L1.2, U4.11 (L1)
unnamed: L1.1, U4.9 (L2)
unnamed: R10.1, U4.1 (PS/SYNC)
unnamed: C5.1, U4.3 (VAUX)
unnamed: C22.1, U5.4 (CAPM)
unnamed: C22.2, U5.2 (CAPP)
unnamed: R22.1, U5.6 (OUTL)
unnamed: R23.1, U5.7 (OUTR)
unnamed: C34.1, U6.3 (BYPASS)
unnamed: R24.2, R25.1, U6.2 (IN1-)
unnamed: R26.2, R27.2, U6.6 (IN2-)
unnamed: C18.1, R25.2, U6.1 (VO1)
unnamed: C17.1, R27.1, U6.7 (VO2)
unnamed: C16.1, U10.3 (ONT)
unnamed: SW1.2, U10.2 (PB)
unnamed: C15.1, U10.7 (PDT)
