AnnaHruskova/Hruskova_Portable_Audio_Player_with_USB_Audio_Interface/Software/AudioPlayer/AudioPlayer.ioc

Mcu.UserName=STM32U575VITxQ
PA11.Signal=USB_OTG_FS_DM
PA12.Signal=USB_OTG_FS_DP
PA2.GPIO_Label=DAC_XSMT
PA2.Signal=GPIO_Output
PA9.GPIO_Label=USB_VBUS_DET
PA9.Signal=GPIO_Input
PB0.GPIO_Label=SD_DET
PB0.Signal=GPIO_Input
PB1.GPIO_Label=AMP_SHDW
PB1.Signal=GPIO_Output
PB10.GPIO_Label=LTC_KILL
PB10.Signal=GPIO_Output
PB11.GPIO_Label=LTC_INT
PB11.Signal=GPXTI11
PB13.GPIO_Label=CHG_DISABLE
PB13.Signal=GPIO_Output
PB14.GPIO_Label=CHG_EN1
PB14.Signal=GPIO_Output
PB15.GPIO_Label=CHG_PGOOD
PB15.Signal=GPIO_Input
PB5.Signal=SPI1_MOSI
PB6.GPIO_Label=OLED_CS
PB6.Signal=GPIO_Output
PB7.GPIO_Label=OLED_DC
PB7.Signal=GPIO_Output
PB8.GPIO_Label=OLED_RST
PB8.Signal=GPIO_Output
PC0.GPIO_Label=CHG_STATUS
PC0.Signal=GPIO_Input
PC10.Signal=SDMMC1_D2
PC11.Signal=SDMMC1_D3
PC12.Signal=SDMMC1_CK
PC6.GPIO_Label=BTN_PLAY
PC6.Signal=GPIO_Input
PC7.GPIO_Label=BTN_NEXT
PC7.Signal=GPIO_Input
PC8.Signal=SDMMC1_D0
PC9.Signal=SDMMC1_D1
PD0.GPIO_Label=BTN_PREV
PD0.Signal=GPIO_Input
PD1.GPIO_Label=BTN_VOL_UP
PD1.Signal=GPIO_Input
PD2.Signal=SDMMC1_CMD
PD3.GPIO_Label=BTN_VOL_DOWN
PD3.Signal=GPIO_Input
PE4.Signal=SAI1_FS_A
PE5.Signal=SAI1_SCK_A
PE6.Signal=SAI1_SD_A
