AnnaHruskova/Hruskova_Portable_Audio_Player_with_USB_Audio_Interface/(commit log)

2026-10-23 kicad, cubemx, text
2026-10-26 latex, footprints
2026-10-27 footprints, excel
2026-10-29 ioc, kicad
2026-11-09 kicad, footprints edit, spreadsheet list of components
2026-11-12 latex, power
2026-11-13 latex, power, bq
